AtlasAutoware/carv1/cad/Mounts/original/README.md

# Original mounts

The five STLs that were in Mounts/ before the parametric set (commit 55734f5 removed them by
mistake; restored here unchanged). They are for the original 15-hole Baseplate and do not use
the clipless foot interface.
