AtlasAutoware/carv1/cad/Electronics/srp1265a_layout.png

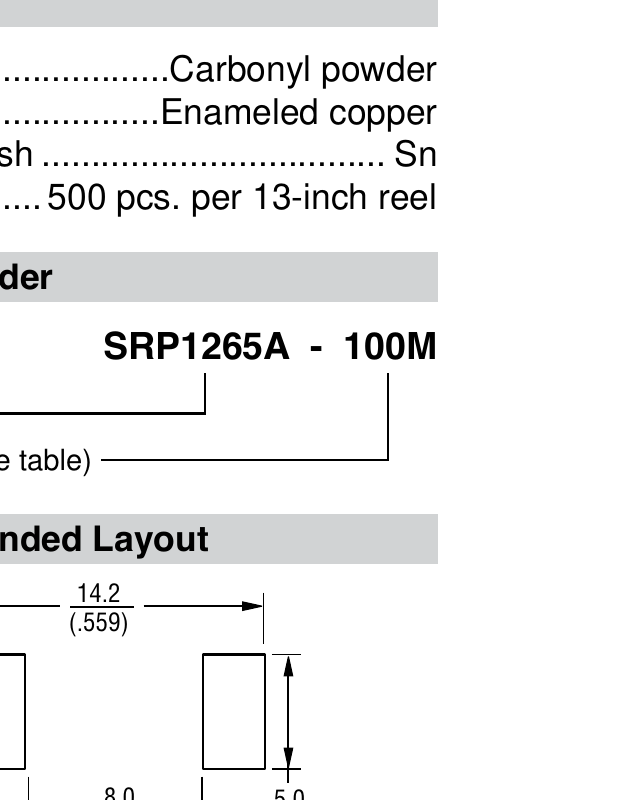
cad/Electronics/srp1265a_layout.png
