AtlasAutoware/carv1/cad/Electronics/top_preview.png

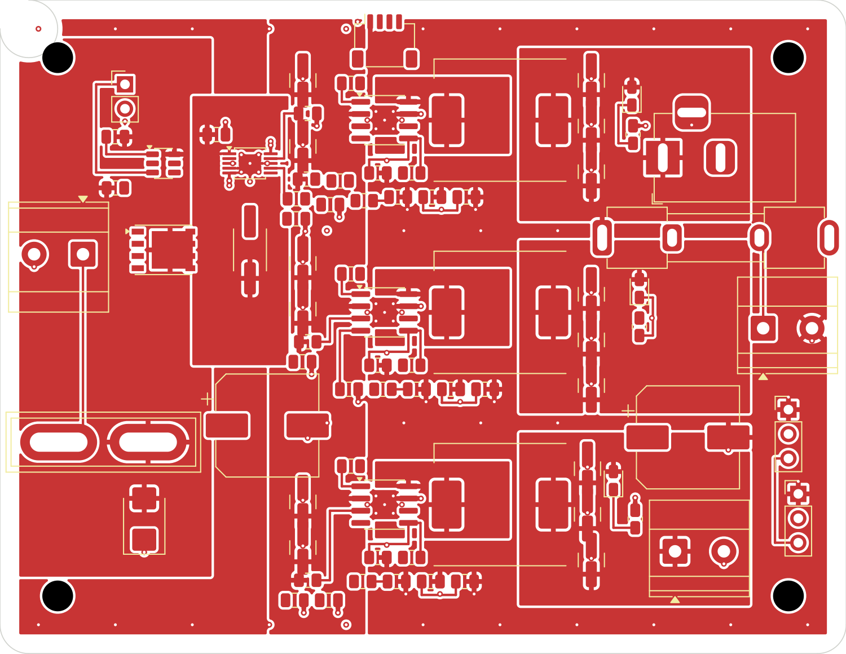
cad/Electronics/top_preview.png
