AtlasAutoware/carv1/cad/Mounts/newcar/out/baseplate_v2_newcar.png

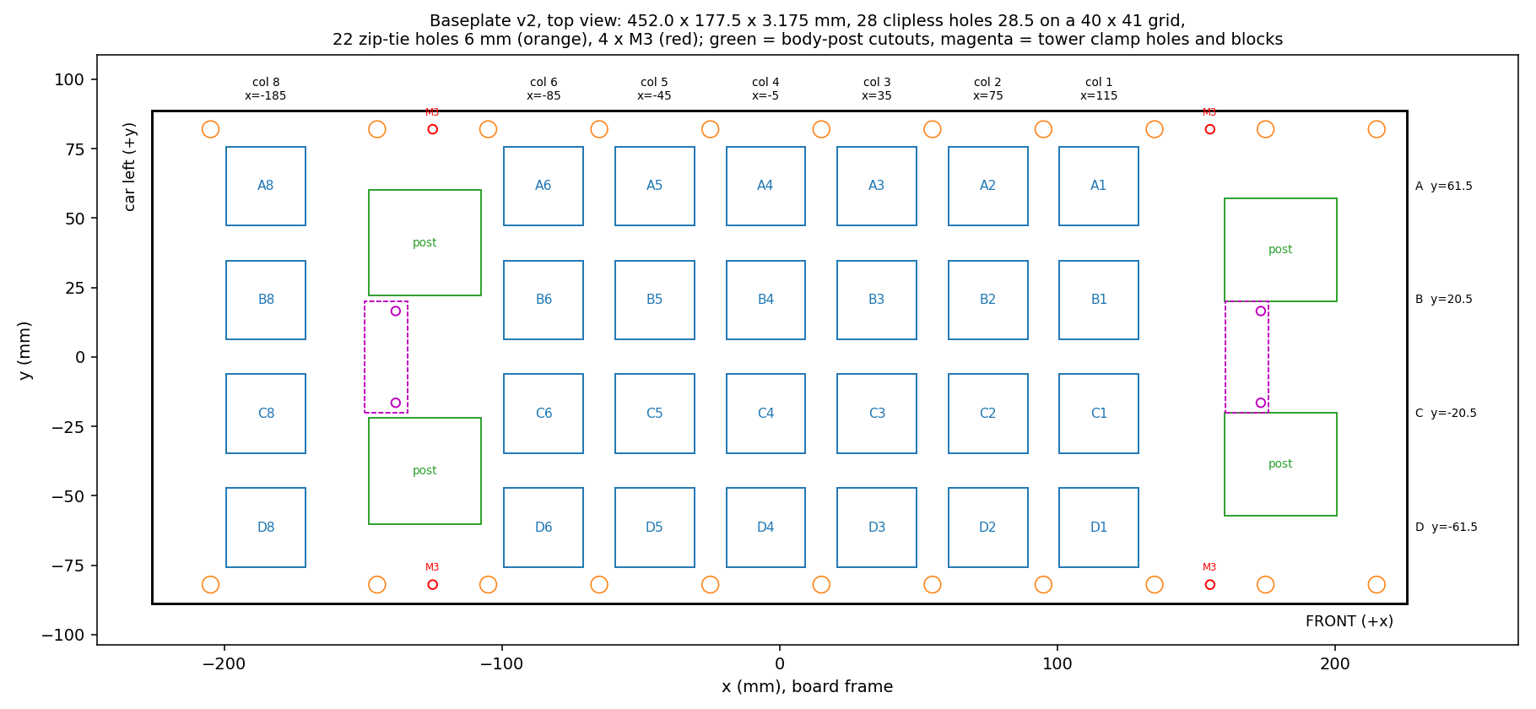
cad/Mounts/newcar/out/baseplate_v2_newcar.png
