AtlasAutoware/carv1/cad/Mounts/newcar/out/battery_bank_underslung.png

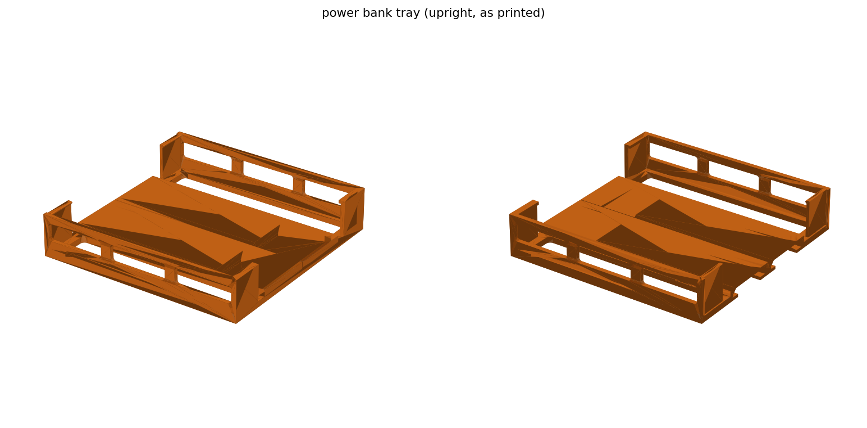
cad/Mounts/newcar/out/battery_bank_underslung.png
