AtlasAutoware/carv1/cad/Mounts/newcar/out/battery_bank_underslung_lines.png

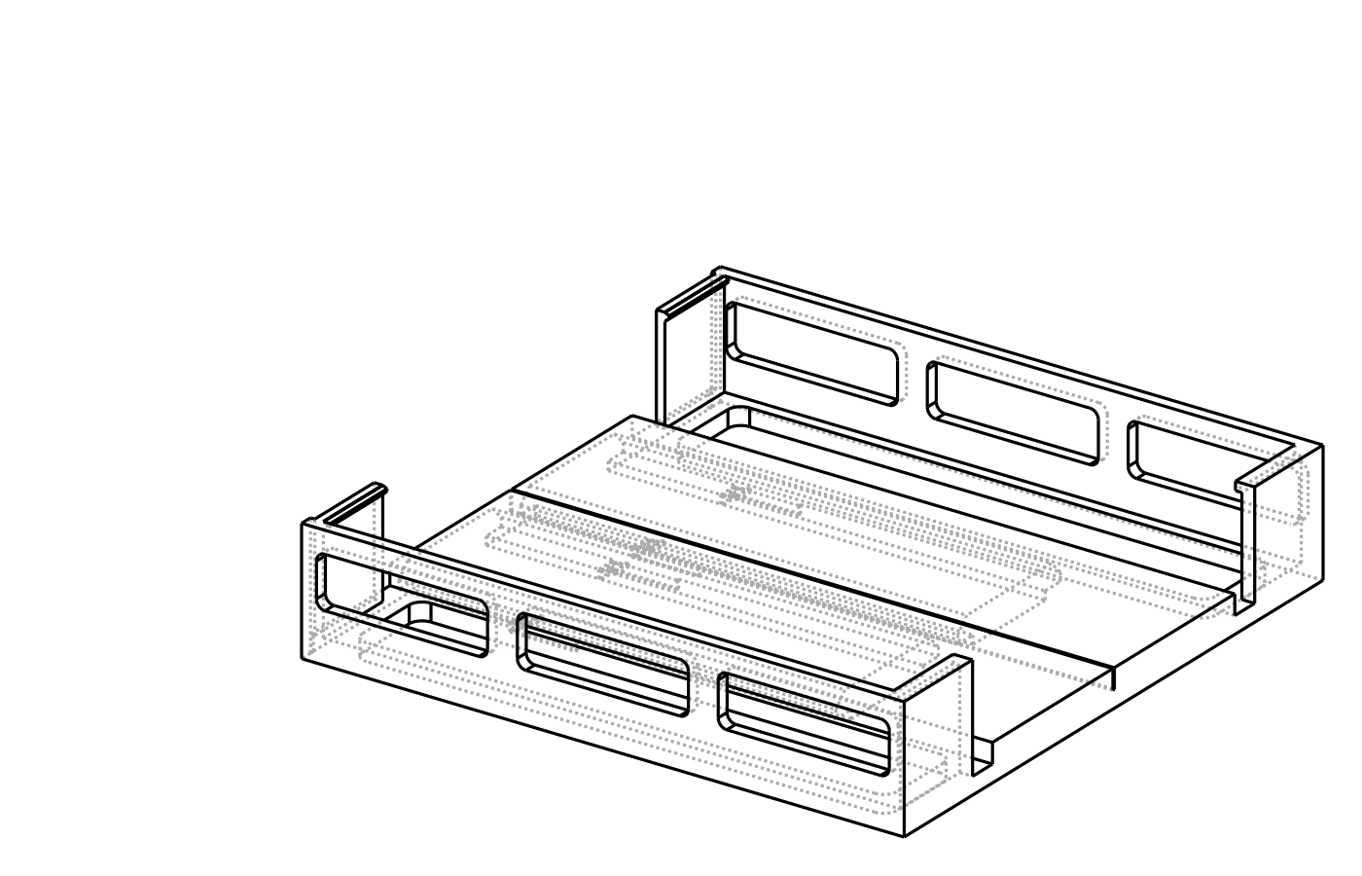
cad/Mounts/newcar/out/battery_bank_underslung_lines.png
