AtlasAutoware/carv1/cad/Mounts/newcar/out/newcar_layout_above_bottom.png

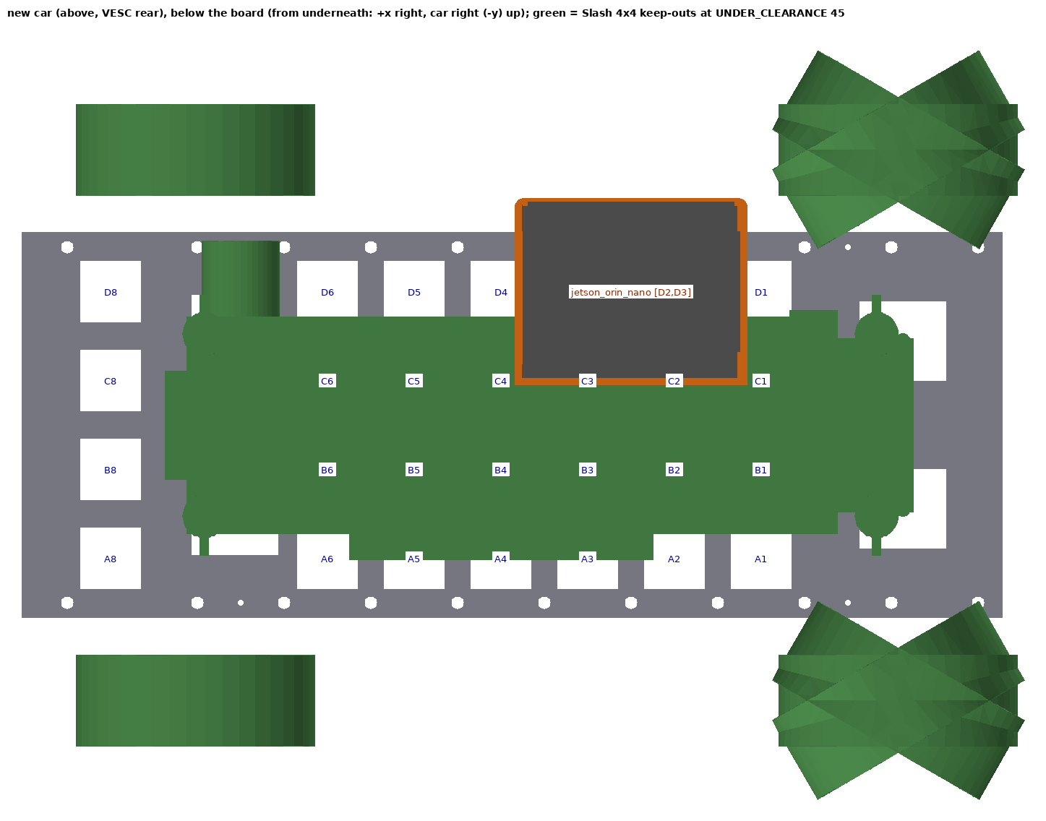
cad/Mounts/newcar/out/newcar_layout_above_bottom.png
