AtlasAutoware/carv1/cad/Mounts/newcar/out/newcar_layout_above_vescsaddle_side.png

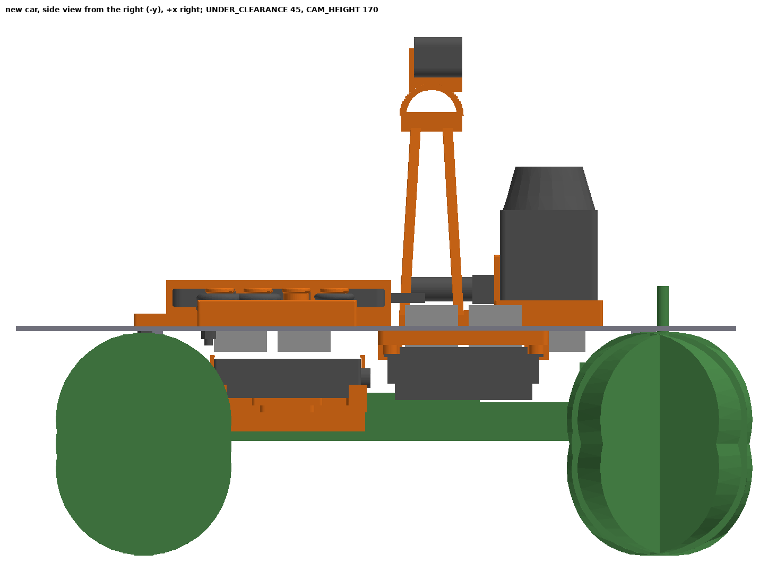
cad/Mounts/newcar/out/newcar_layout_above_vescsaddle_side.png
