AtlasAutoware/carv1/cad/Mounts/newcar/out/newcar_layout_blade100_bottom.png

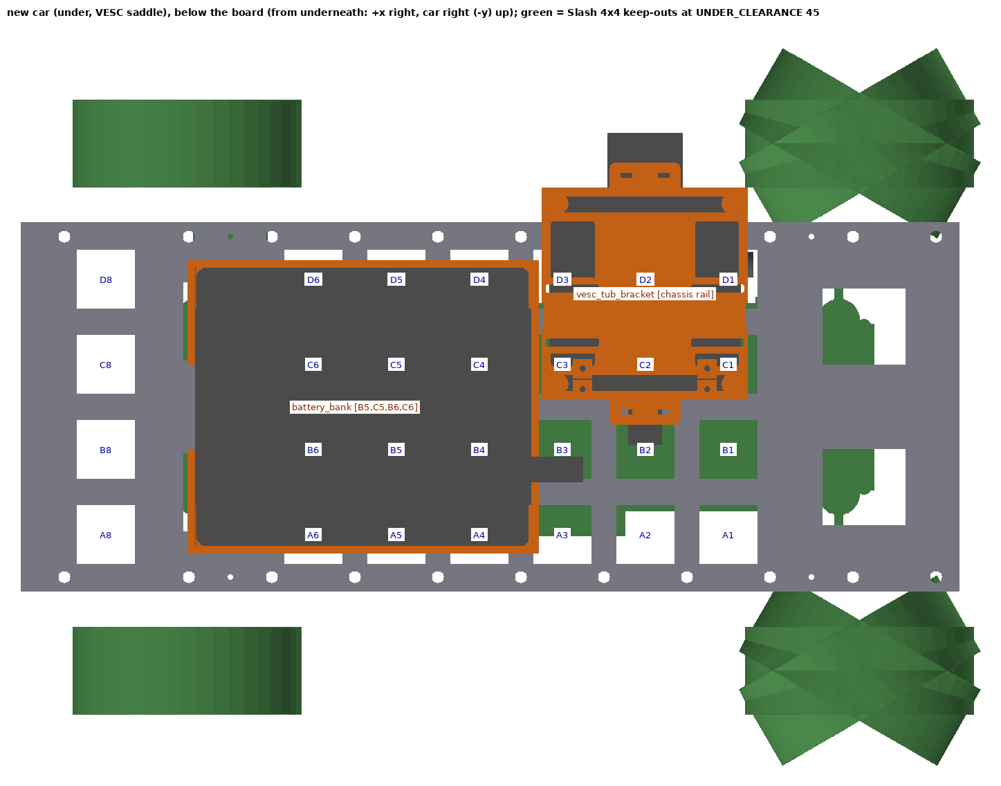
cad/Mounts/newcar/out/newcar_layout_blade100_bottom.png
