AtlasAutoware/carv1/cad/Mounts/newcar/out/newcar_layout_blade100_lines.png

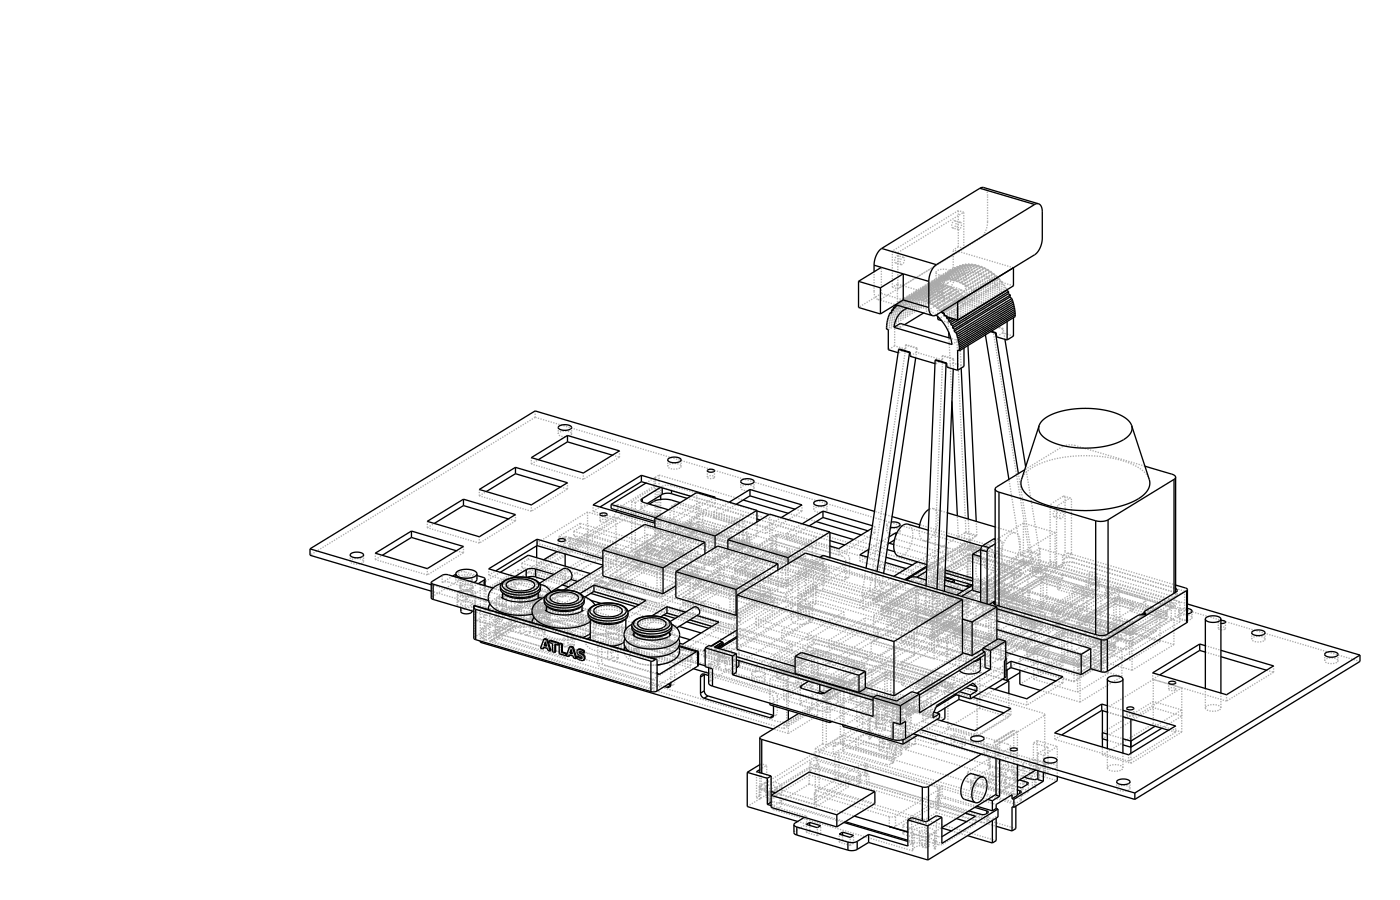
cad/Mounts/newcar/out/newcar_layout_blade100_lines.png
