AtlasAutoware/carv1/cad/Mounts/newcar/out/newcar_layout_blade100_top.png

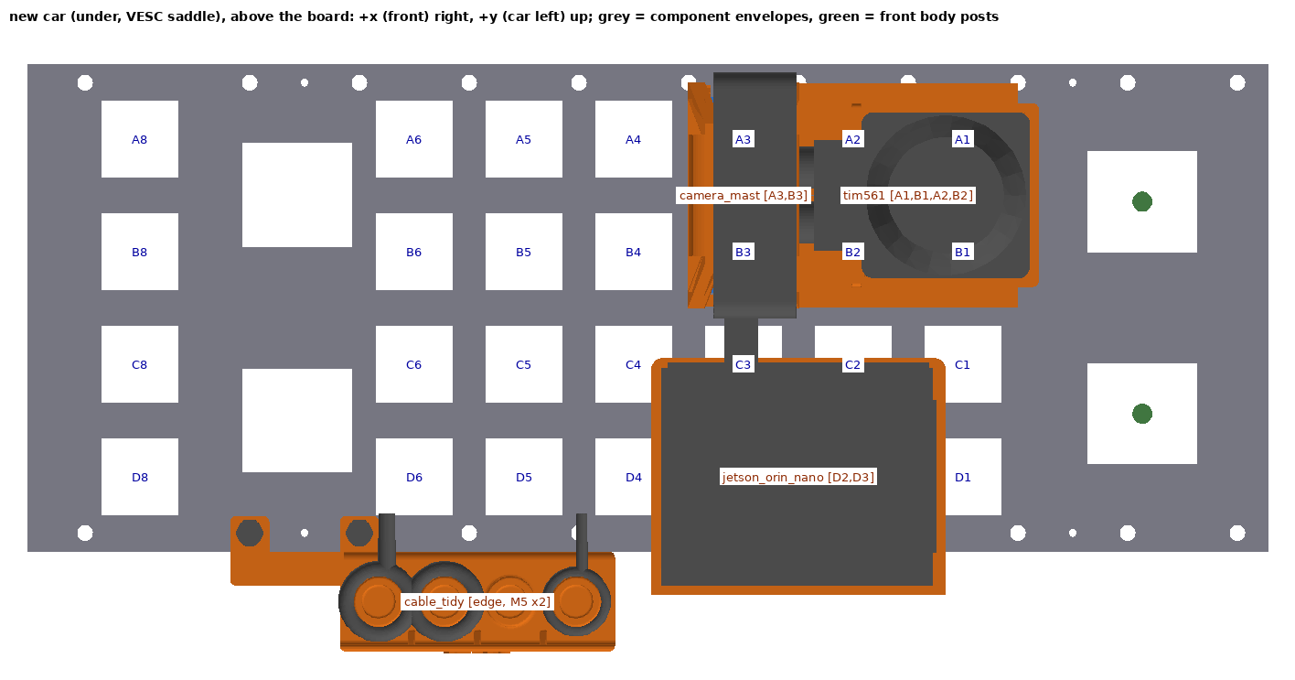
cad/Mounts/newcar/out/newcar_layout_blade100_top.png
