AtlasAutoware/carv1/cad/Mounts/newcar/out/tim561.png

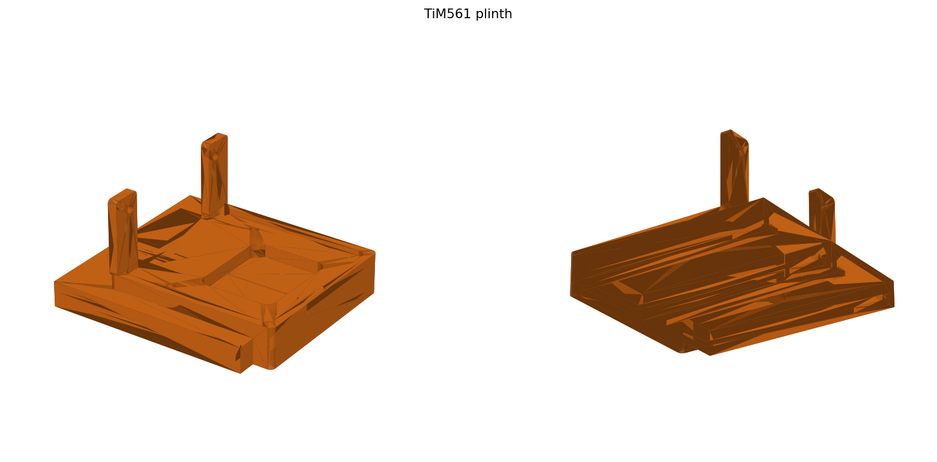
cad/Mounts/newcar/out/tim561.png
