AtlasAutoware/carv1/cad/Mounts/newcar/out/tim561_lines.png

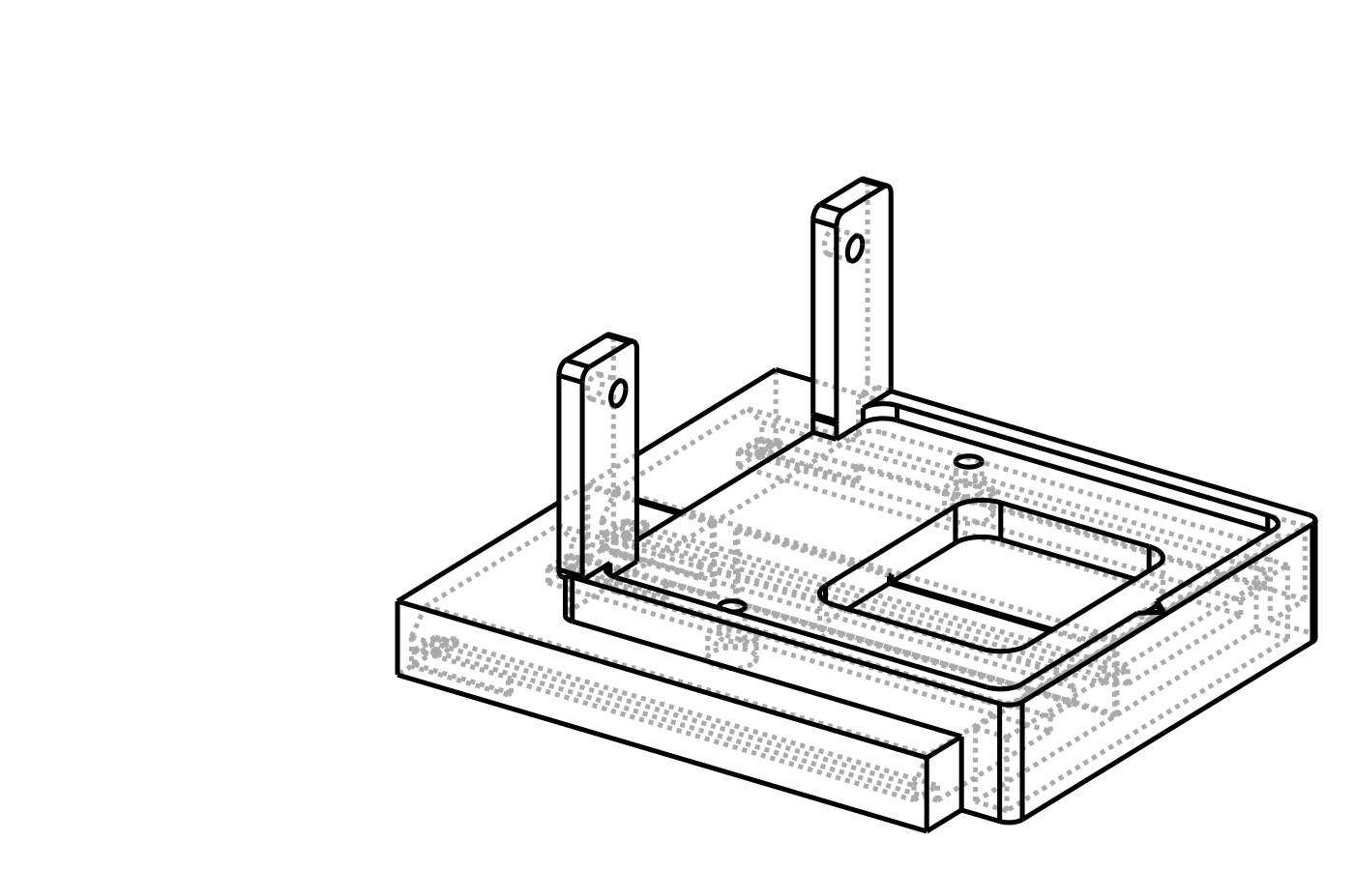
cad/Mounts/newcar/out/tim561_lines.png
