AtlasAutoware/carv1/cad/Mounts/out/_attempt_tidy_bottom.png

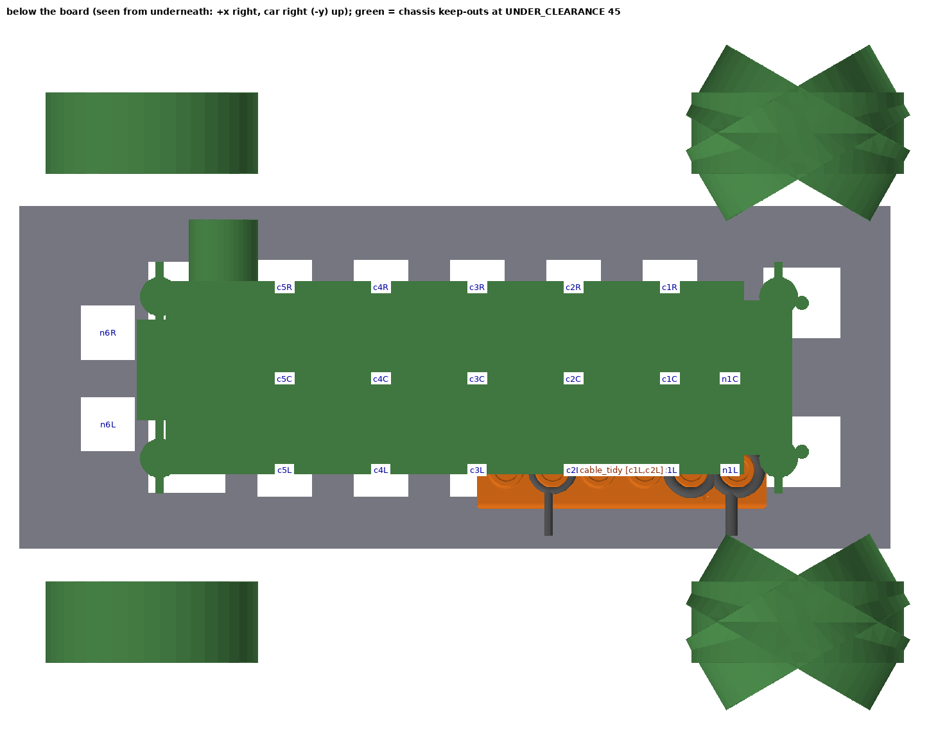
cad/Mounts/out/_attempt_tidy_bottom.png
