AtlasAutoware/carv1/cad/Mounts/out/_cable_tidy_closeup.png

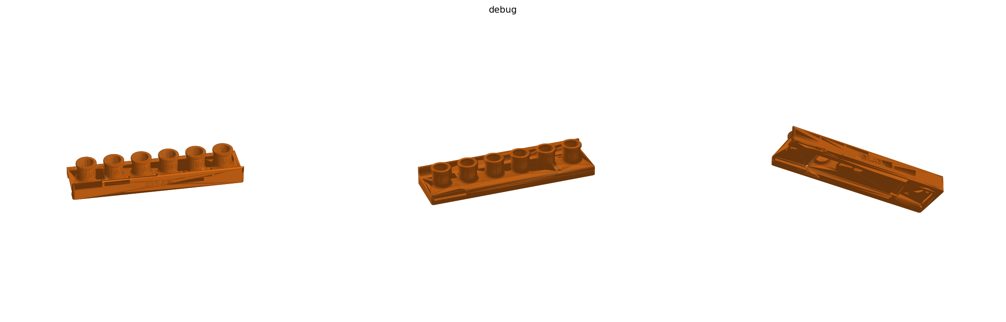
cad/Mounts/out/_cable_tidy_closeup.png
