AtlasAutoware/carv1/cad/Mounts/out/_dirtest.png

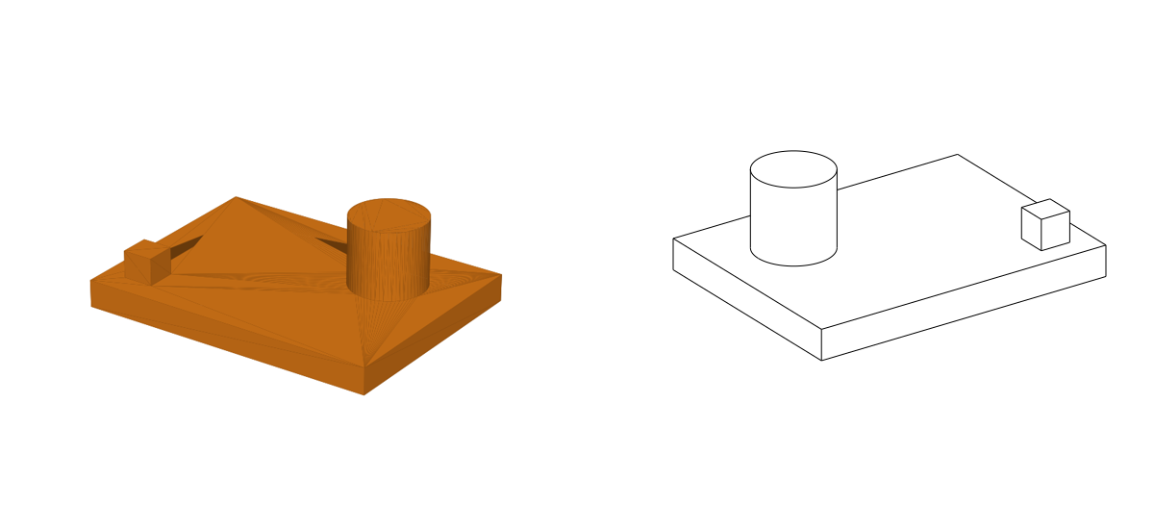
cad/Mounts/out/_dirtest.png
