AtlasAutoware/carv1/cad/Mounts/out/_omni_sections.png

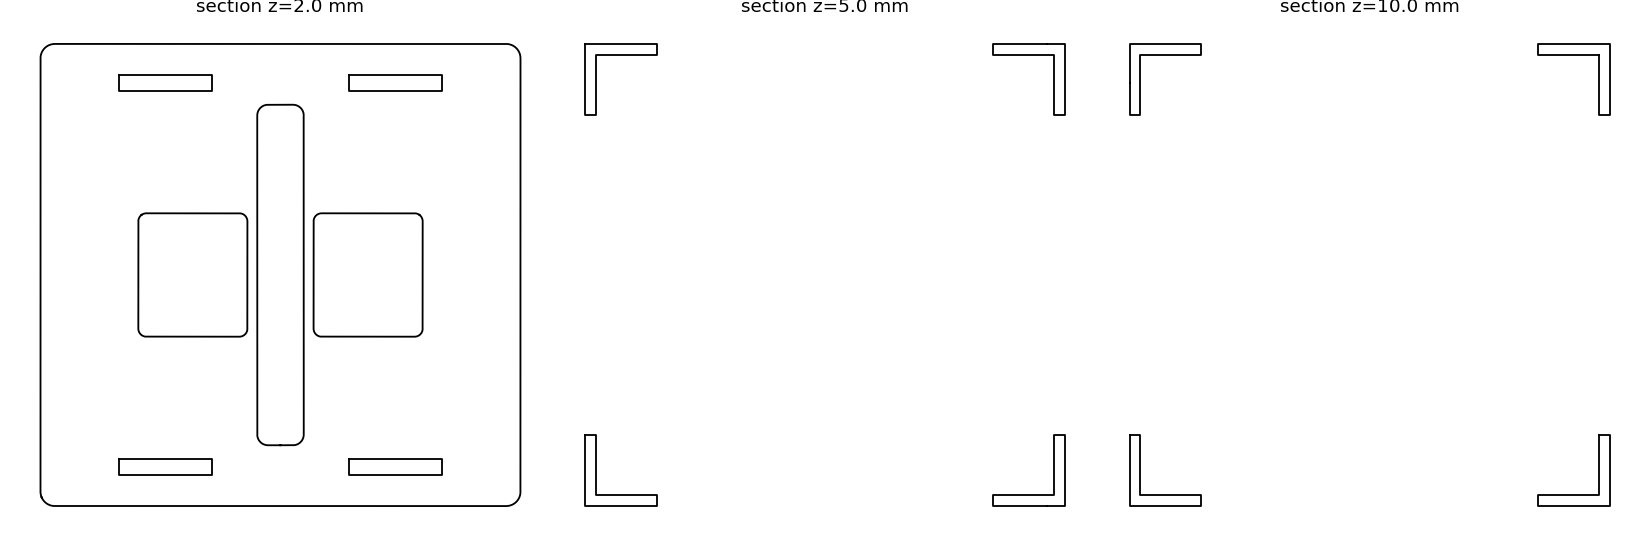
cad/Mounts/out/_omni_sections.png
