AtlasAutoware/carv1/cad/Mounts/out/baseplate_v2.png

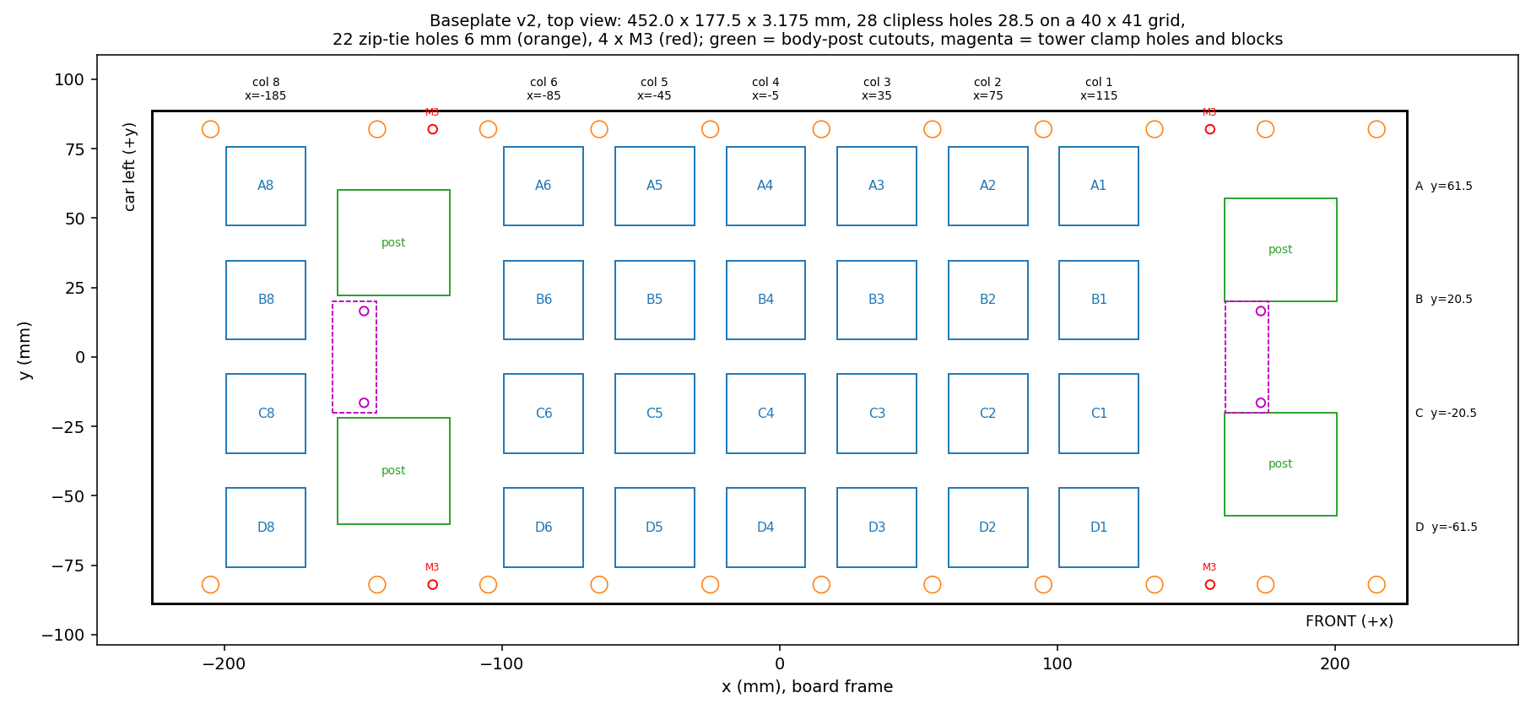
cad/Mounts/out/baseplate_v2.png
