AtlasAutoware/carv1/cad/Mounts/out/board_layout_bottom.png

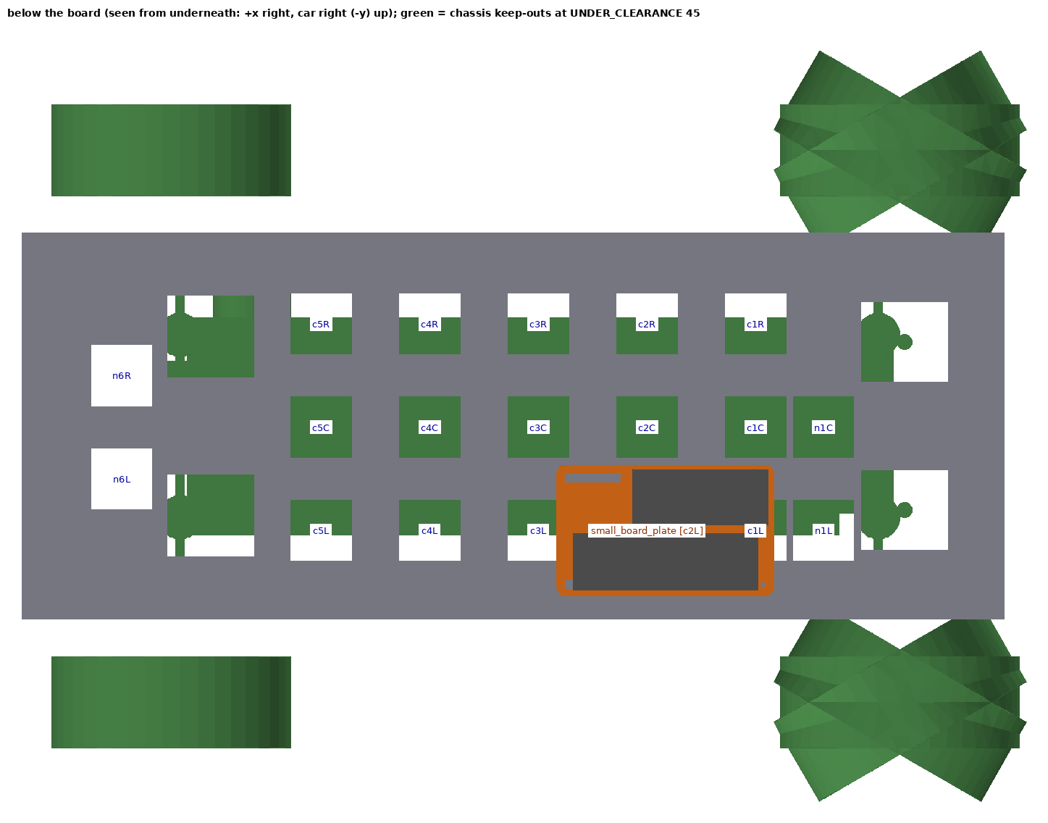
cad/Mounts/out/board_layout_bottom.png
