AtlasAutoware/carv1/cad/Mounts/out/board_layout_front.png

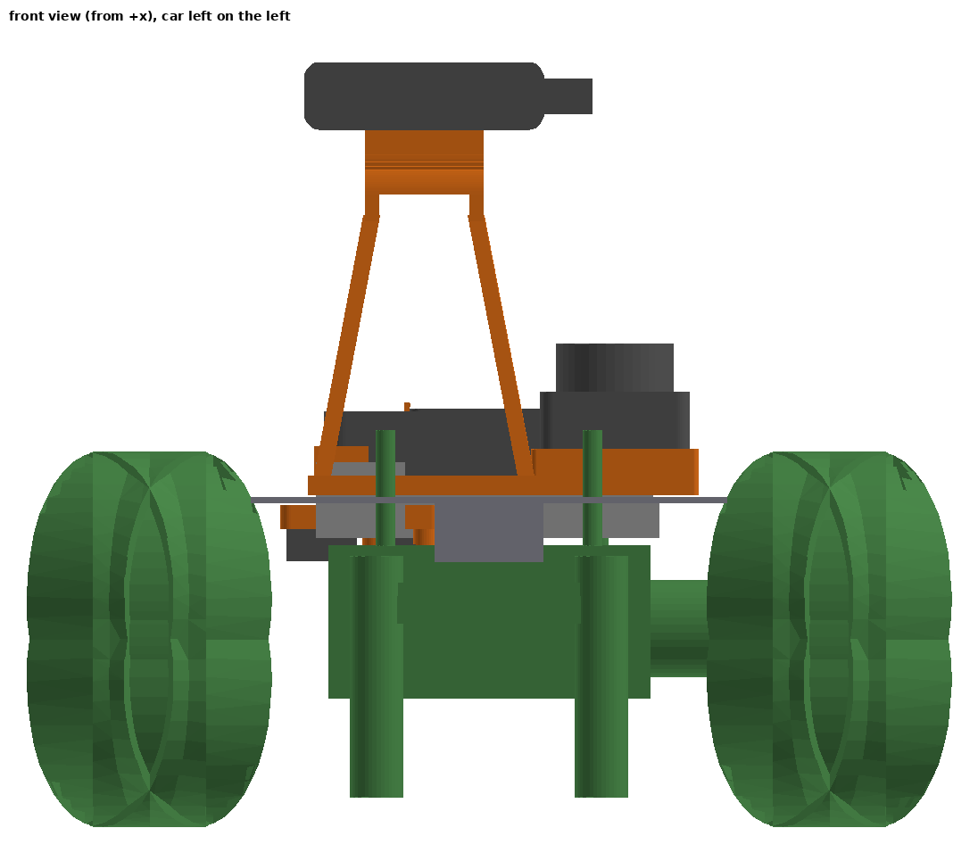
cad/Mounts/out/board_layout_front.png
