AtlasAutoware/carv1/cad/Mounts/out/board_layout_lines.png

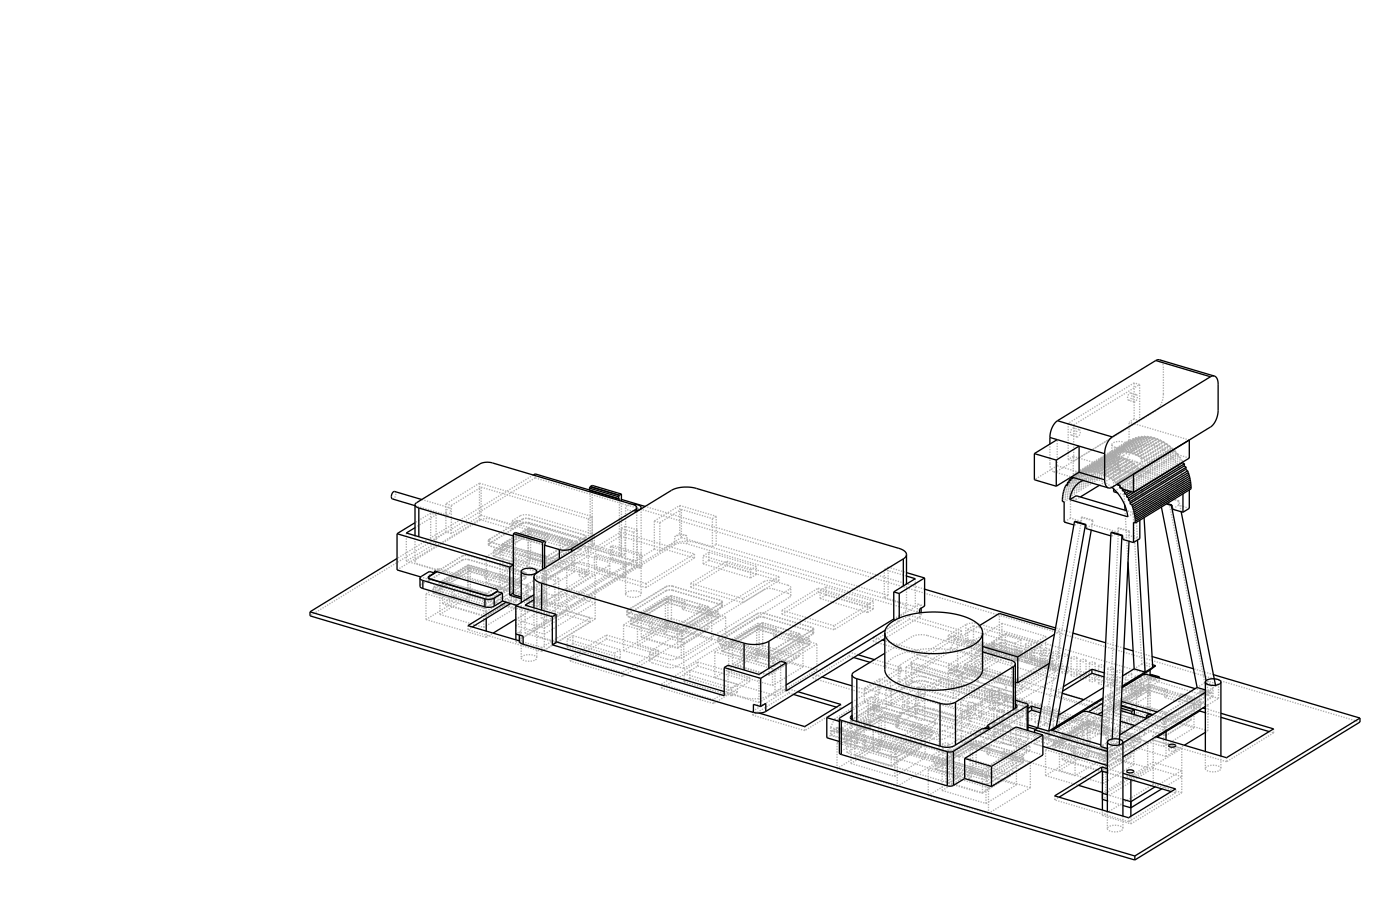
cad/Mounts/out/board_layout_lines.png
