AtlasAutoware/carv1/cad/Mounts/out/board_layout_side.png

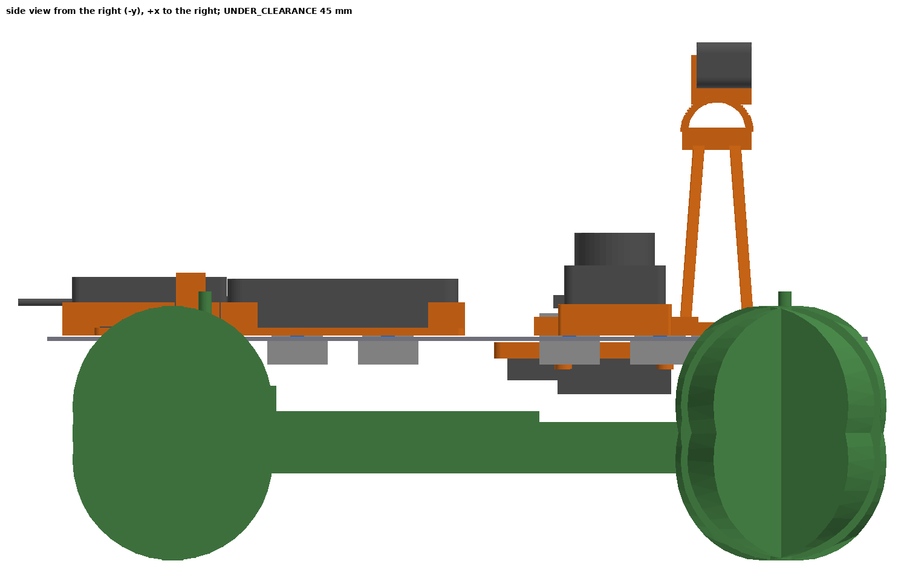
cad/Mounts/out/board_layout_side.png
