AtlasAutoware/carv1/cad/Mounts/out/board_layout_top.png

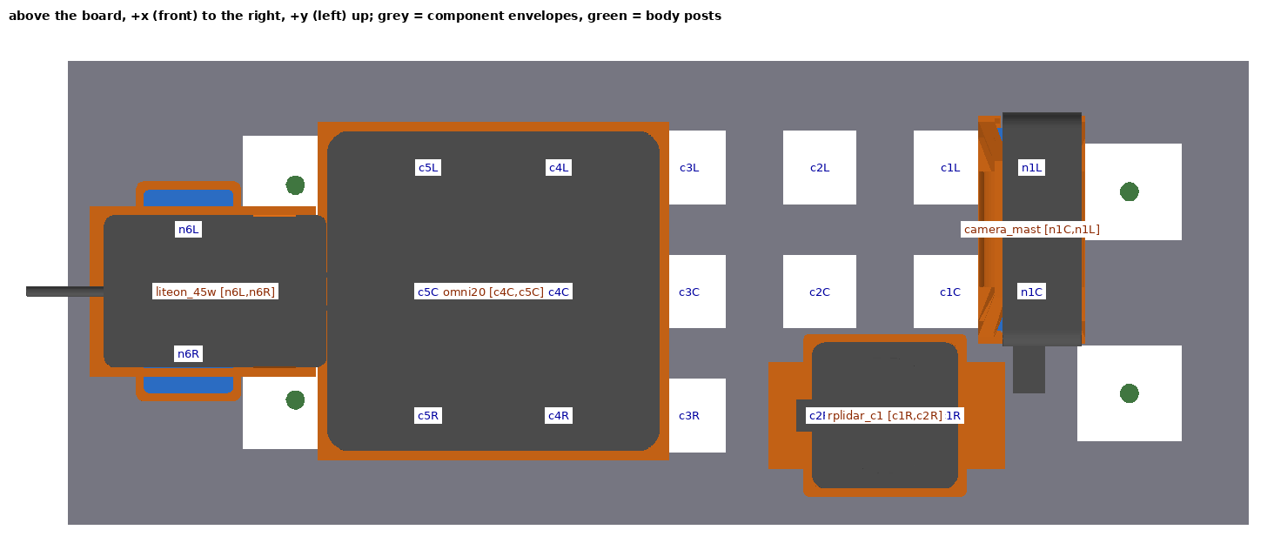
cad/Mounts/out/board_layout_top.png
