AtlasAutoware/carv1/cad/Mounts/out/board_layout_v2_bottom.png

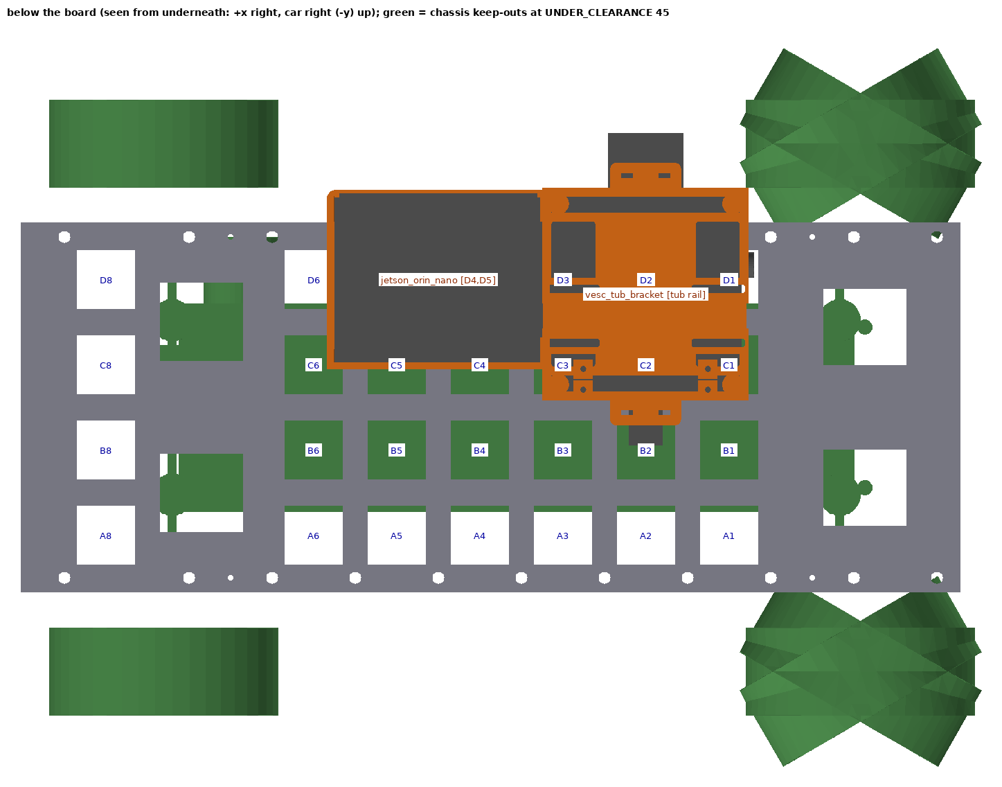
cad/Mounts/out/board_layout_v2_bottom.png
