AtlasAutoware/carv1/cad/Mounts/out/board_layout_v2_front.png

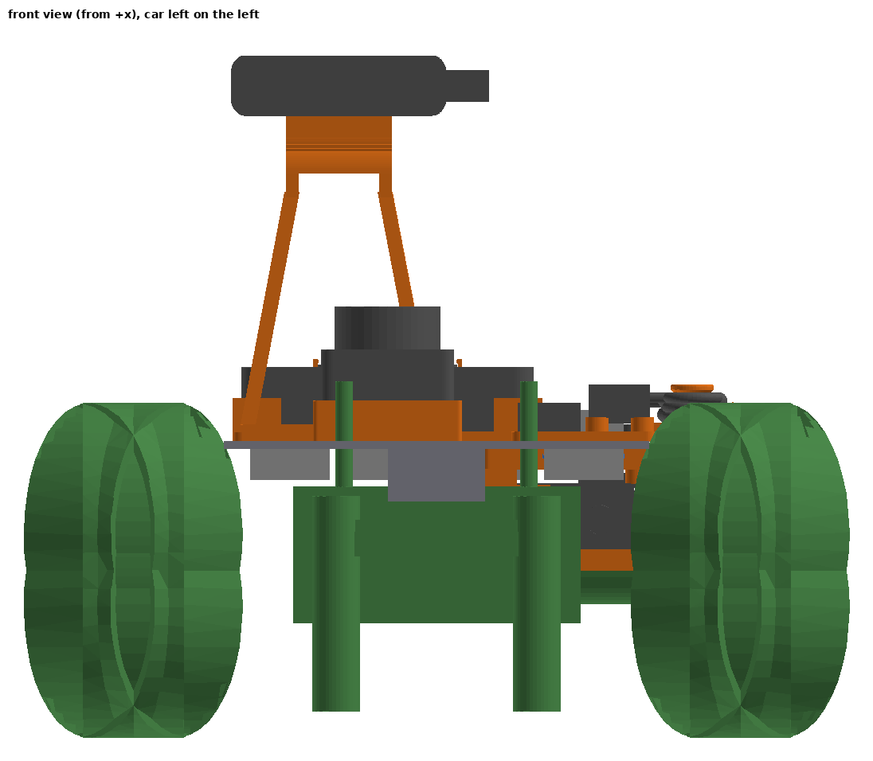
cad/Mounts/out/board_layout_v2_front.png
