AtlasAutoware/carv1/cad/Mounts/out/board_layout_v2_mastB3C3_lines.png

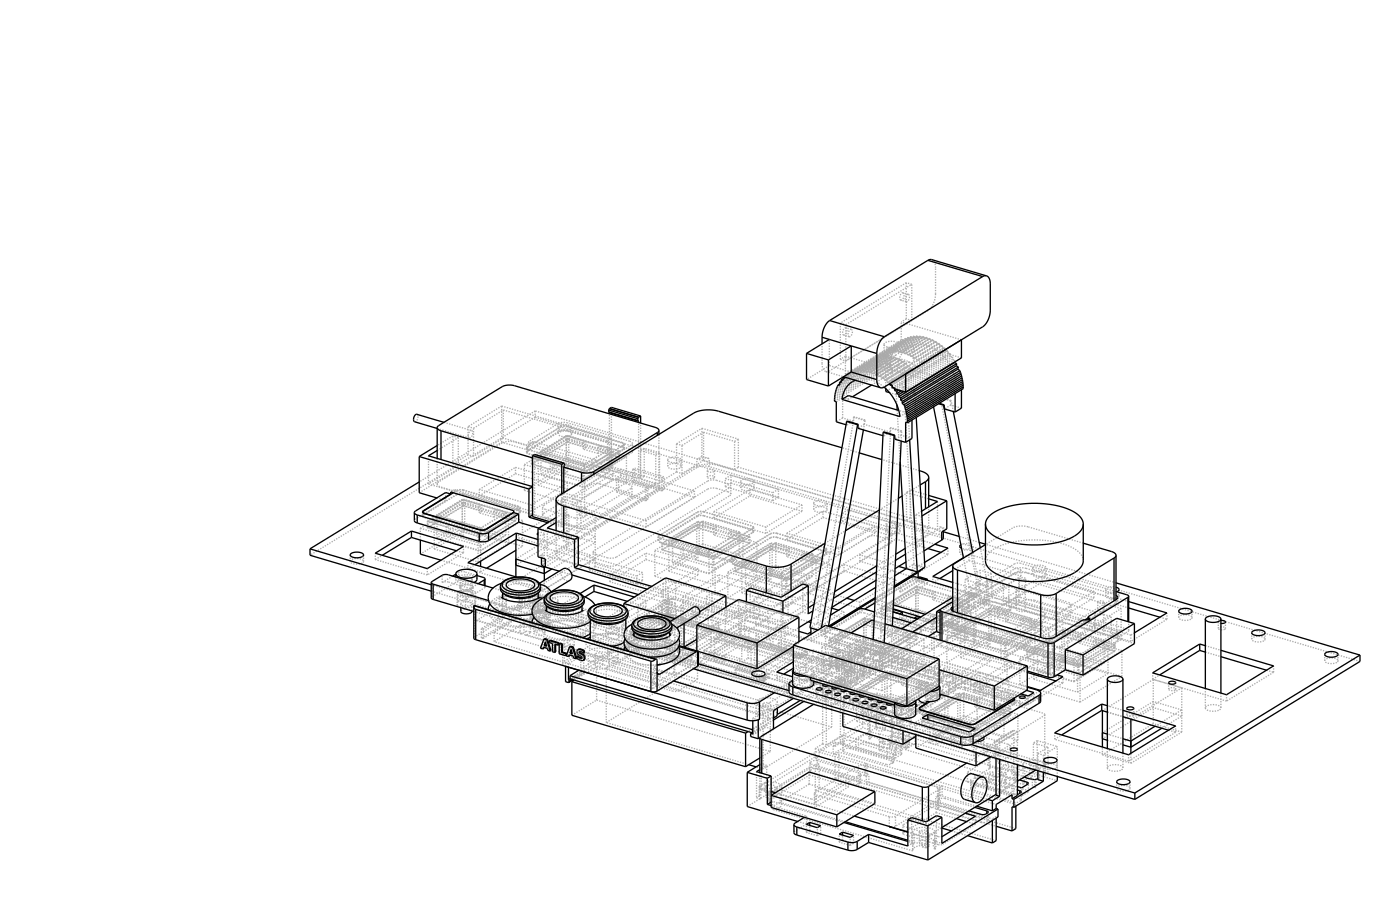
cad/Mounts/out/board_layout_v2_mastB3C3_lines.png
