AtlasAutoware/carv1/cad/Mounts/out/board_layout_v2_mastB4C4_lines.png

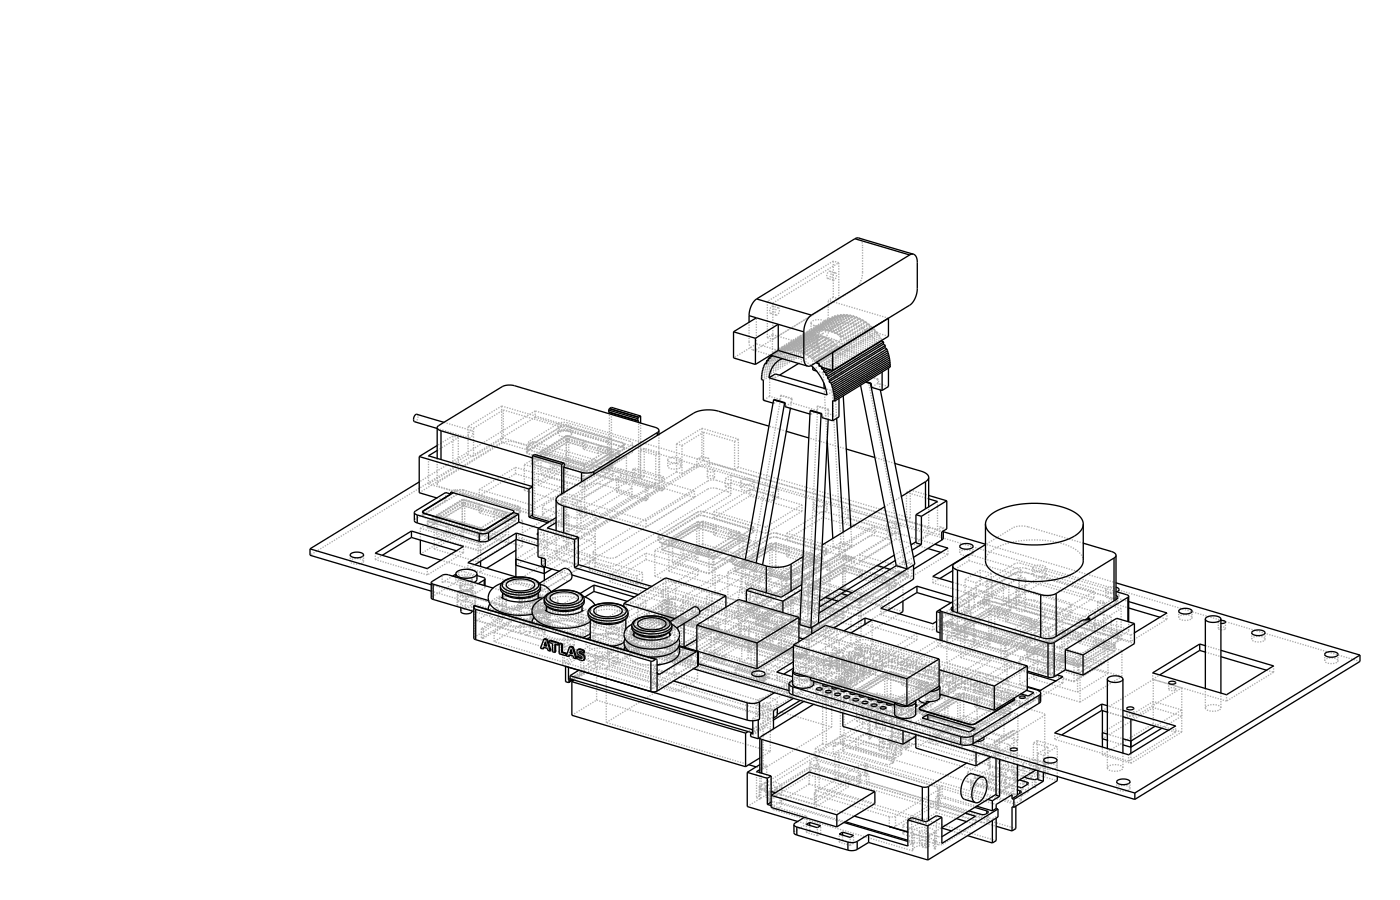
cad/Mounts/out/board_layout_v2_mastB4C4_lines.png
