AtlasAutoware/carv1/cad/Mounts/out/board_layout_v2_tidy_bottom.png

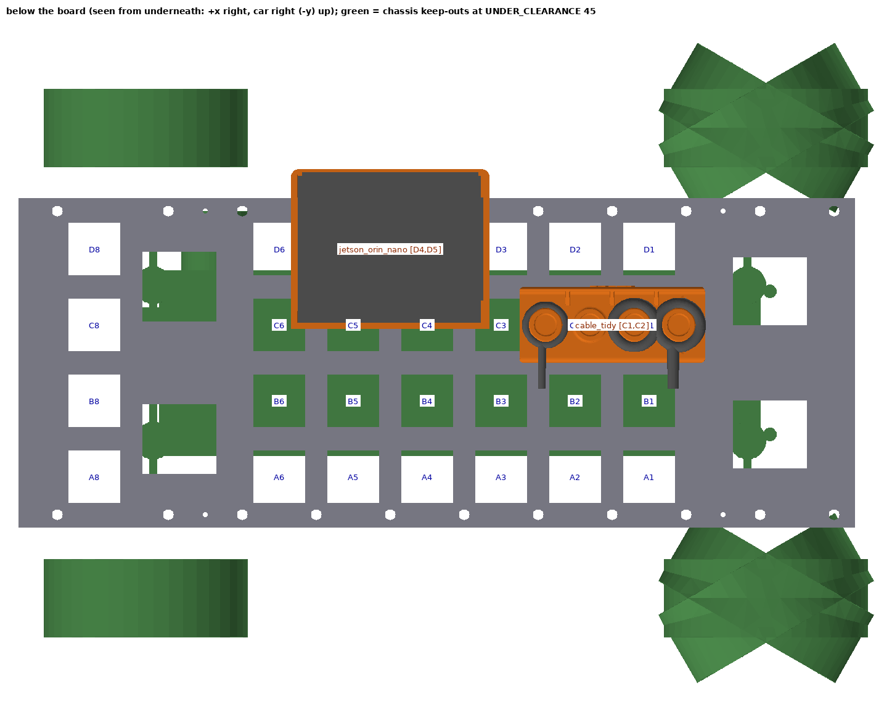
cad/Mounts/out/board_layout_v2_tidy_bottom.png
