AtlasAutoware/carv1/cad/Mounts/out/board_layout_v2_tidy_lines.png

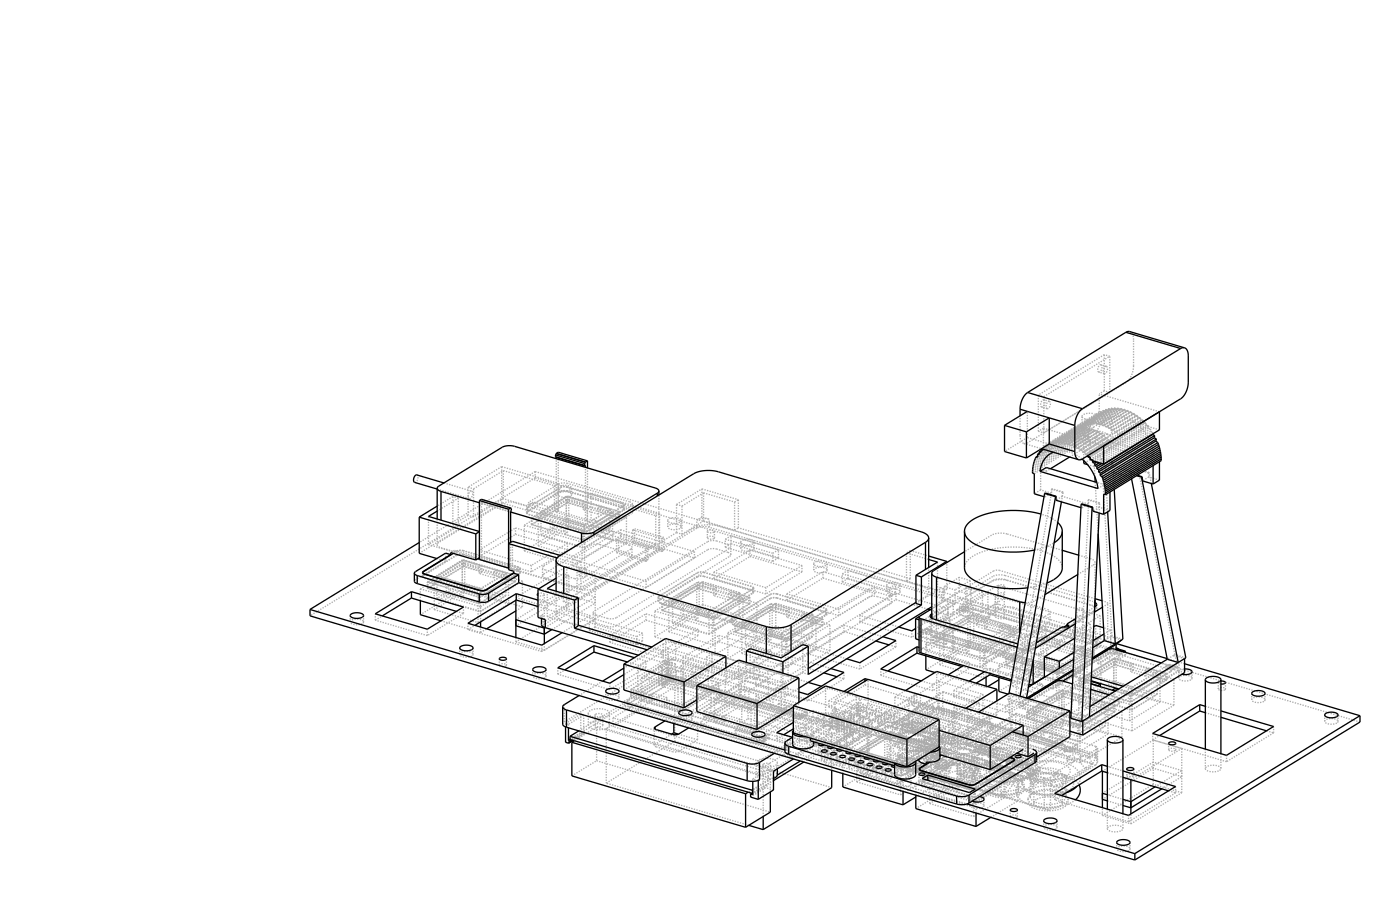
cad/Mounts/out/board_layout_v2_tidy_lines.png
