AtlasAutoware/carv1/cad/Mounts/out/board_layout_v2_tidy_side.png

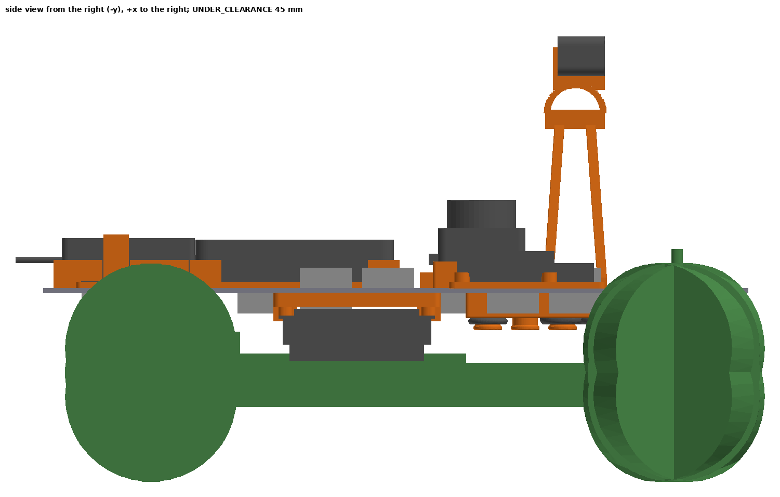
cad/Mounts/out/board_layout_v2_tidy_side.png
