AtlasAutoware/carv1/cad/Mounts/out/board_layout_v2_tidy_top.png

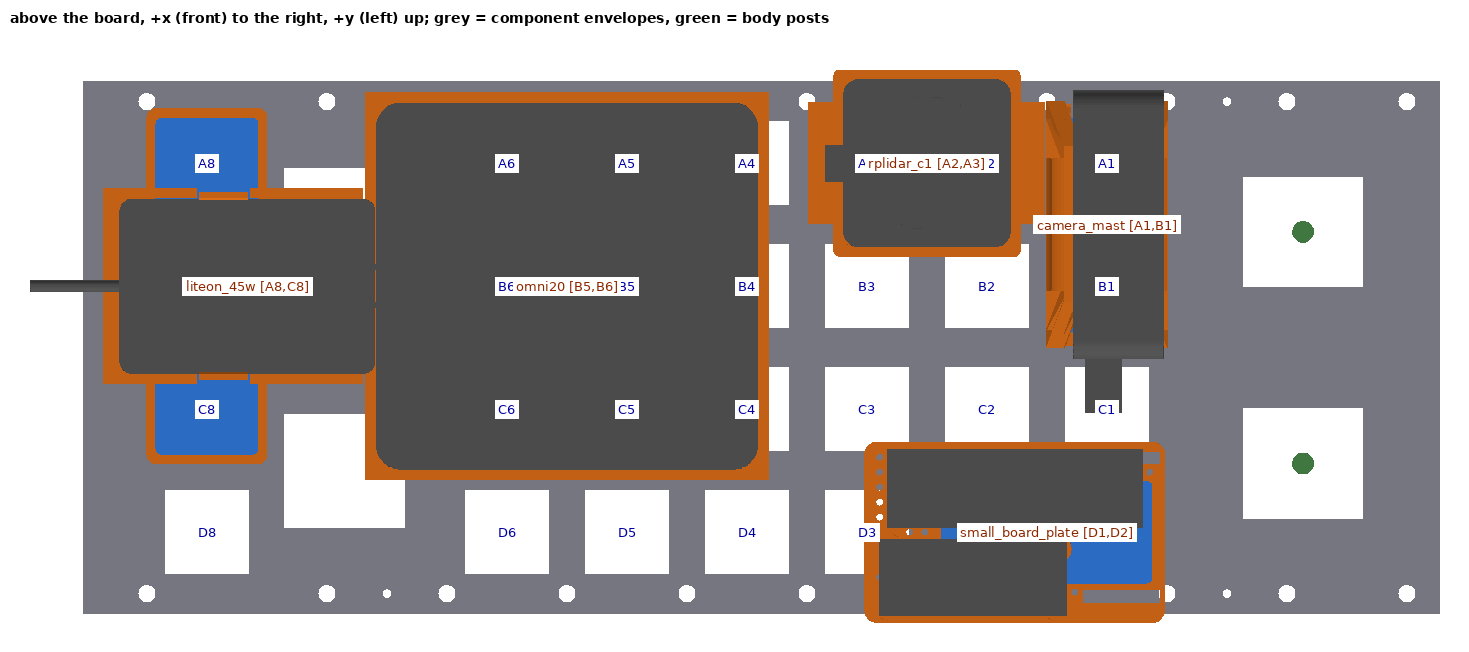
cad/Mounts/out/board_layout_v2_tidy_top.png
