AtlasAutoware/carv1/cad/Mounts/out/board_layout_v2_vesc_bottom.png

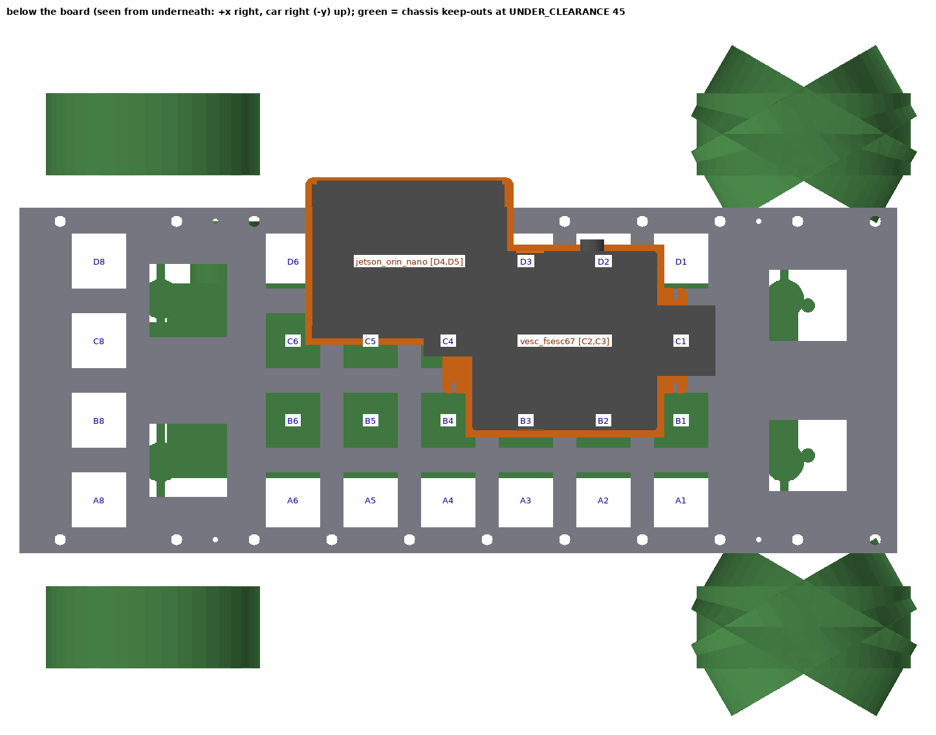
cad/Mounts/out/board_layout_v2_vesc_bottom.png
