AtlasAutoware/carv1/cad/Mounts/out/cable_tidy.png

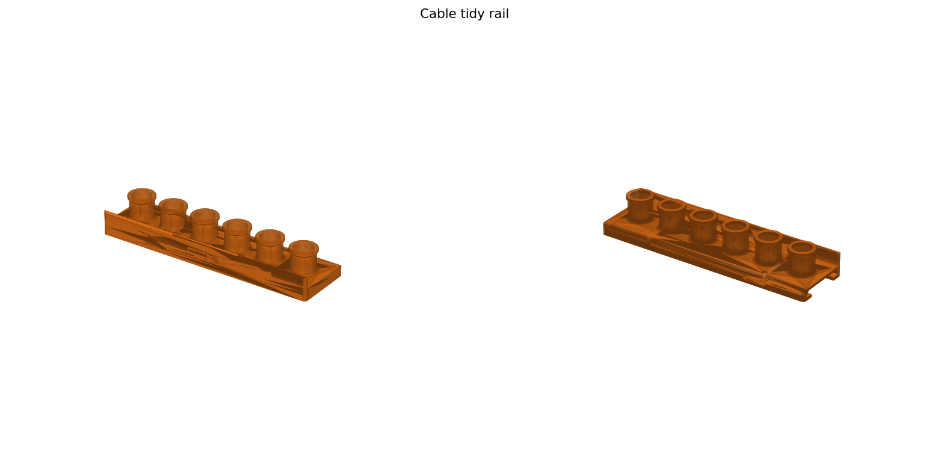
cad/Mounts/out/cable_tidy.png
