AtlasAutoware/carv1/cad/Mounts/out/cable_tidy_100_lines.png

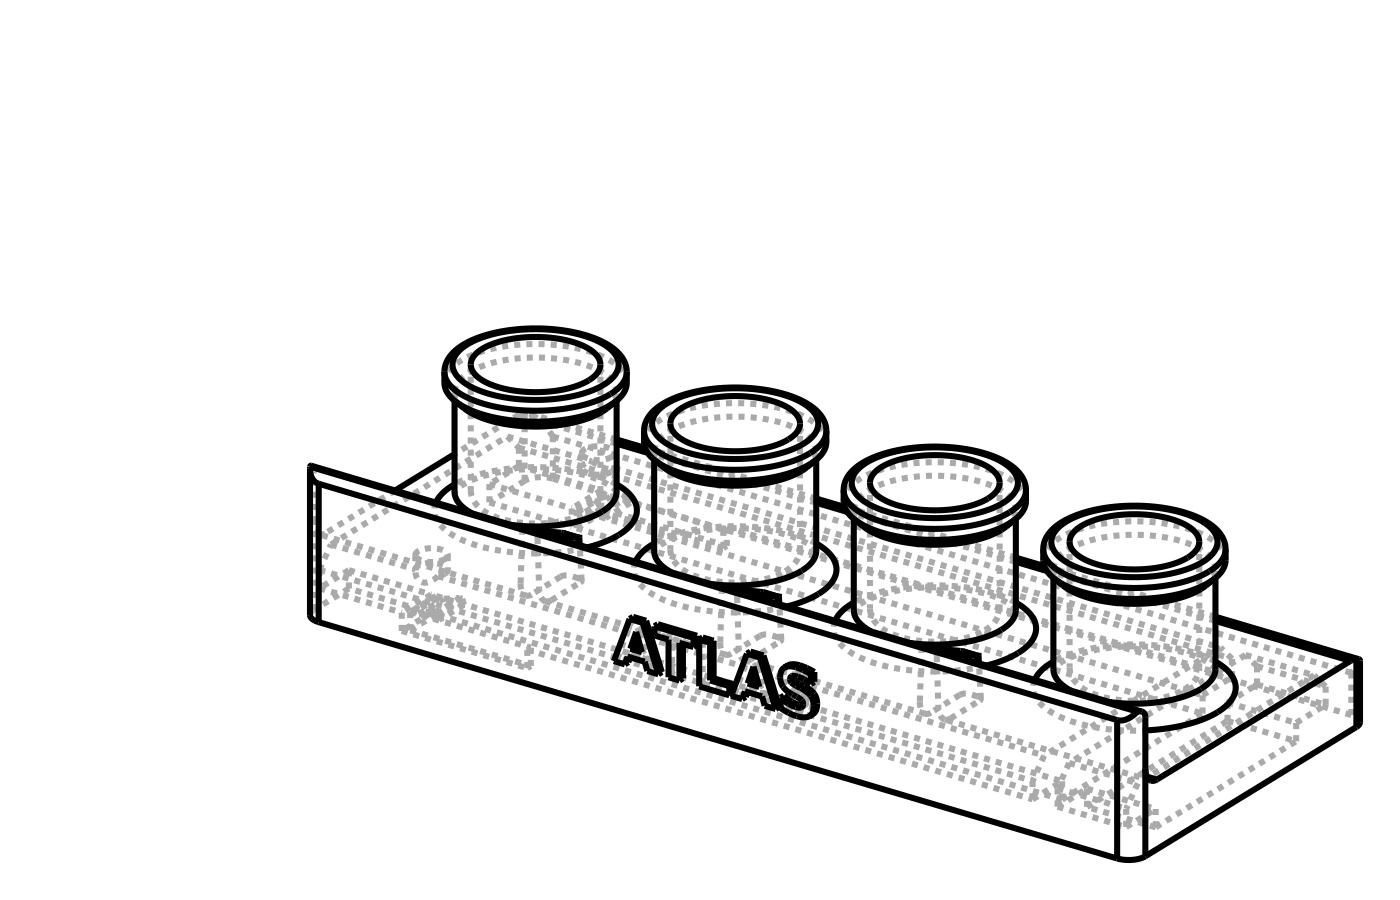
cad/Mounts/out/cable_tidy_100_lines.png
