AtlasAutoware/carv1/cad/Mounts/out/cable_tidy_edge_lines.png

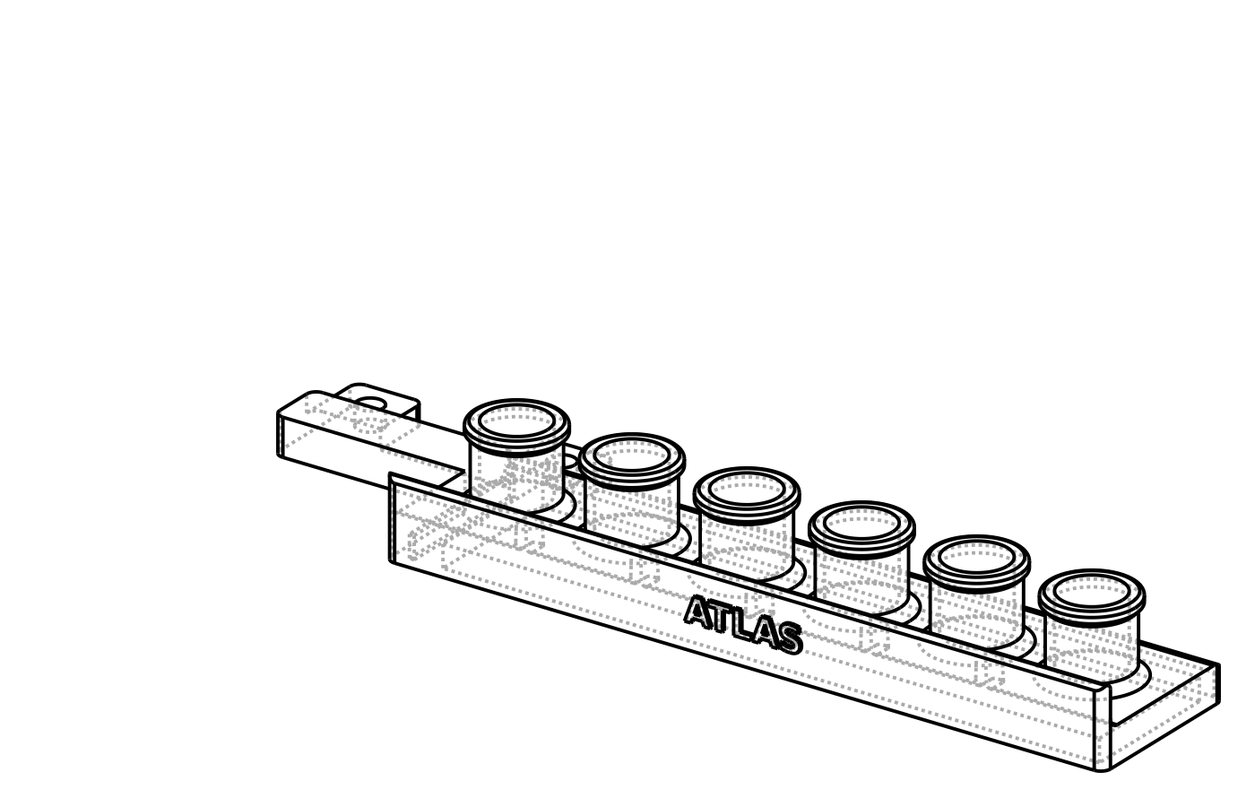
cad/Mounts/out/cable_tidy_edge_lines.png
