AtlasAutoware/carv1/cad/Mounts/out/cable_tidy_lines.png

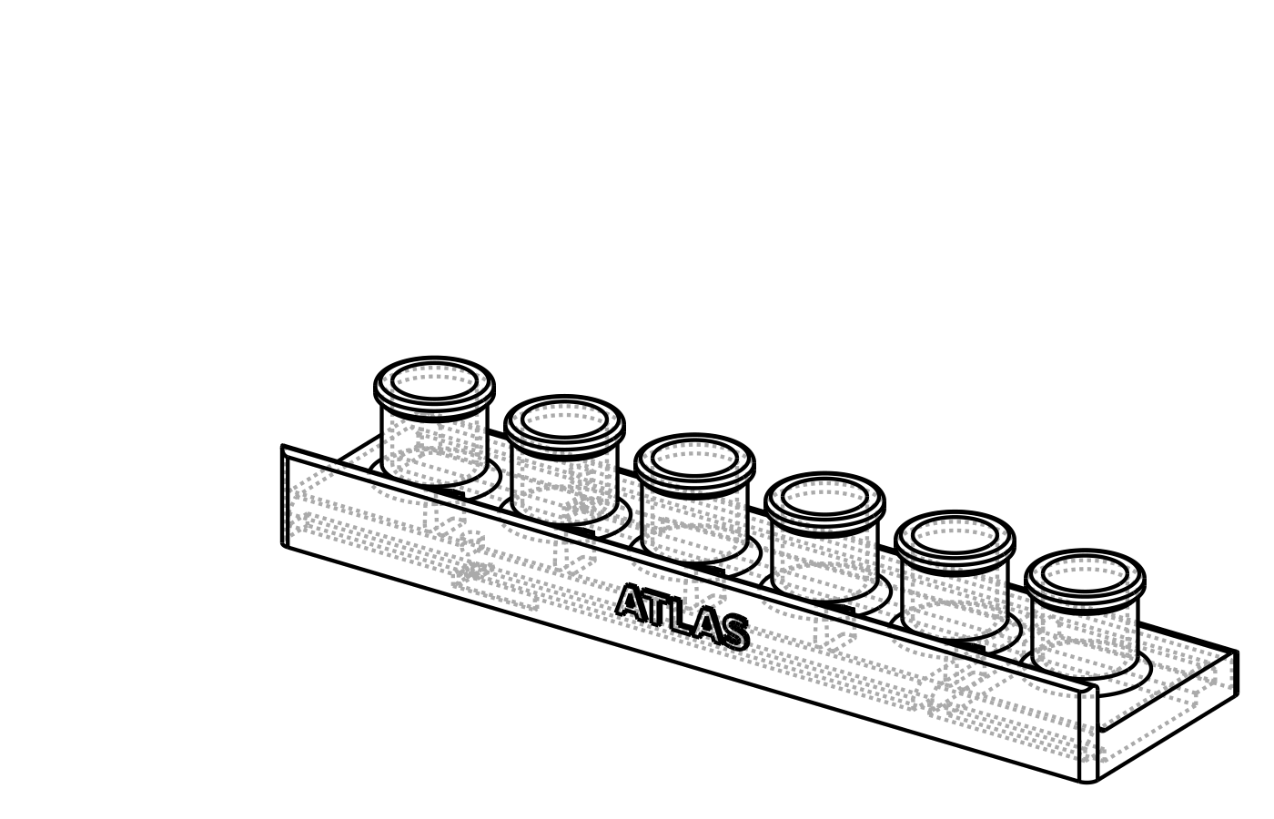
cad/Mounts/out/cable_tidy_lines.png
