AtlasAutoware/carv1/cad/Mounts/out/camera_head_fit1.png

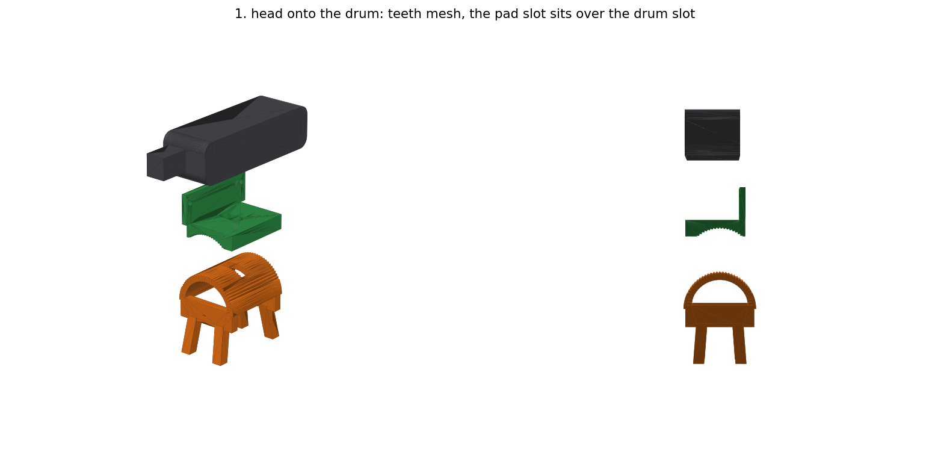
cad/Mounts/out/camera_head_fit1.png
