AtlasAutoware/carv1/cad/Mounts/out/camera_head_fit3.png

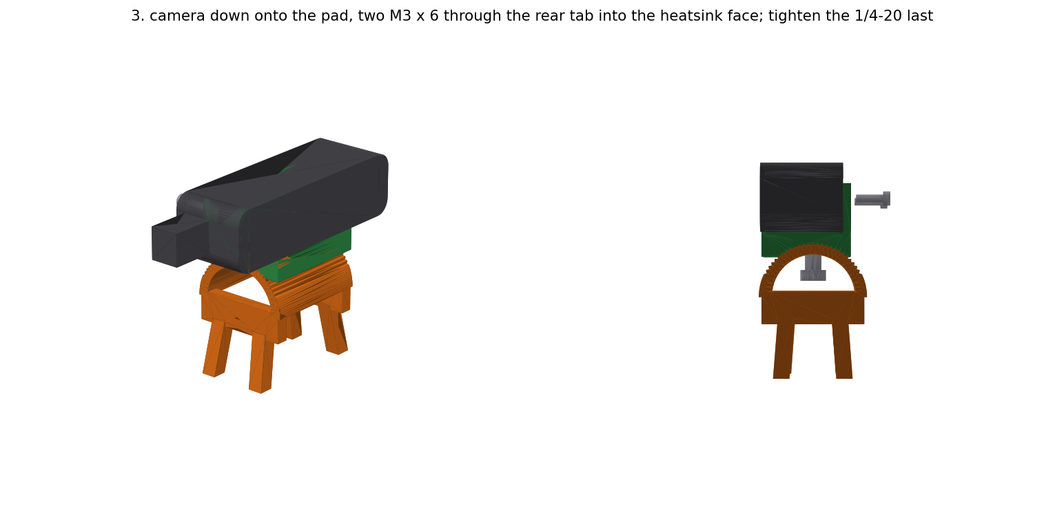
cad/Mounts/out/camera_head_fit3.png
