AtlasAutoware/carv1/cad/Mounts/out/camera_head_fit4.png

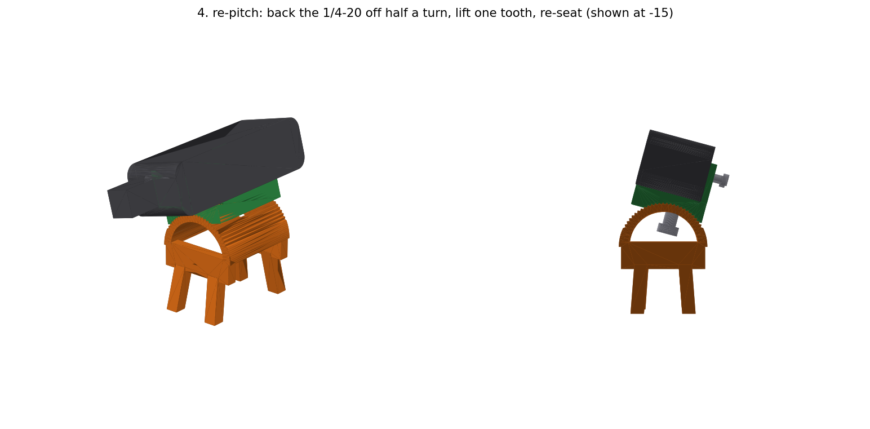
cad/Mounts/out/camera_head_fit4.png
