AtlasAutoware/carv1/cad/Mounts/out/camera_head_fit.png

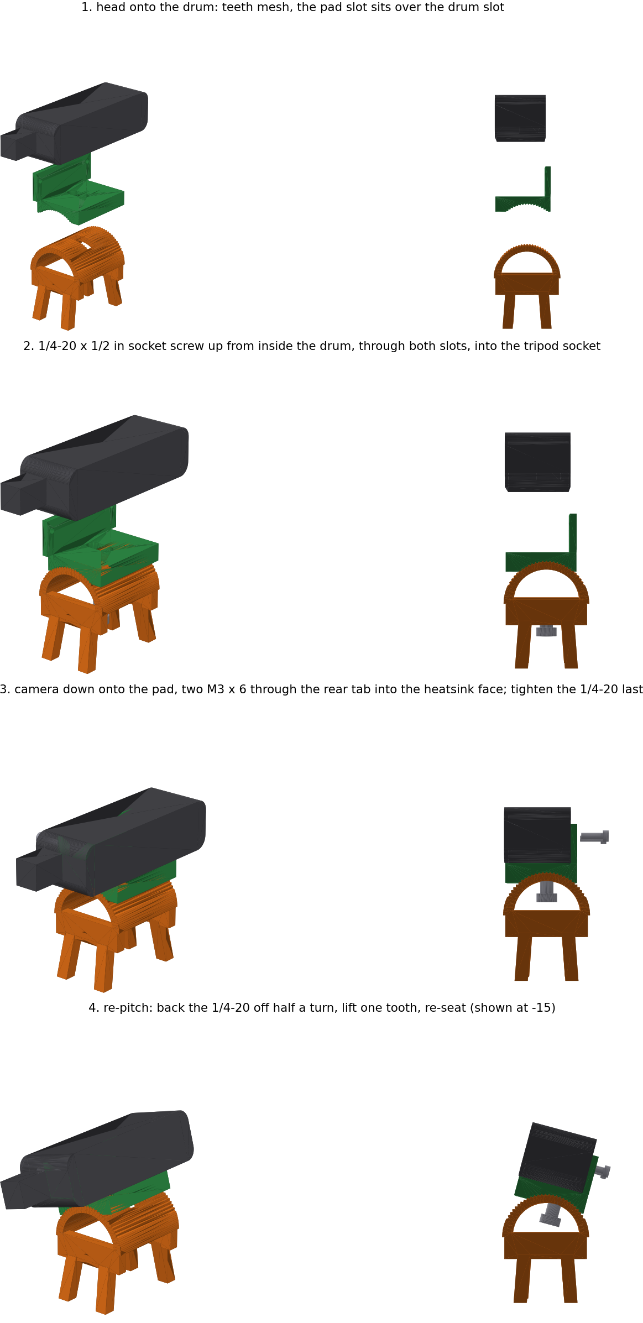
cad/Mounts/out/camera_head_fit.png
