AtlasAutoware/carv1/cad/Mounts/out/camera_mast.png

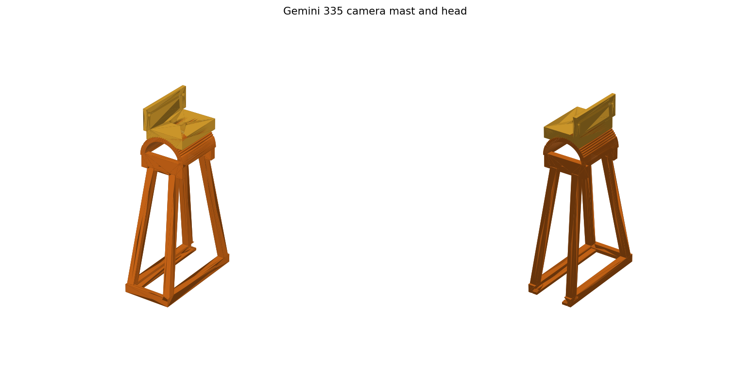
cad/Mounts/out/camera_mast.png
