AtlasAutoware/carv1/cad/Mounts/out/camera_mast_lines.png

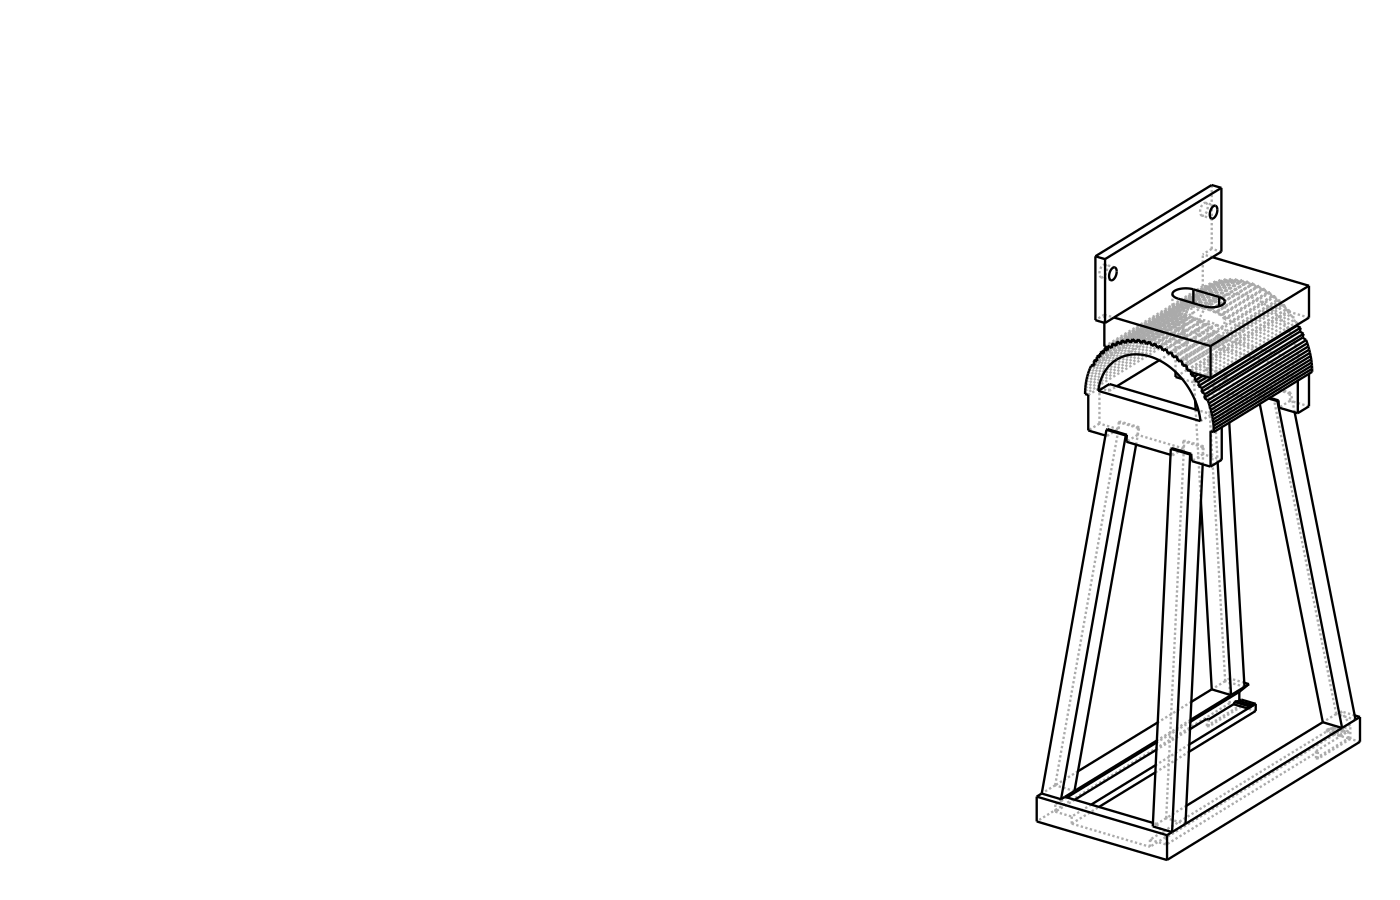
cad/Mounts/out/camera_mast_lines.png
