AtlasAutoware/carv1/cad/Mounts/out/clipless_foot.png

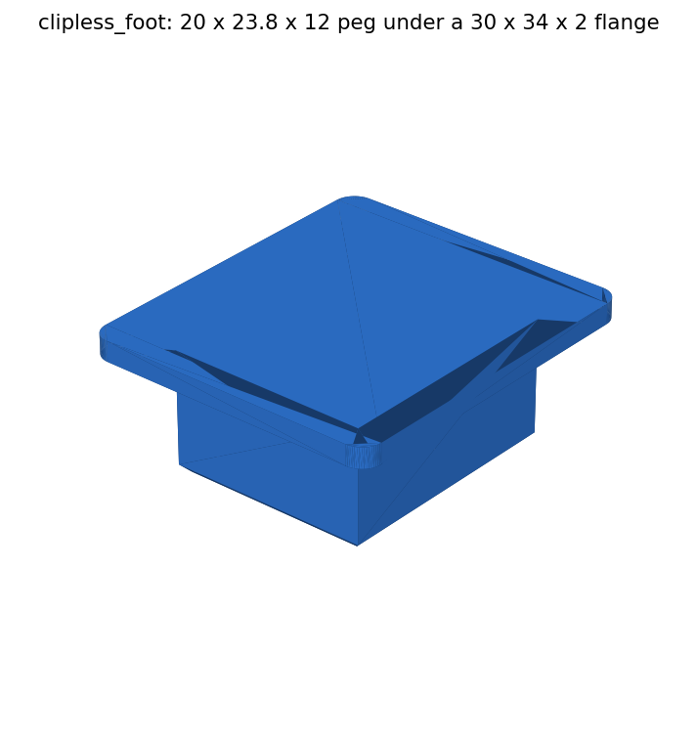
cad/Mounts/out/clipless_foot.png
