AtlasAutoware/carv1/cad/Mounts/out/jetson_orin_nano.png

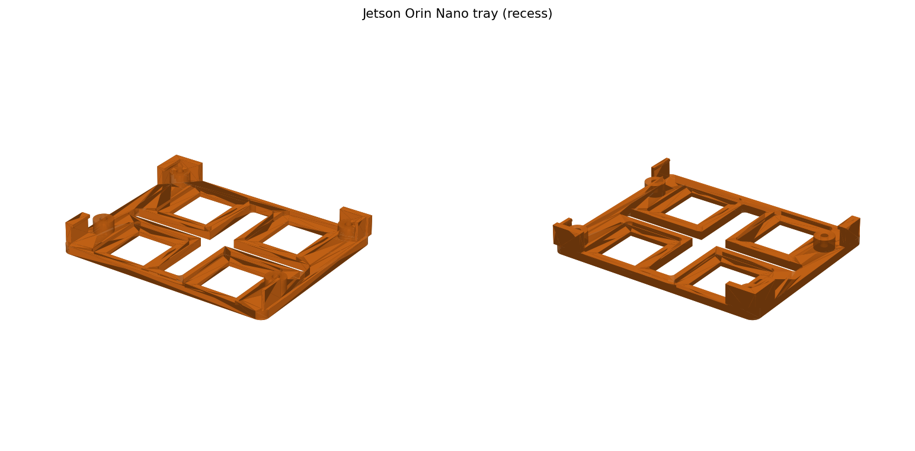
cad/Mounts/out/jetson_orin_nano.png
