AtlasAutoware/carv1/cad/Mounts/out/jetson_orin_nano_under_lines.png

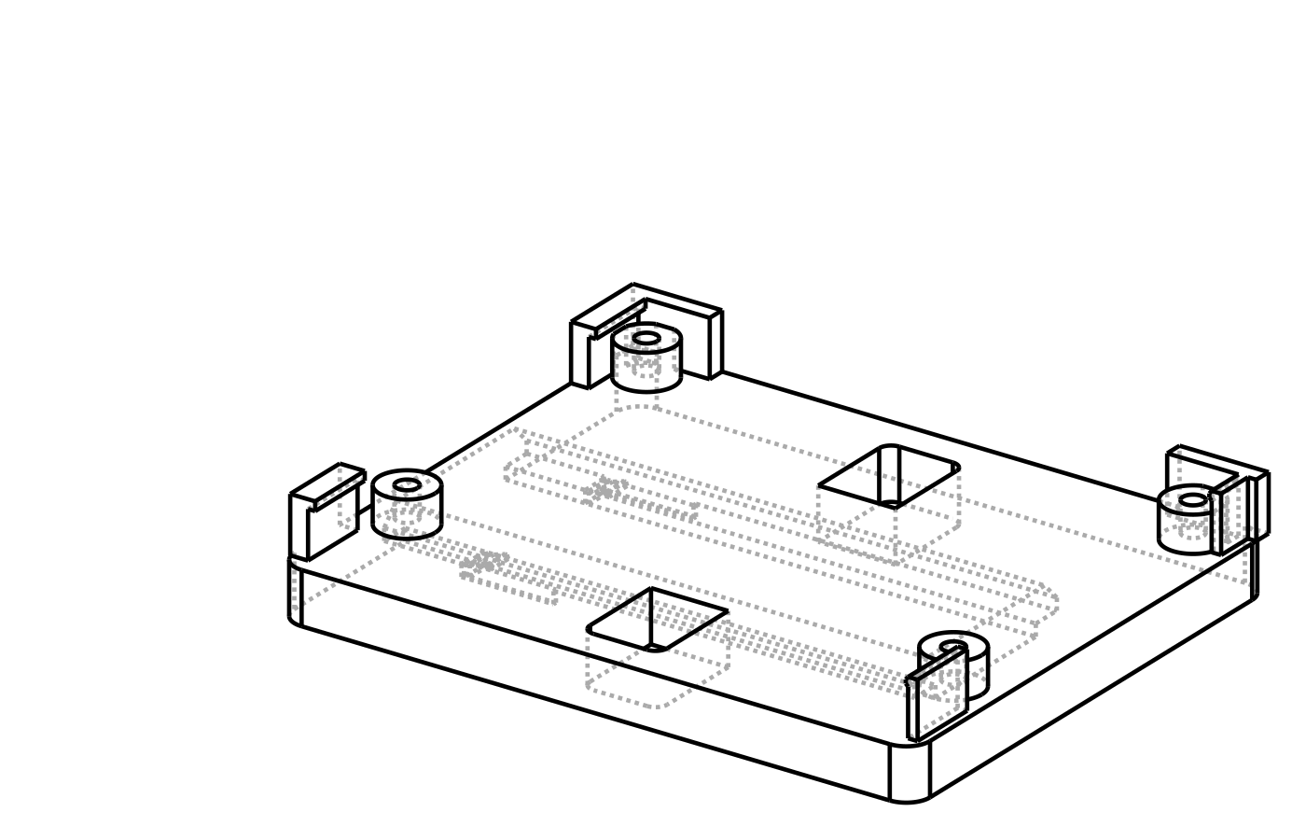
cad/Mounts/out/jetson_orin_nano_under_lines.png
