AtlasAutoware/carv1/cad/Mounts/out/lipo_smc_9000_lines.png

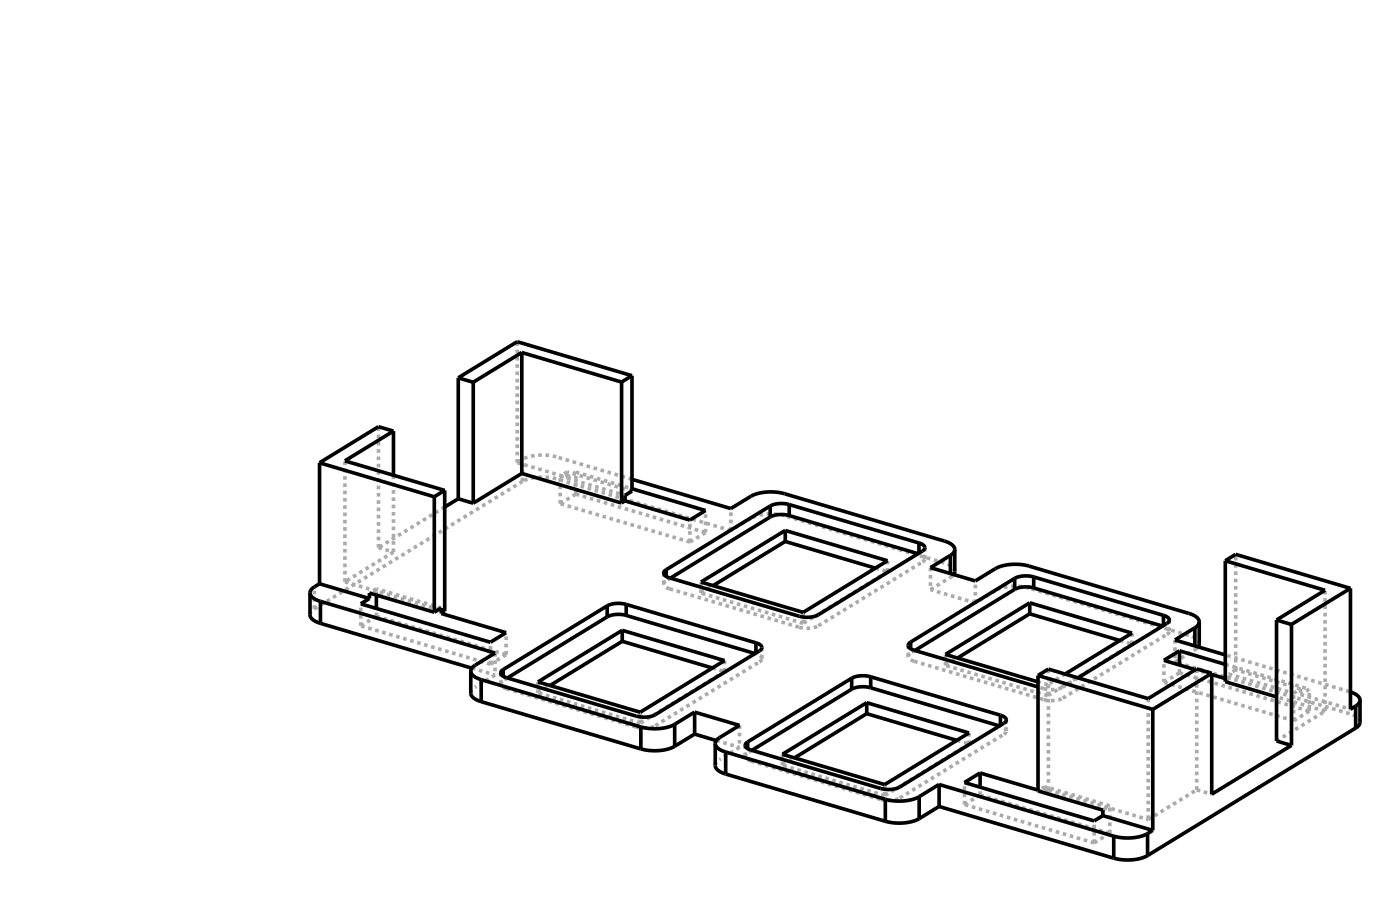
cad/Mounts/out/lipo_smc_9000_lines.png
