AtlasAutoware/carv1/cad/Mounts/out/liteon_45w_brick.png

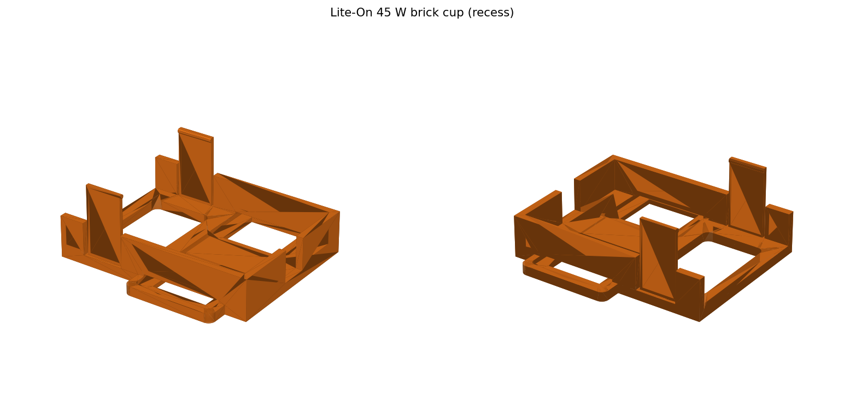
cad/Mounts/out/liteon_45w_brick.png
