AtlasAutoware/carv1/cad/Mounts/out/liteon_45w_brick_under_lines.png

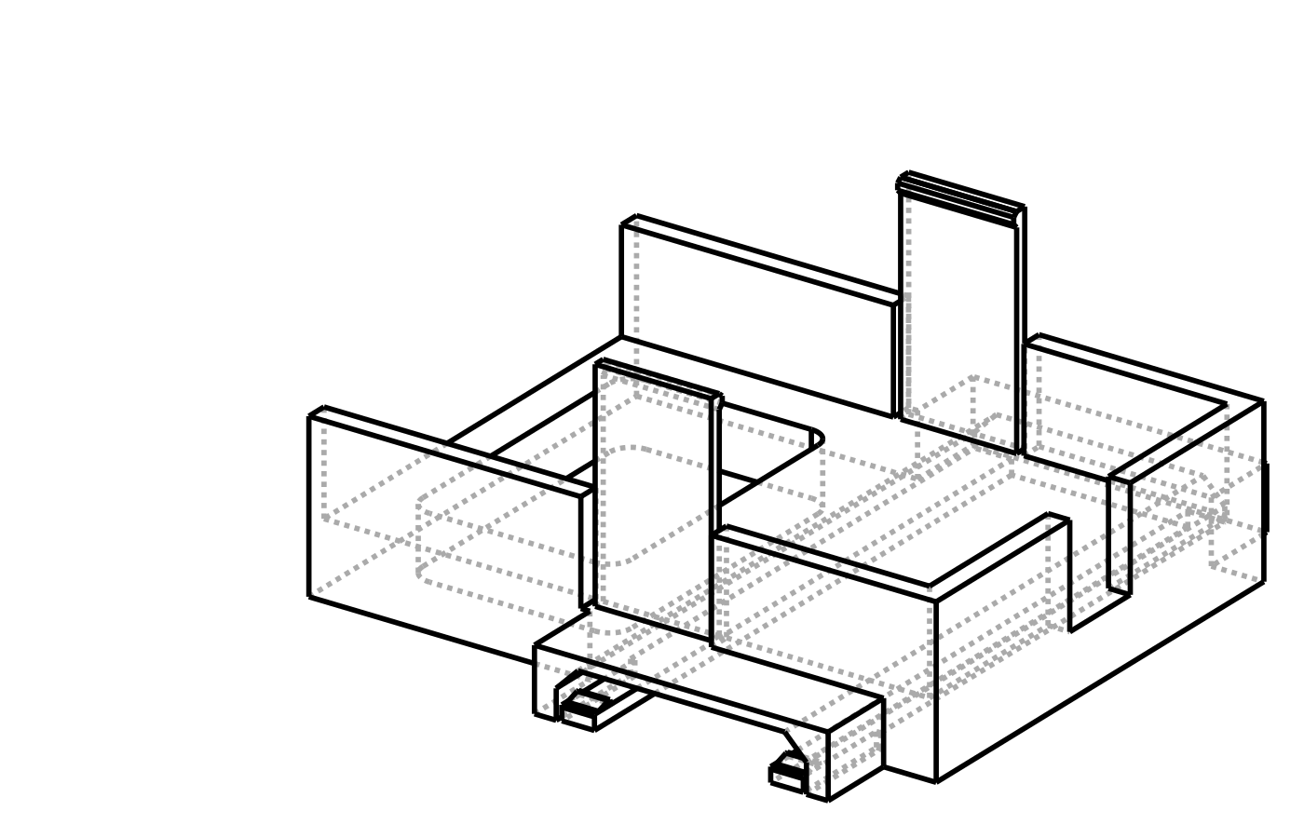
cad/Mounts/out/liteon_45w_brick_under_lines.png
