AtlasAutoware/carv1/cad/Mounts/out/liteon_45w_brick_v2_lines.png

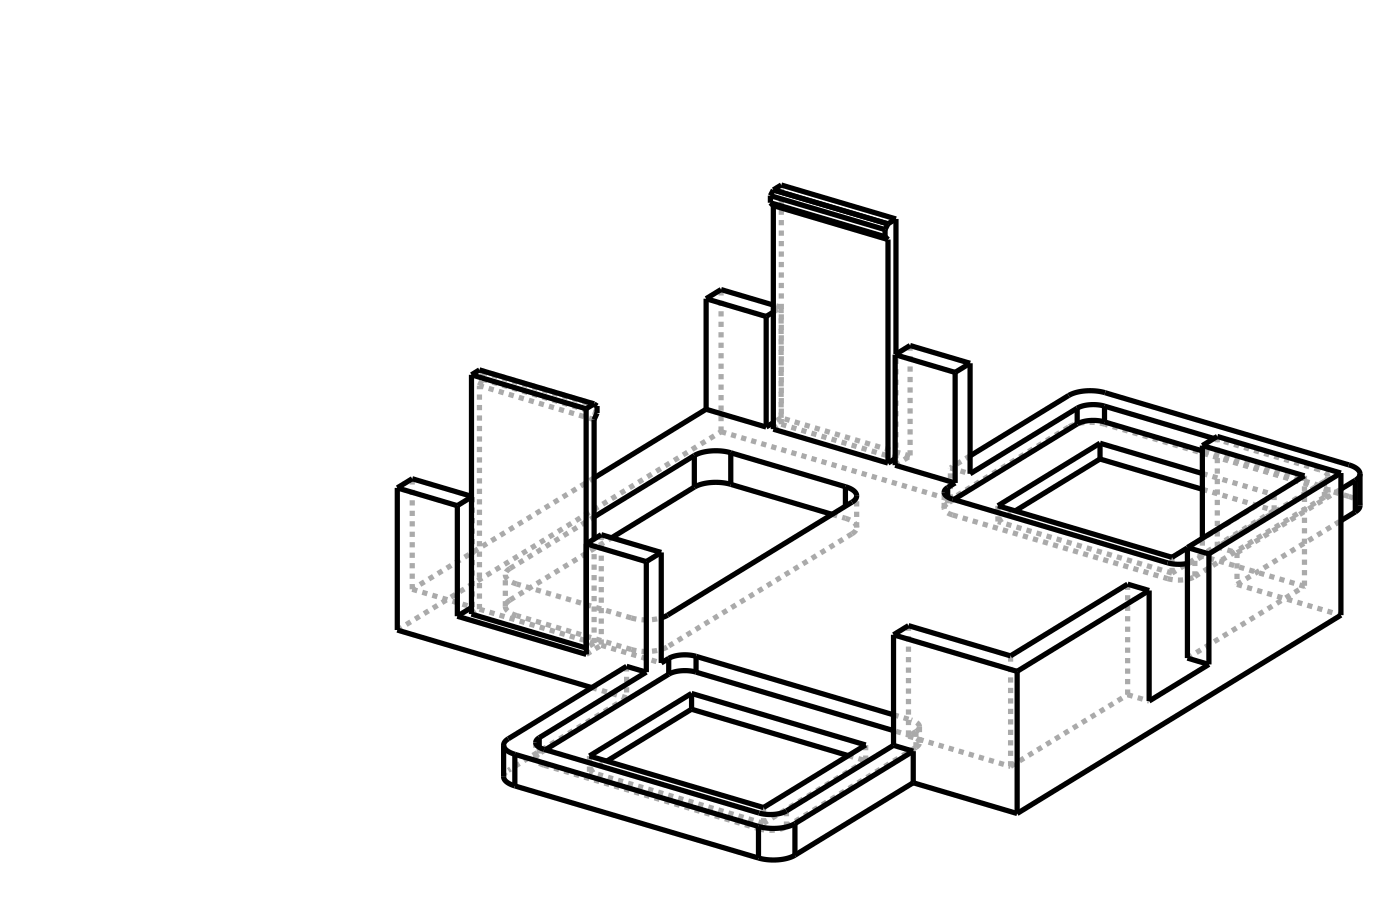
cad/Mounts/out/liteon_45w_brick_v2_lines.png
