AtlasAutoware/carv1/cad/Mounts/out/omni20_cradle.png

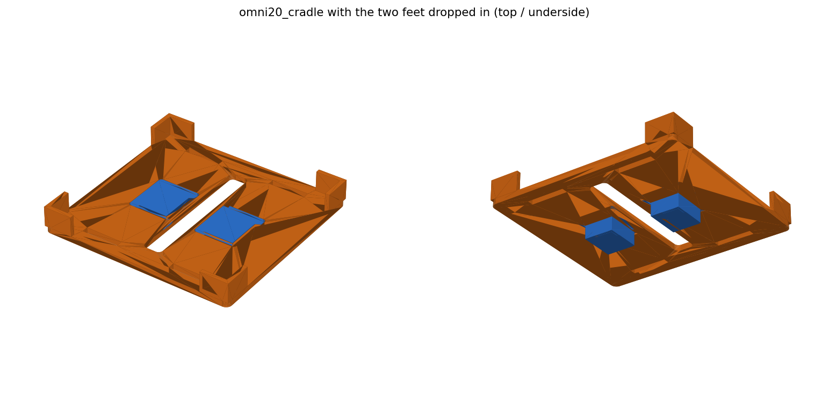
cad/Mounts/out/omni20_cradle.png
