AtlasAutoware/carv1/cad/Mounts/out/rplidar_c1.png

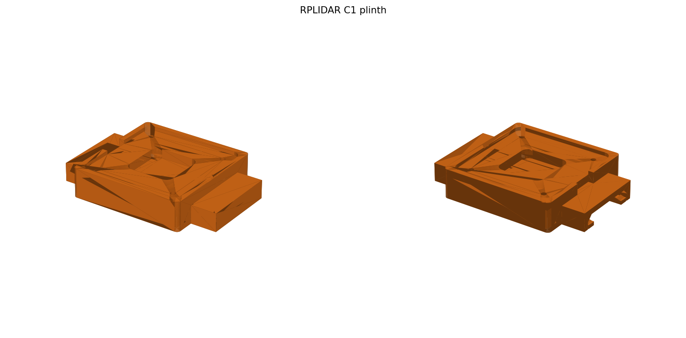
cad/Mounts/out/rplidar_c1.png
