AtlasAutoware/carv1/cad/Mounts/out/rplidar_c1_lines.png

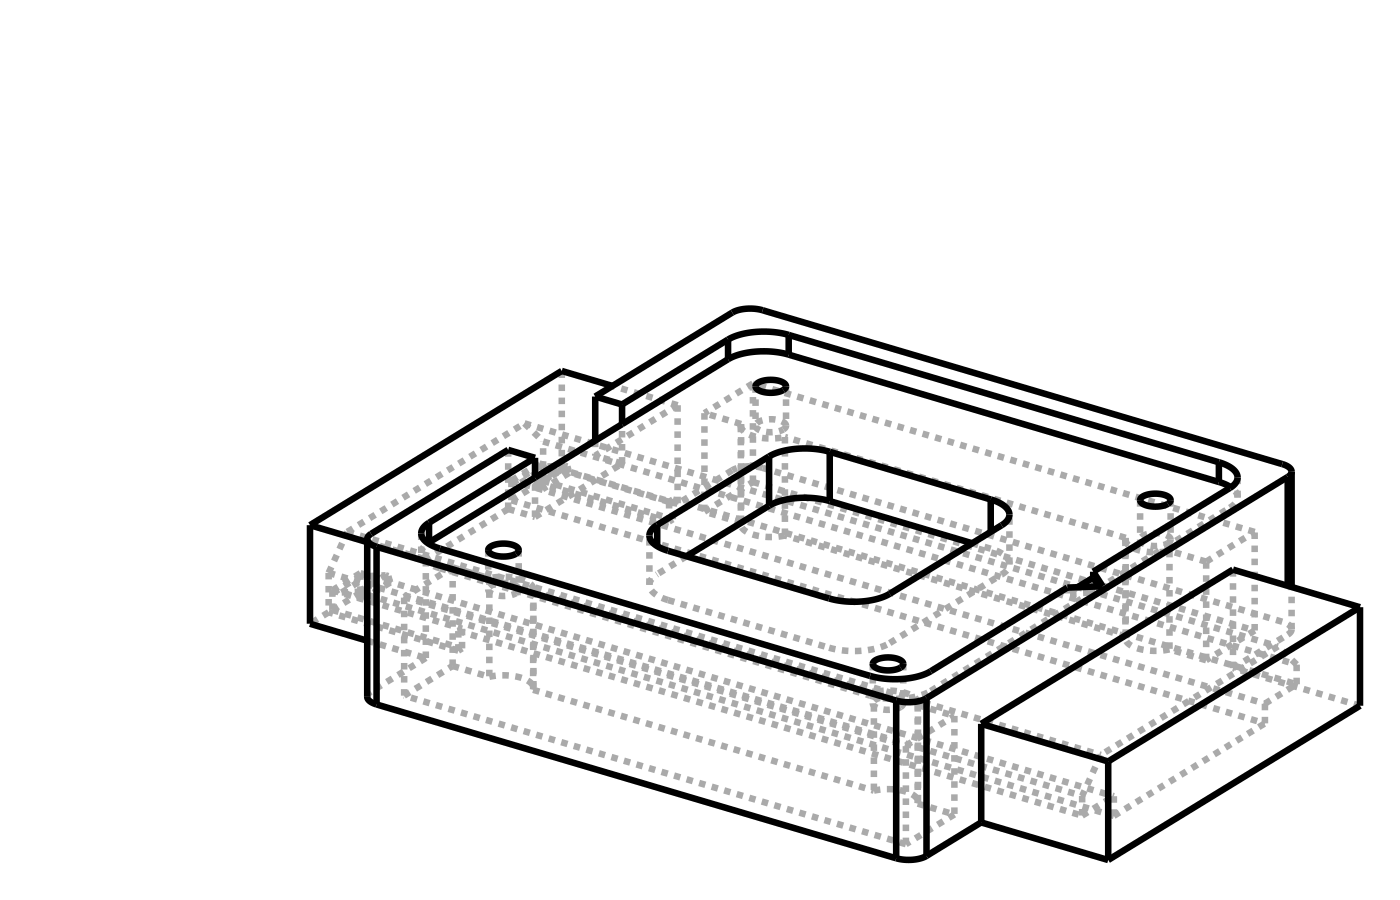
cad/Mounts/out/rplidar_c1_lines.png
