AtlasAutoware/carv1/cad/Mounts/out/vesc_bracket_legs.png

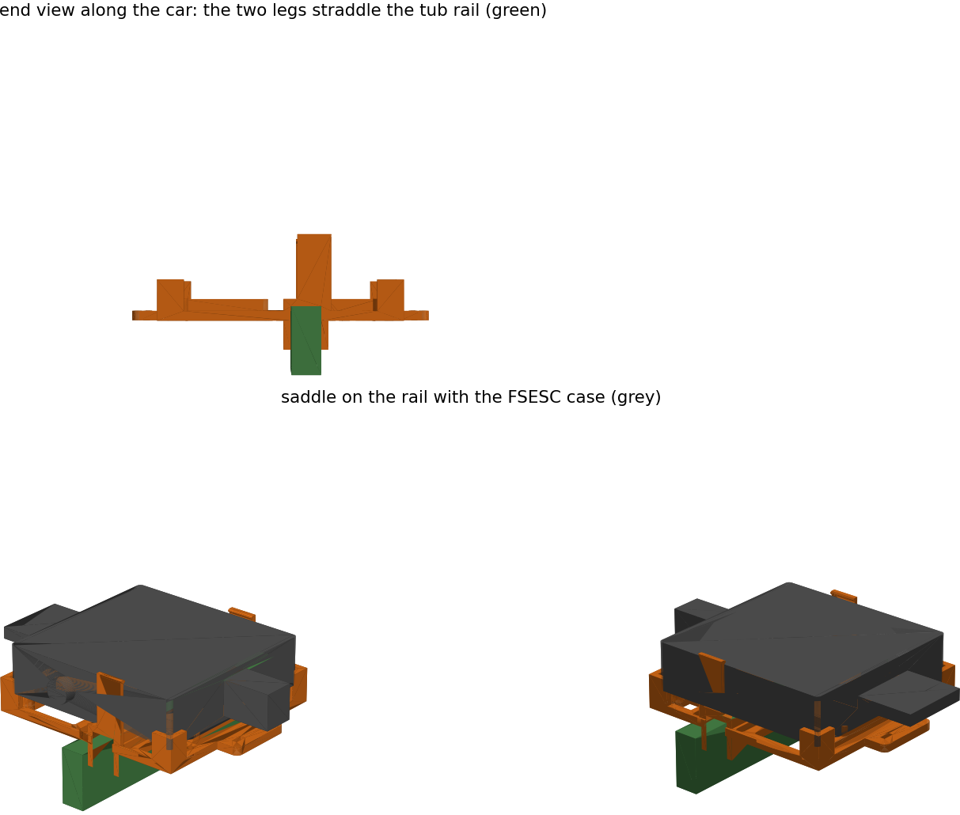
cad/Mounts/out/vesc_bracket_legs.png
