AtlasAutoware/carv1/cad/Mounts/out/vesc_bracket_legs_end.png

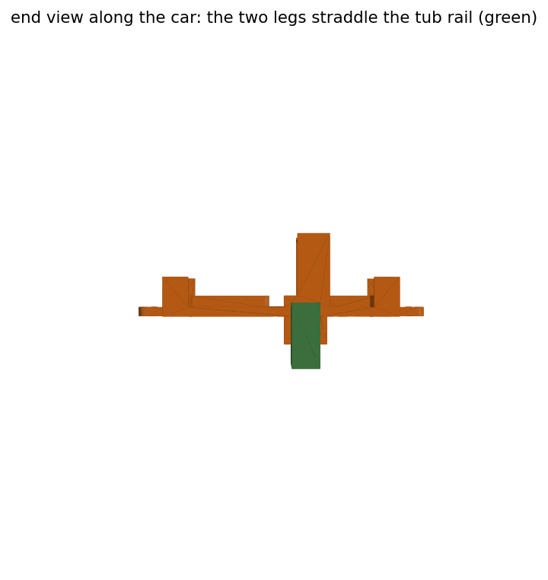
cad/Mounts/out/vesc_bracket_legs_end.png
