AtlasAutoware/carv1/cad/Mounts/out/vesc_fsesc67.png

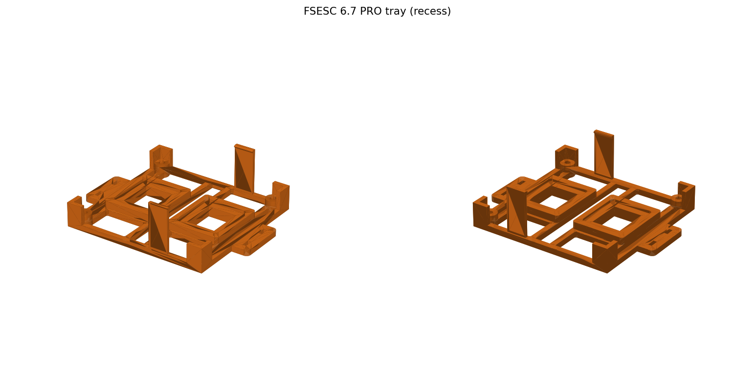
cad/Mounts/out/vesc_fsesc67.png
