AtlasAutoware/carv1/cad/Mounts/out/vesc_fsesc67_lines.png

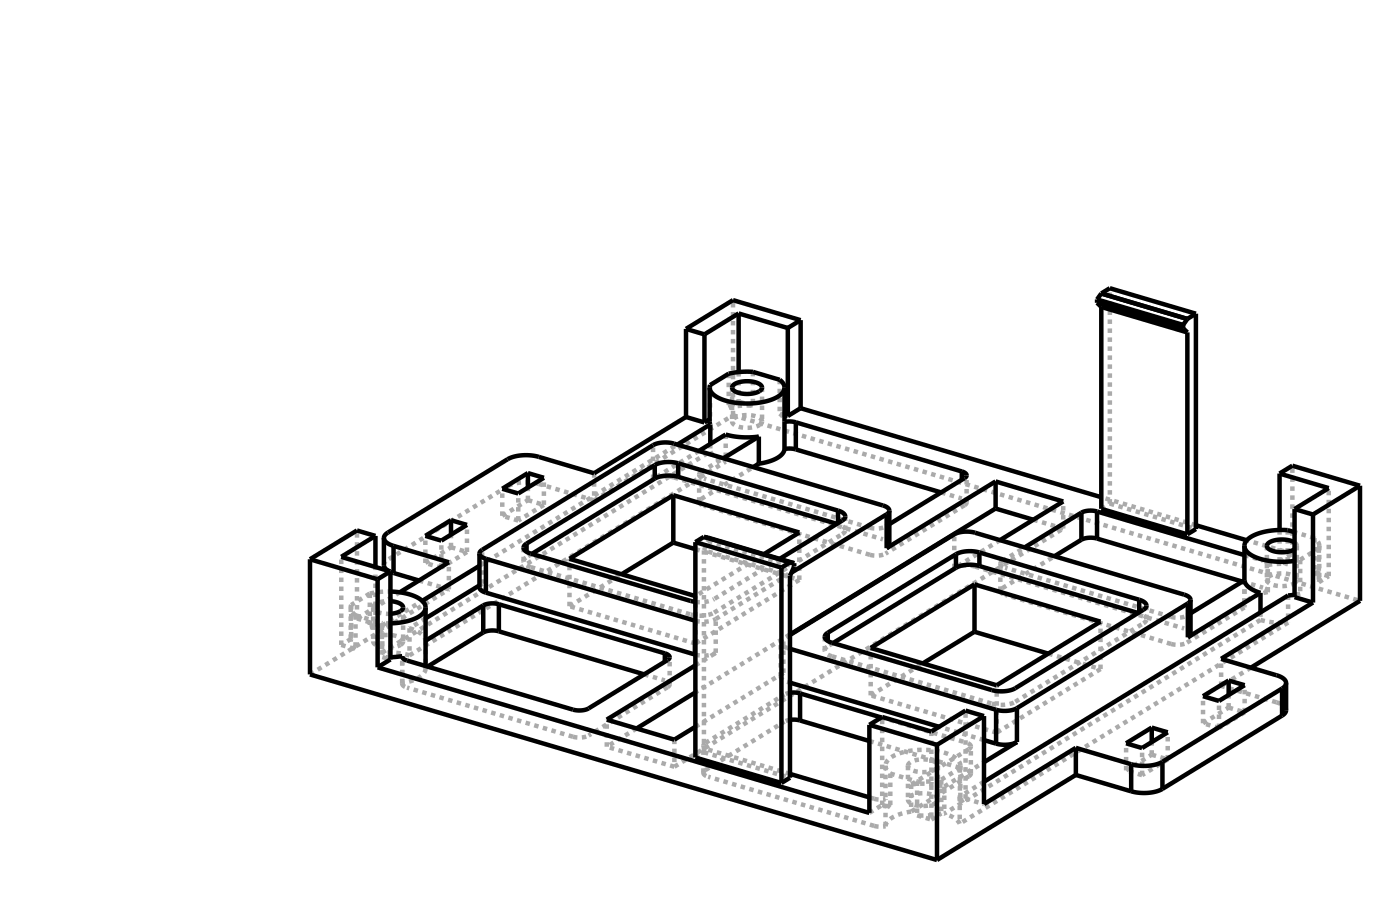
cad/Mounts/out/vesc_fsesc67_lines.png
