AtlasAutoware/carv1/cad/Mounts/out/vesc_fsesc67_under_lines.png

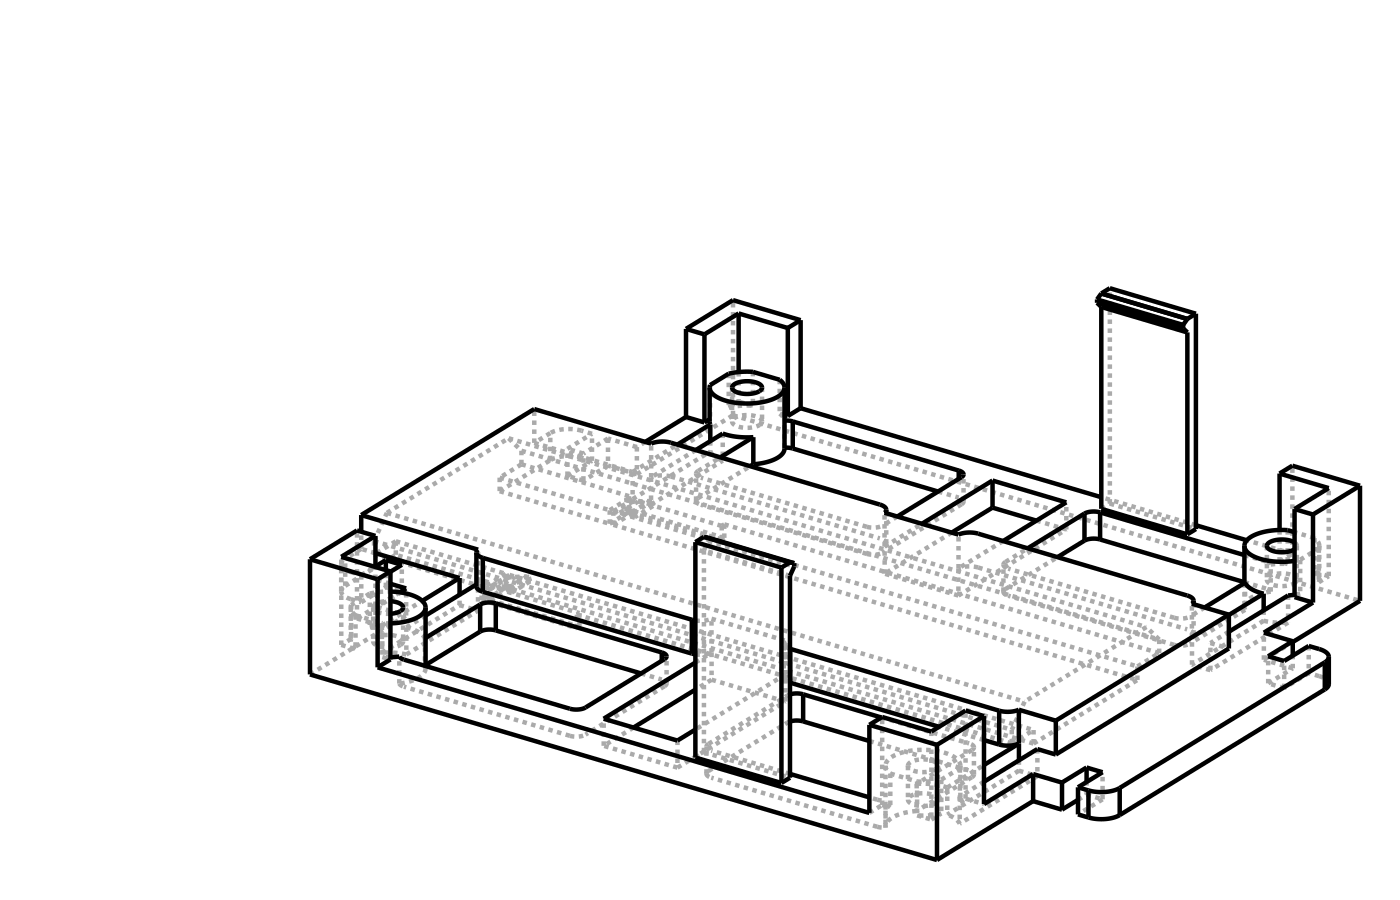
cad/Mounts/out/vesc_fsesc67_under_lines.png
