AtlasAutoware/carv1/cad/Mounts/out/vesc_post_mount.png

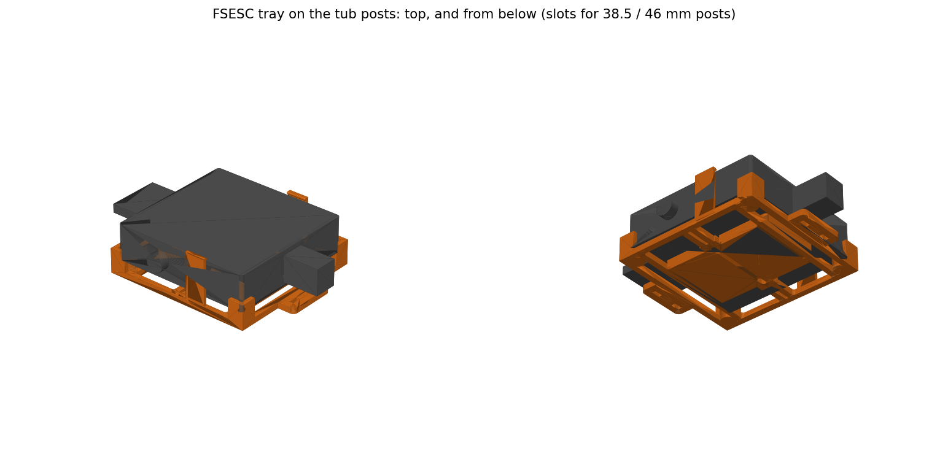
cad/Mounts/out/vesc_post_mount.png
