AtlasAutoware/carv1/cad/Mounts/out/vesc_tub_bracket_posts.png

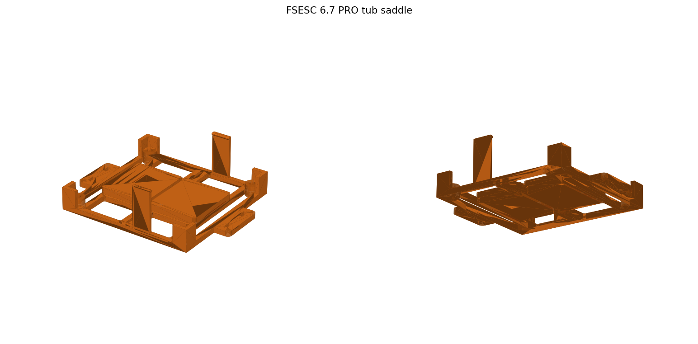
cad/Mounts/out/vesc_tub_bracket_posts.png
