AtlasAutoware/carv1/cad/Mounts/out/vesc_tub_bracket_posts_L100_lines.png

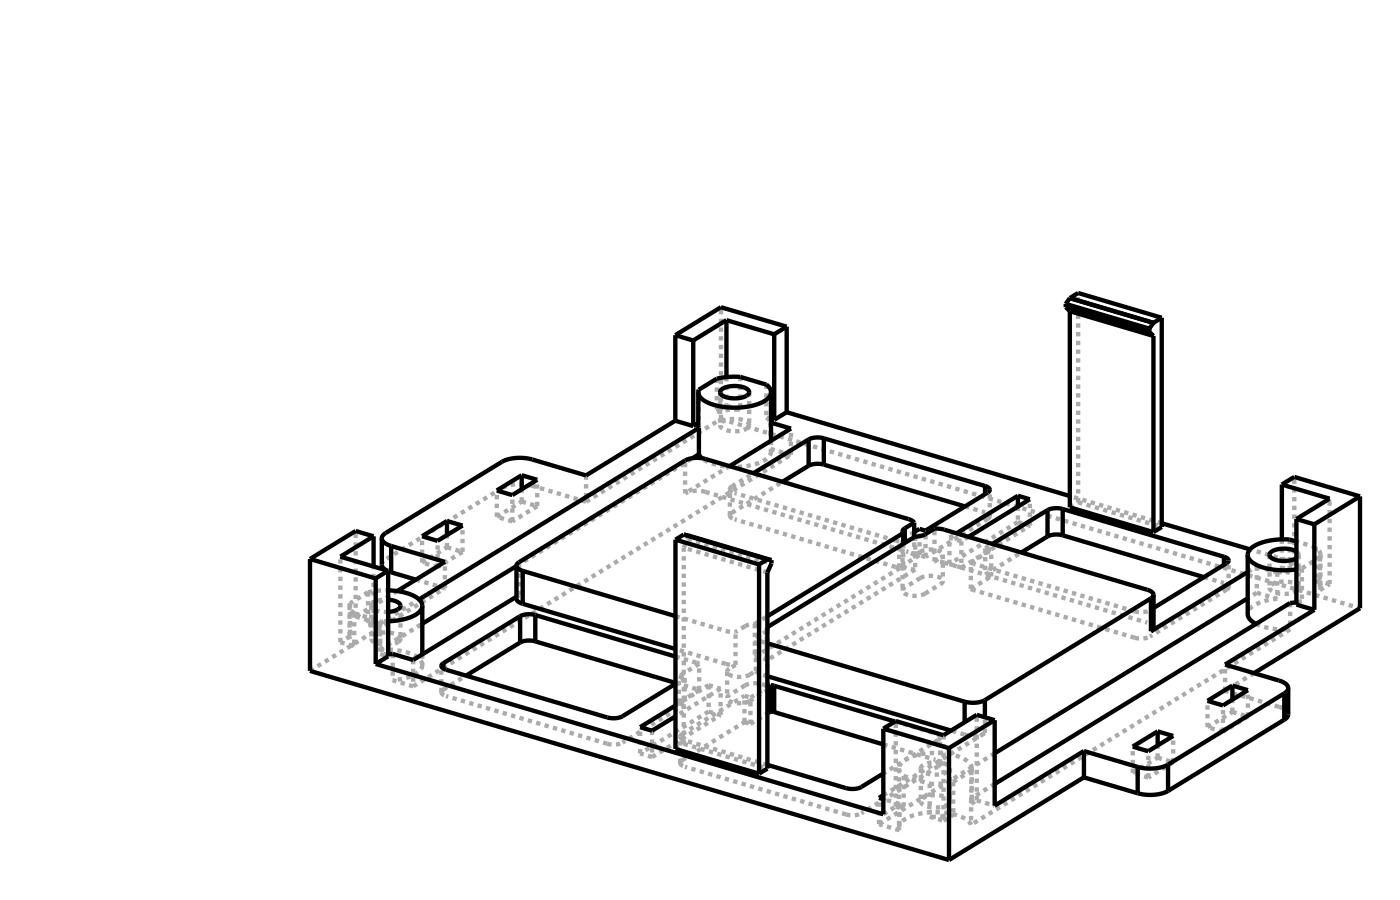
cad/Mounts/out/vesc_tub_bracket_posts_L100_lines.png
