AtlasAutoware/carv1/cad/Mounts/newcar/out/tim561_assembly.step

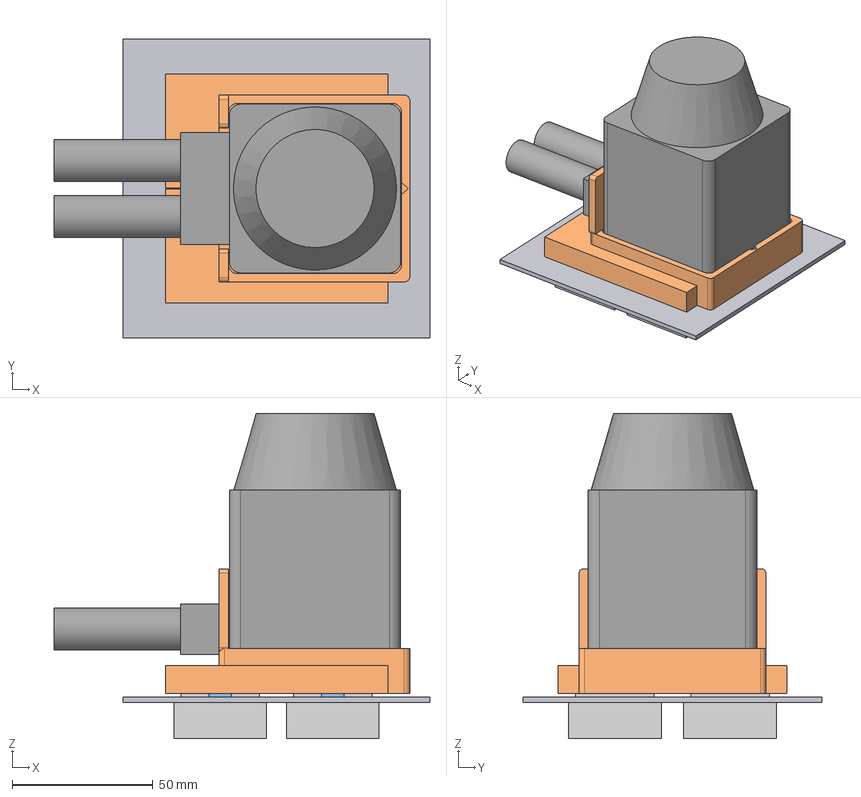
[picture p85: CAD file, 2026-09-28]
cad/Mounts/newcar/out/tim561_assembly.step
133.8 x 106.5 x 115.7 mm
baseplate
clipless_0
clipless_1
clipless_2
clipless_3
plinth
foot_0
foot_1
foot_2
foot_3
tim561_envelope
