AtlasAutoware/carv1/cad/Mounts/out/liteon_45w_brick_under_assembly.step

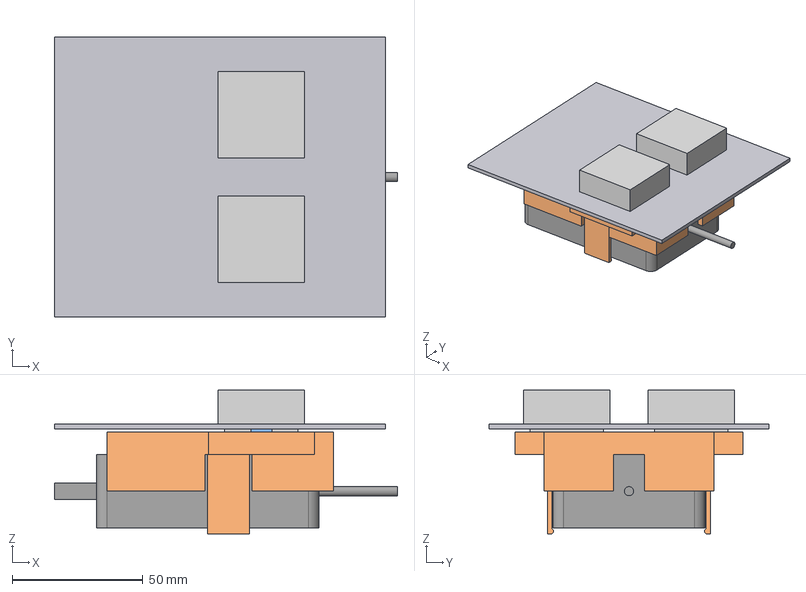
[picture p86: CAD file, 2026-09-28]
cad/Mounts/out/liteon_45w_brick_under_assembly.step
131.0 x 107.0 x 54.9 mm
baseplate
clipless_0
clipless_1
tray
foot_0
foot_1
envelope
