AtlasAutoware/carv1/cad/Mounts/out/cable_tidy_assembly.step

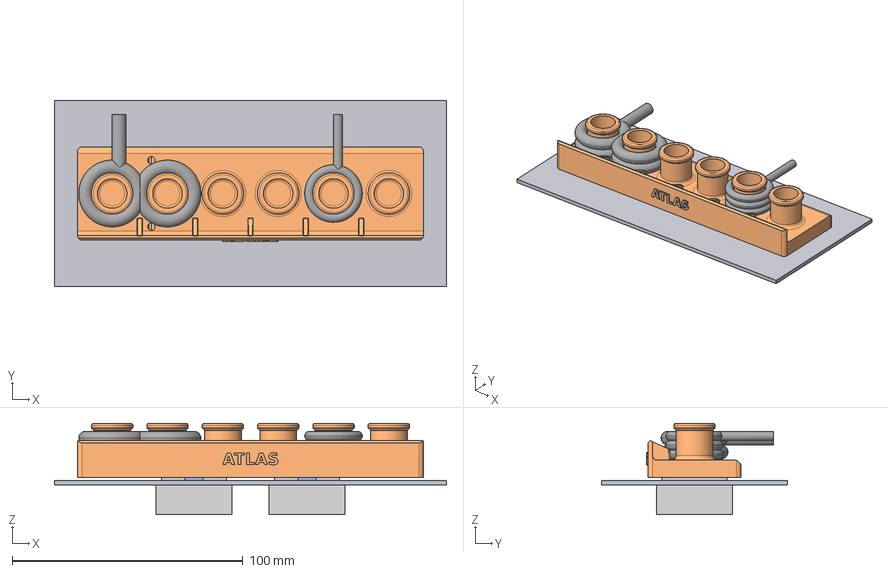
[picture p88: CAD file, 2026-09-28]
cad/Mounts/out/cable_tidy_assembly.step
170.0 x 80.5 x 39.5 mm
baseplate
clipless_0
clipless_1
cable_tidy
foot_0
foot_1
sample_cables
