AtlasAutoware/carv1/cad/Mounts/newcar/out/newcar_layout_blade100w_assembly.step

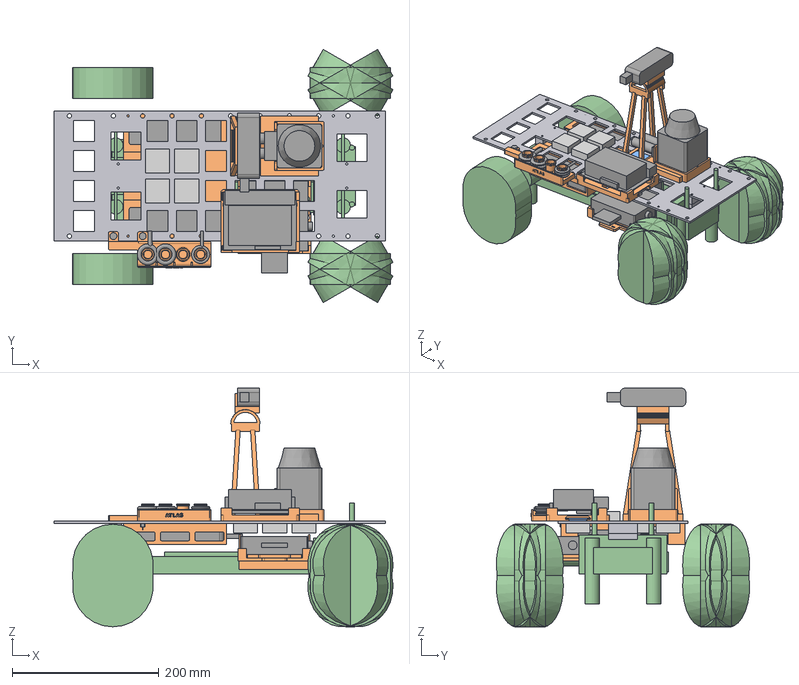
[picture p89: CAD file, 2026-09-28]
cad/Mounts/newcar/out/newcar_layout_blade100w_assembly.step
462.3 x 345.3 x 325.5 mm
tim561_plinth
tim561_foot0
tim561_foot1
tim561_foot2
tim561_foot3
tim561_lidar
tim561_clipless_A1
tim561_clipless_B1
tim561_clipless_A2
tim561_clipless_B2
camera_mast_mast
camera_mast_head
camera_mast_foot0
camera_mast_foot1
camera_mast_camera
camera_mast_clipless_A3
camera_mast_clipless_B3
jetson_orin_nano_jetson_tray
jetson_orin_nano_foot0
jetson_orin_nano_foot1
jetson_orin_nano_jetson_kit
jetson_orin_nano_clipless_D2
jetson_orin_nano_clipless_D3
battery_bank_bank_tray
battery_bank_foot0
battery_bank_foot1
battery_bank_foot2
battery_bank_foot3
battery_bank_power_bank
battery_bank_clipless_B5
battery_bank_clipless_C5
battery_bank_clipless_B6
battery_bank_clipless_C6
cable_tidy_rail
cable_tidy_cables
cable_tidy_m5_fasteners
vesc_tub_bracket_saddle
vesc_tub_bracket_vesc_case
chassis_tub
chassis_battery_tray
chassis_gearbox
chassis_motor
chassis_centre_shaft
chassis_steering_servo
chassis_steering_linkage
chassis_front_tower
chassis_front_tower_shock_R
chassis_front_tower_shock_L
chassis_rear_tower
chassis_rear_tower_shock_R
chassis_rear_tower_shock_L
chassis_body_post_2
chassis_body_post_3
chassis_tyre_front_R
chassis_tyre_front_L
chassis_tyre_rear_R
chassis_tyre_rear_L
board_plate
board_bracket0
board_bracket1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
