AtlasAutoware/carv1/cad/Mounts/newcar/out/battery_bank_underslung_assembly.step

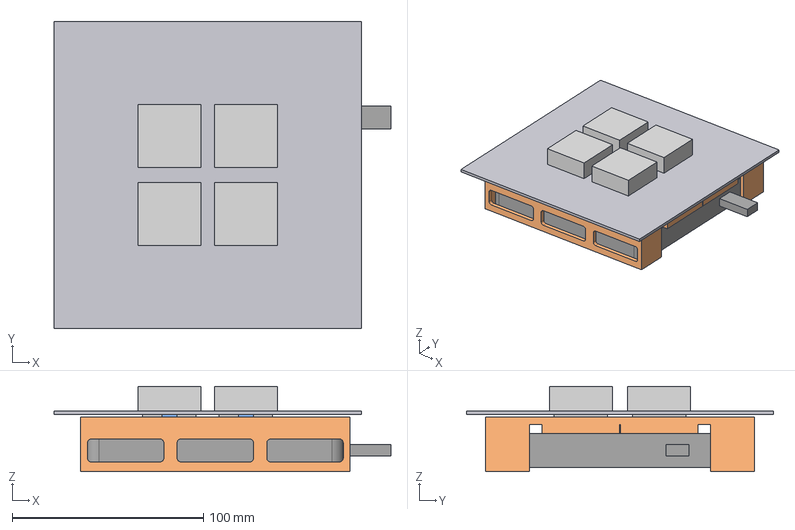
[picture p92: CAD file, 2026-09-28]
cad/Mounts/newcar/out/battery_bank_underslung_assembly.step
176.4 x 160.9 x 44.7 mm
baseplate
clipless_0
clipless_1
clipless_2
clipless_3
tray
foot_0
foot_1
foot_2
foot_3
envelope
