AtlasAutoware/carv1/cad/Mounts/out/liteon_45w_brick_v2_assembly.step

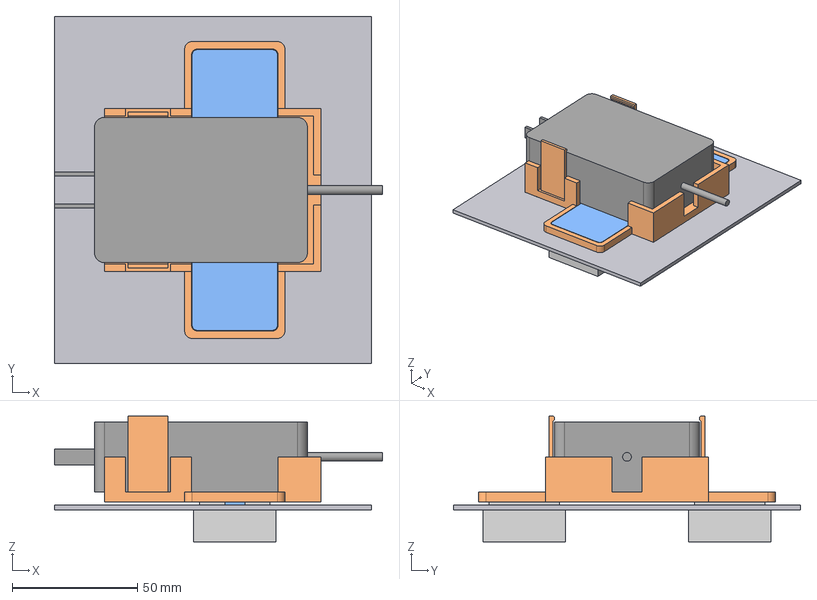
[picture p93: CAD file, 2026-09-28]
cad/Mounts/out/liteon_45w_brick_v2_assembly.step
131.0 x 138.5 x 50.3 mm
baseplate
clipless_0
clipless_1
cup
foot_0
foot_1
brick_envelope
