AtlasAutoware/carv1/cad/Mounts/out/rplidar_c1_v2_assembly.step

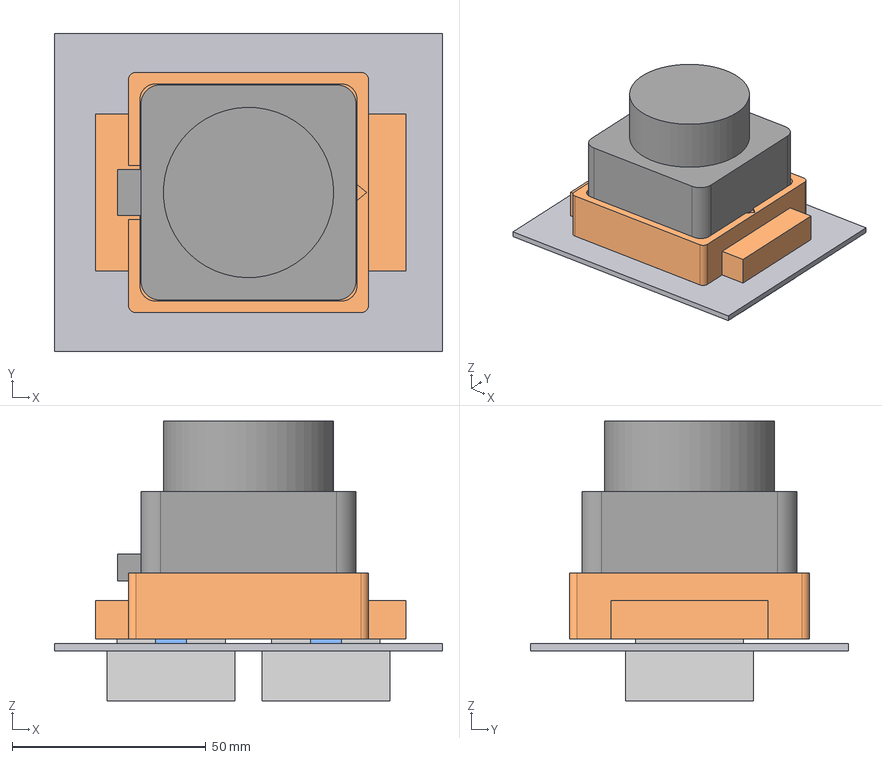
[picture p96: CAD file, 2026-09-28]
cad/Mounts/out/rplidar_c1_v2_assembly.step
100.2 x 82.1 x 72.3 mm
baseplate
clipless_0
clipless_1
plinth
foot_0
foot_1
rplidar_c1_envelope
