AtlasAutoware/carv1/cad/Mounts/out/lipo_smc_9000_assembly.step

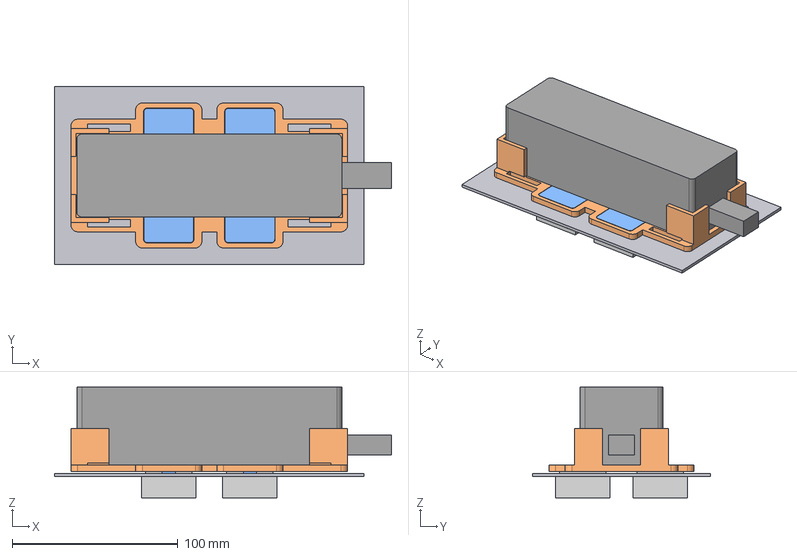
[picture p98: CAD file, 2026-09-28]
cad/Mounts/out/lipo_smc_9000_assembly.step
203.5 x 107.5 x 67.0 mm
baseplate
clipless_0
clipless_1
clipless_2
clipless_3
frame
foot_0
foot_1
foot_2
foot_3
lipo_envelope
