AtlasAutoware/carv1/cad/Mounts/out/board_layout_assembly.step

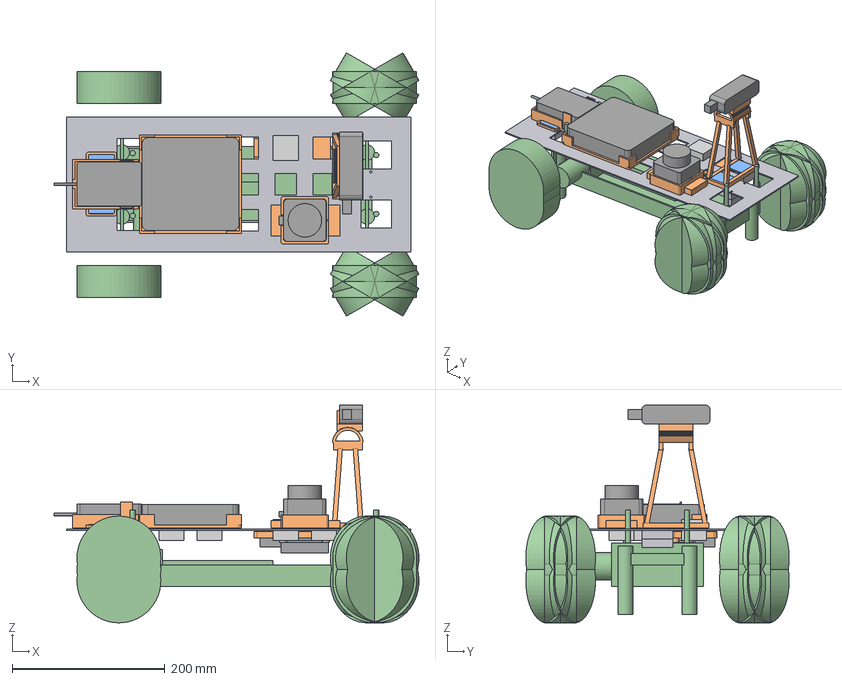
[picture p99: CAD file, 2026-09-28]
cad/Mounts/out/board_layout_assembly.step
478.6 x 345.4 x 285.5 mm
camera_mast_mast
camera_mast_head
camera_mast_foot0
camera_mast_foot1
camera_mast_camera
camera_mast_clipless_n1C
camera_mast_clipless_n1L
rplidar_c1_plinth
rplidar_c1_foot0
rplidar_c1_foot1
rplidar_c1_lidar
rplidar_c1_clipless_c1R
rplidar_c1_clipless_c2R
omni20_cradle
omni20_foot0
omni20_foot1
omni20_omni20_pack
omni20_clipless_c4C
omni20_clipless_c5C
liteon_45w_cup
liteon_45w_foot0
liteon_45w_foot1
liteon_45w_brick
liteon_45w_clipless_n6L
liteon_45w_clipless_n6R
small_board_plate_small_board_plate
small_board_plate_foot0
small_board_plate_pca9685_hub
small_board_plate_clipless_c2L
chassis_tub
chassis_battery_tray
chassis_gearbox_spur
chassis_motor
chassis_steering_servo
chassis_steering_linkage
chassis_front_tower
chassis_front_tower_shock_R
chassis_front_tower_shock_L
chassis_rear_tower
chassis_rear_tower_shock_R
chassis_rear_tower_shock_L
chassis_body_post_0
chassis_body_post_1
chassis_body_post_2
chassis_body_post_3
chassis_tyre_front_R
chassis_tyre_front_L
chassis_tyre_rear_R
chassis_tyre_rear_L
board_plate
board_bracket0
board_bracket1
board_bracket2
board_bracket3
