AtlasAutoware/carv1/cad/Mounts/out/vesc_tub_bracket_assembly.step

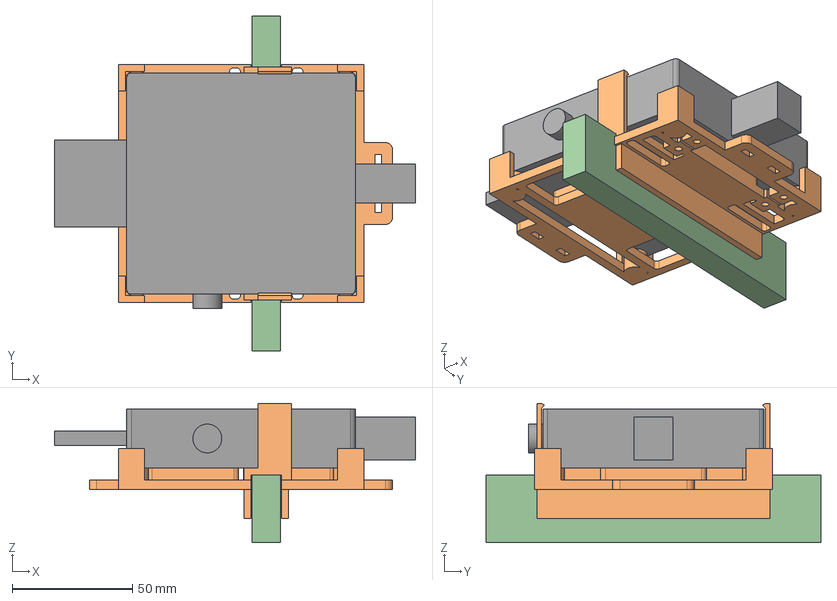
[picture p100: CAD file, 2026-09-28]
cad/Mounts/out/vesc_tub_bracket_assembly.step
150.0 x 139.0 x 57.8 mm
tub_rail
saddle
fsesc67_envelope
