AtlasAutoware/carv1/cad/Mounts/out/small_board_plate_assembly.step

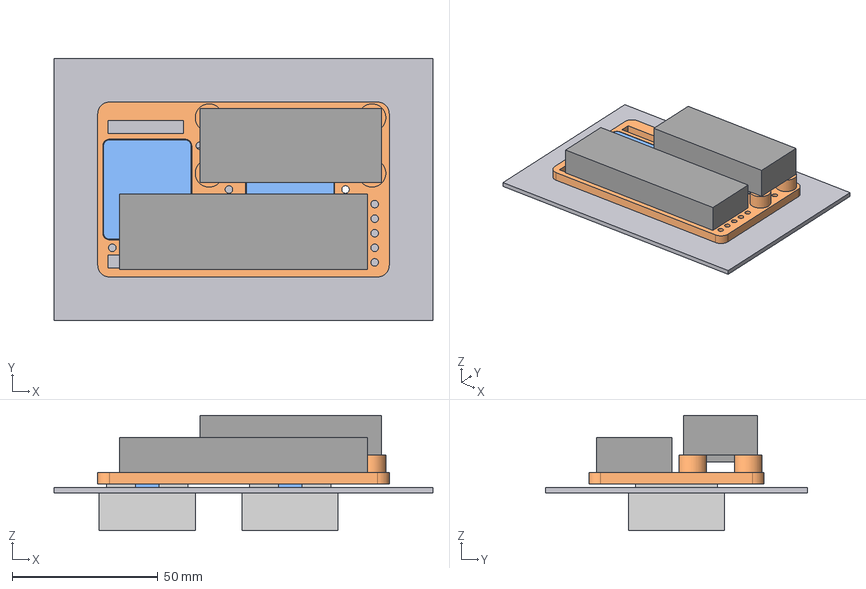
[picture p102: CAD file, 2026-09-28]
cad/Mounts/out/small_board_plate_assembly.step
130.0 x 90.0 x 39.6 mm
baseplate
clipless_0
clipless_1
plate
foot_0
foot_1
boards_envelope
