AtlasAutoware/carv1/cad/Mounts/out/camera_mast_assembly.step

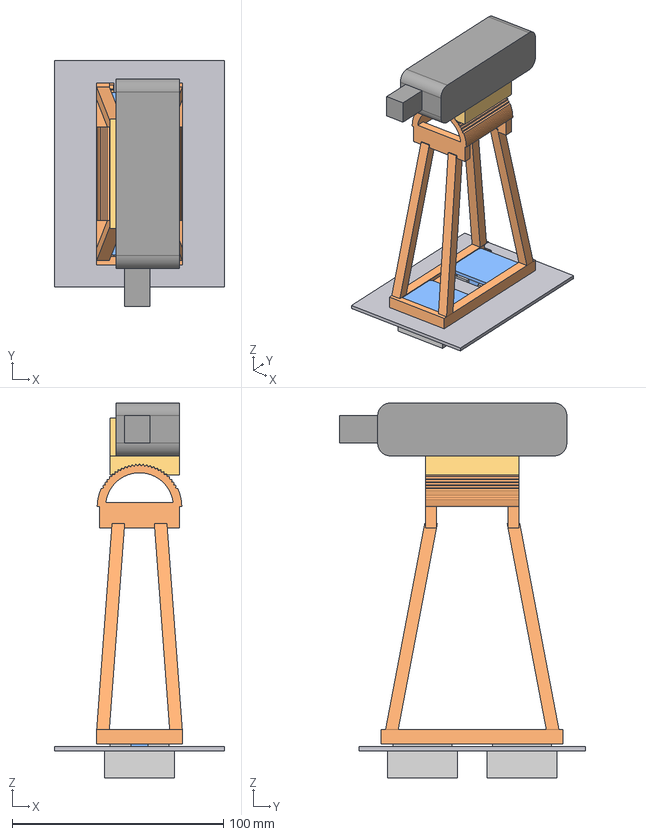
[picture p103: CAD file, 2026-09-28]
cad/Mounts/out/camera_mast_assembly.step
80.5 x 116.2 x 177.3 mm
baseplate
clipless_0
clipless_1
mast
head
foot_0
foot_1
gemini_335_envelope
