AtlasAutoware/carv1/cad/Mounts/out/omni20_assembly.step

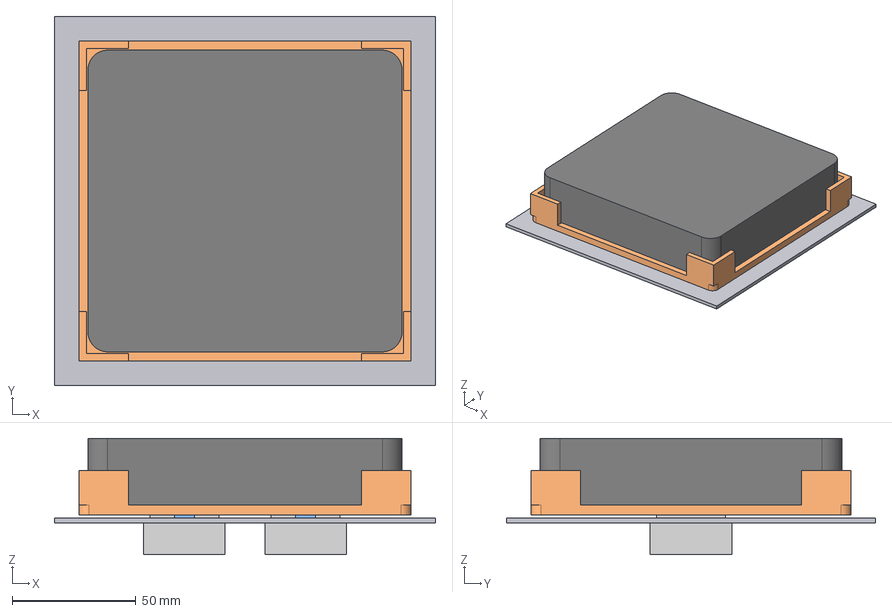
[picture p104: CAD file, 2026-09-28]
cad/Mounts/out/omni20_assembly.step
154.2 x 149.2 x 47.0 mm
baseplate
clipless_0
clipless_1
cradle
foot_0
foot_1
omni20
