AtlasAutoware/carv1/cad/Mounts/out/vesc_fsesc67_v2_assembly.step

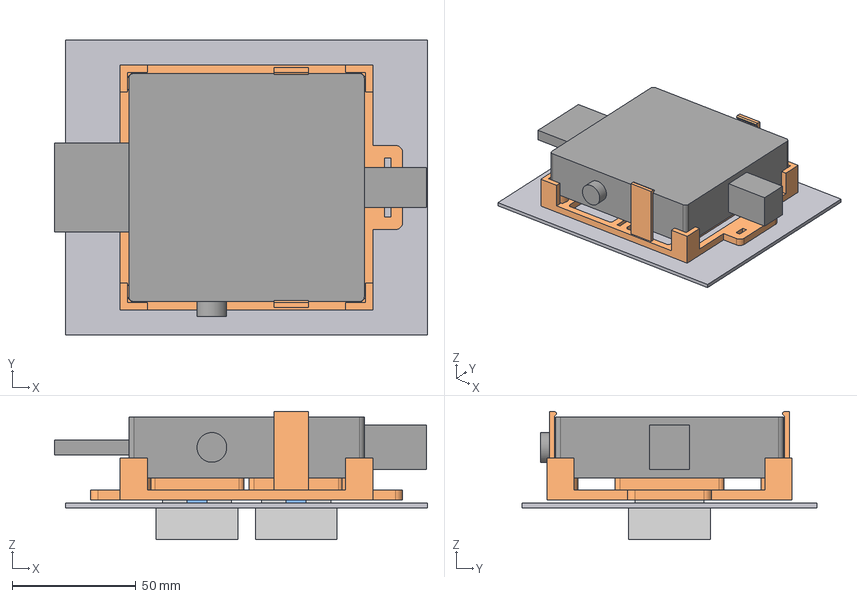
[picture p105: CAD file, 2026-09-28]
cad/Mounts/out/vesc_fsesc67_v2_assembly.step
150.5 x 119.0 x 51.8 mm
baseplate
clipless_0
clipless_1
tray
foot_0
foot_1
fsesc67_envelope
