AtlasAutoware/carv1/cad/Mounts/out/jetson_orin_nano_under_assembly.step

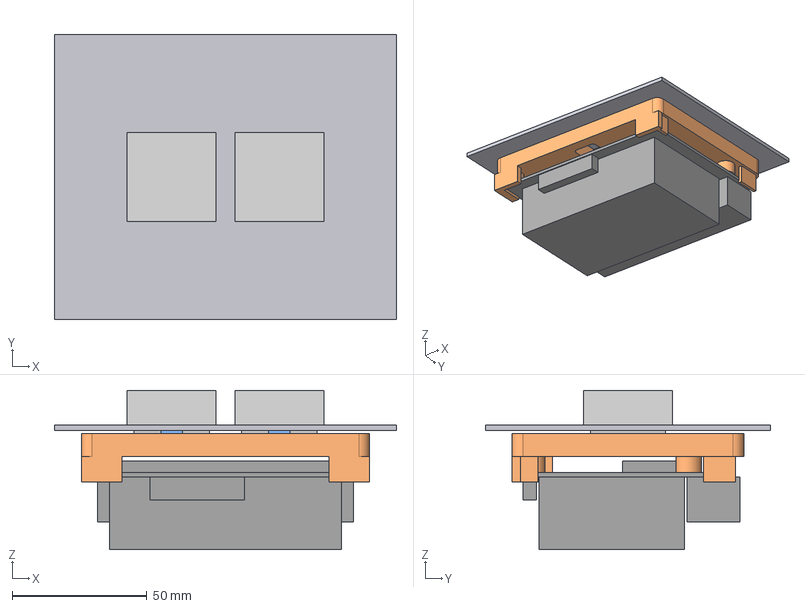
[picture p106: CAD file, 2026-09-28]
cad/Mounts/out/jetson_orin_nano_under_assembly.step
127.0 x 106.0 x 59.1 mm
baseplate
clipless_0
clipless_1
tray
foot_0
foot_1
envelope
