AtlasAutoware/carv1/cad/Mounts/out/cable_tidy_100_assembly.step

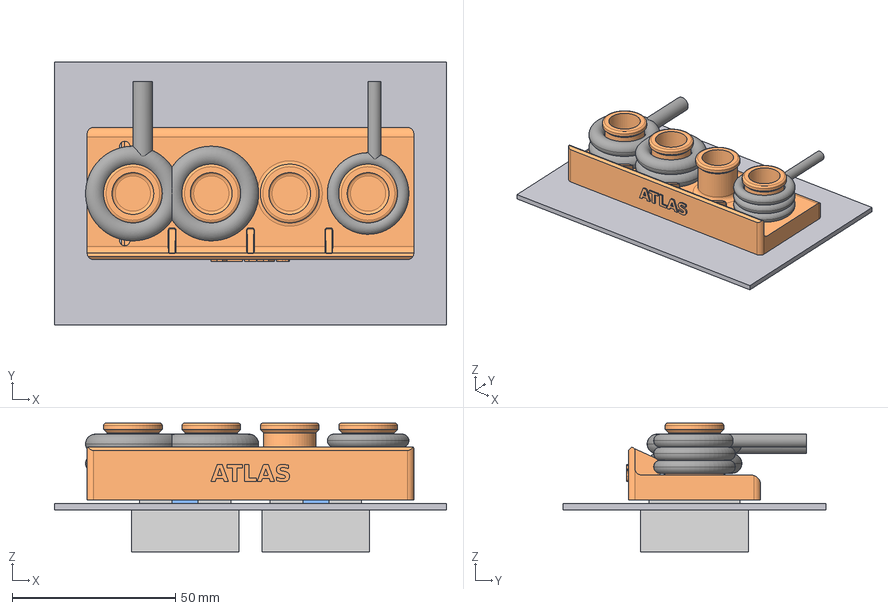
[picture p107: CAD file, 2026-09-28]
cad/Mounts/out/cable_tidy_100_assembly.step
120.0 x 80.5 x 39.5 mm
baseplate
clipless_0
clipless_1
cable_tidy
foot_0
foot_1
sample_cables
