AtlasAutoware/carv1/cad/Mounts/out/jetson_orin_nano_assembly.step

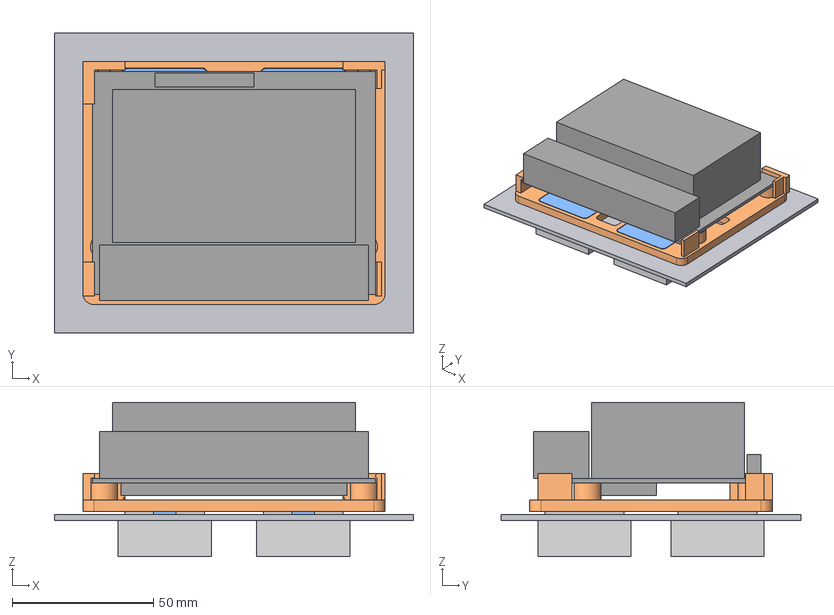
[picture p108: CAD file, 2026-09-28]
cad/Mounts/out/jetson_orin_nano_assembly.step
127.0 x 106.0 x 54.6 mm
baseplate
clipless_0
clipless_1
clipless_2
clipless_3
tray
foot_0
foot_1
foot_2
foot_3
jetson_envelope
