AtlasAutoware/carv1/cad/Mounts/out/small_board_plate_under_assembly.step

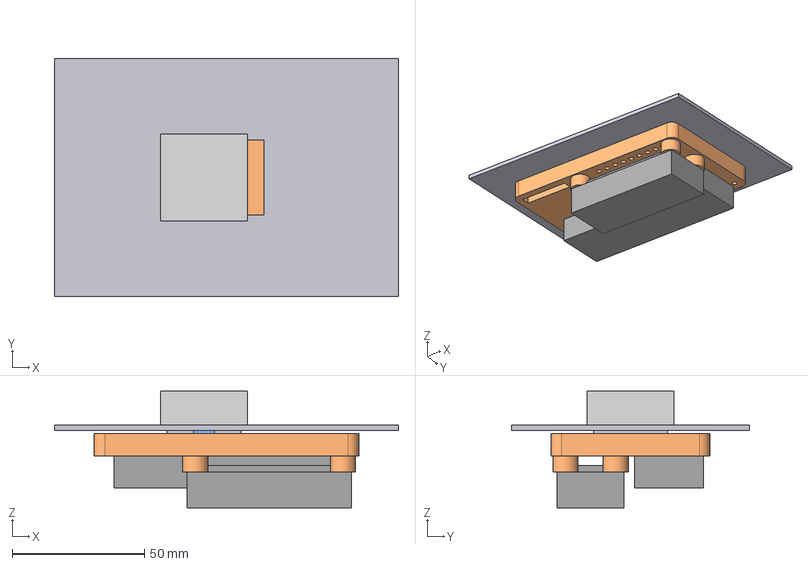
[picture p109: CAD file, 2026-09-28]
cad/Mounts/out/small_board_plate_under_assembly.step
130.0 x 90.0 x 44.2 mm
baseplate
clipless_0
tray
foot_0
envelope
