AtlasAutoware/carv1/cad/Mounts/out/cable_tidy_edge_assembly.step

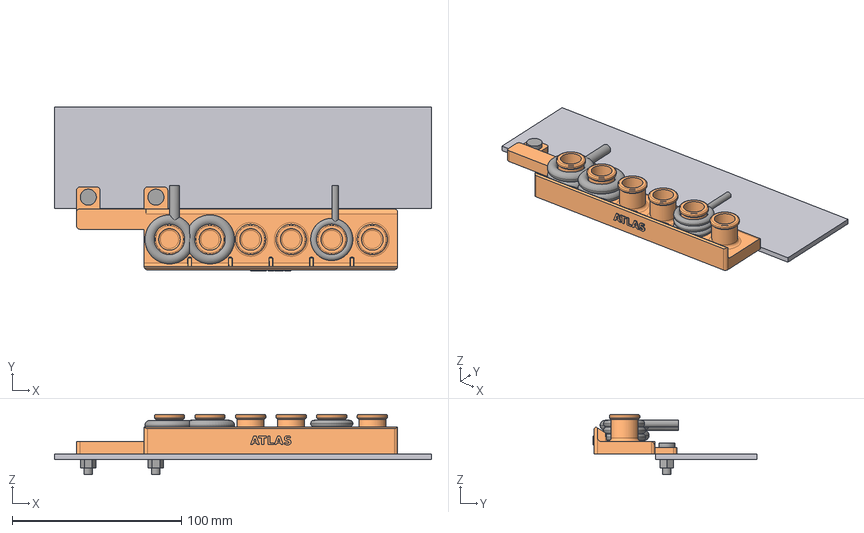
[picture p110: CAD file, 2026-09-28]
cad/Mounts/out/cable_tidy_edge_assembly.step
223.0 x 96.8 x 35.5 mm
baseplate_edge
cable_tidy_edge
m5_screws_nuts
sample_cables
