AtlasAutoware/carv1/cad/Mounts/out/board_layout_v2_tidy_assembly.step

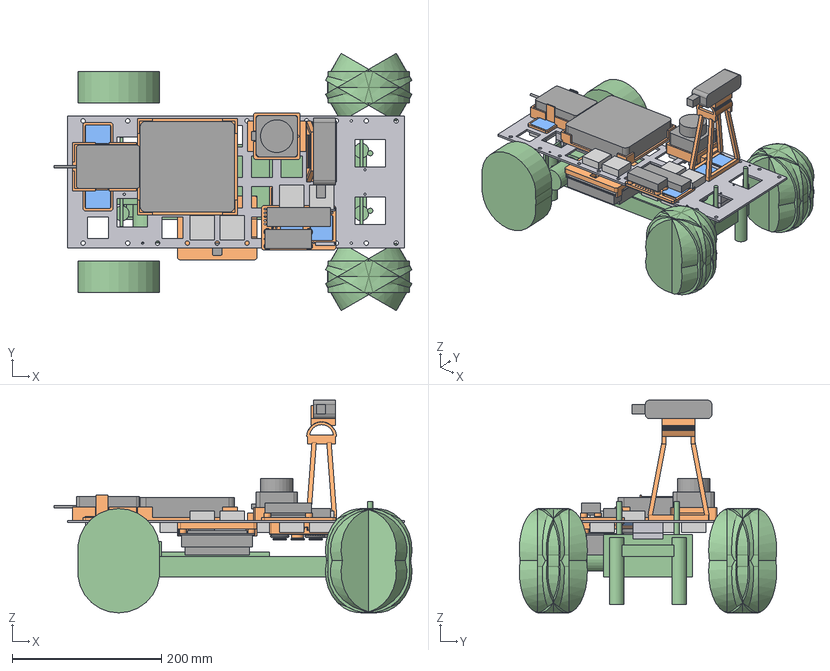
[picture p111: CAD file, 2026-09-28]
cad/Mounts/out/board_layout_v2_tidy_assembly.step
480.3 x 345.3 x 285.5 mm
camera_mast_mast
camera_mast_head
camera_mast_foot0
camera_mast_foot1
camera_mast_camera
camera_mast_clipless_A1
camera_mast_clipless_B1
rplidar_c1_plinth
rplidar_c1_foot0
rplidar_c1_foot1
rplidar_c1_lidar
rplidar_c1_clipless_A2
rplidar_c1_clipless_A3
omni20_cradle
omni20_foot0
omni20_foot1
omni20_omni20_pack
omni20_clipless_B5
omni20_clipless_B6
liteon_45w_cup
liteon_45w_foot0
liteon_45w_foot1
liteon_45w_brick
liteon_45w_clipless_A8
liteon_45w_clipless_C8
small_board_plate_small_board_plate
small_board_plate_foot0
small_board_plate_foot1
small_board_plate_pca9685_hub
small_board_plate_clipless_D1
small_board_plate_clipless_D2
jetson_orin_nano_jetson_tray
jetson_orin_nano_foot0
jetson_orin_nano_foot1
jetson_orin_nano_jetson_kit
jetson_orin_nano_clipless_D4
jetson_orin_nano_clipless_D5
cable_tidy_rail
cable_tidy_foot0
cable_tidy_foot1
cable_tidy_cables
cable_tidy_clipless_C1
cable_tidy_clipless_C2
chassis_tub
chassis_battery_tray
chassis_gearbox_spur
chassis_motor
chassis_steering_servo
chassis_steering_linkage
chassis_front_tower
chassis_front_tower_shock_R
chassis_front_tower_shock_L
chassis_rear_tower
chassis_rear_tower_shock_R
chassis_rear_tower_shock_L
chassis_body_post_2
chassis_body_post_3
chassis_tyre_front_R
chassis_tyre_front_L
chassis_tyre_rear_R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
