AtlasAutoware/carv1/cad/Mounts/out/power_board_mount_assembly.step

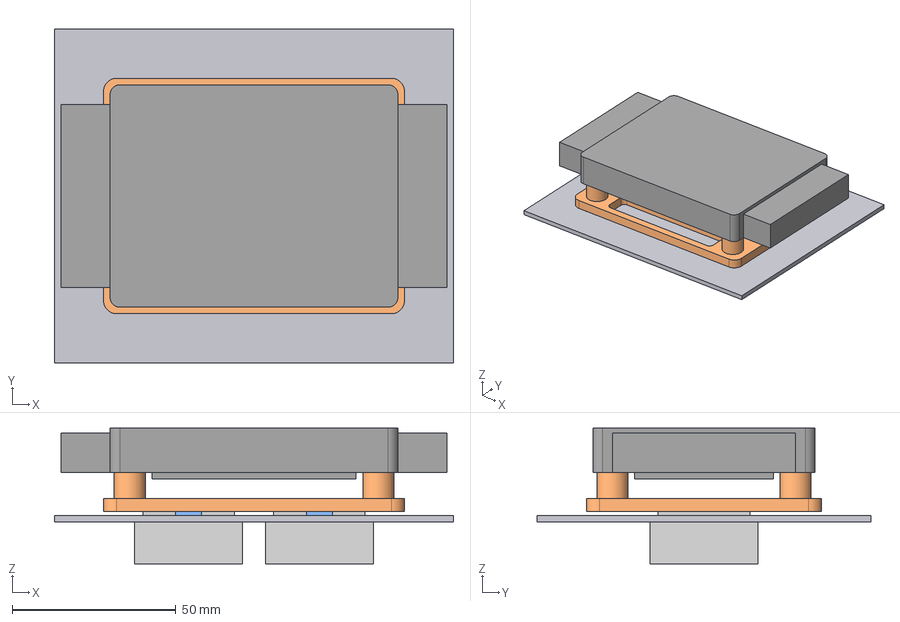
[picture p112: CAD file, 2026-09-28]
cad/Mounts/out/power_board_mount_assembly.step
122.0 x 102.0 x 41.6 mm
baseplate
clipless_0
clipless_1
plate
foot_0
foot_1
board_envelope
