AtlasAutoware/carv1/cad/Mounts/out/camera_mast_v2_assembly.step

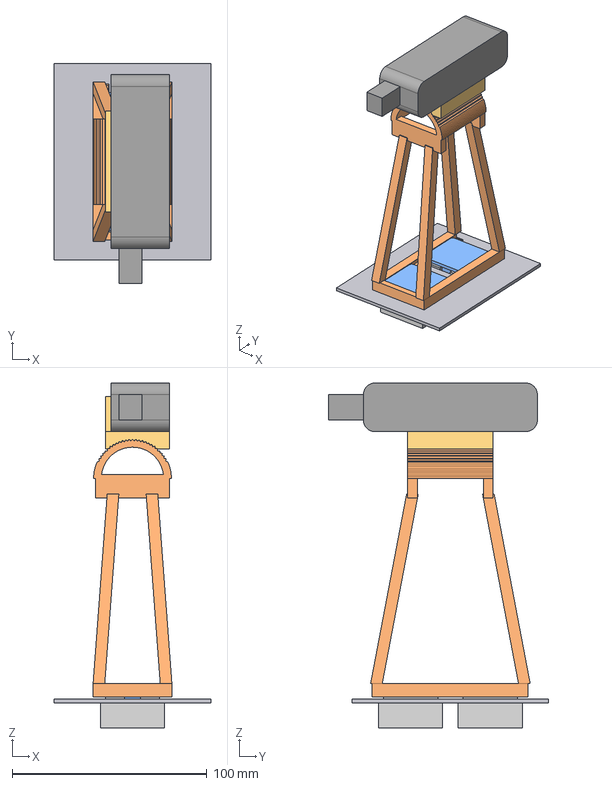
[picture p115: CAD file, 2026-09-28]
cad/Mounts/out/camera_mast_v2_assembly.step
80.5 x 113.2 x 177.3 mm
baseplate
clipless_0
clipless_1
mast
head
foot_0
foot_1
gemini_335_envelope
