AtlasAutoware/carv1/cad/Components/RPLIDAR C1.STEP

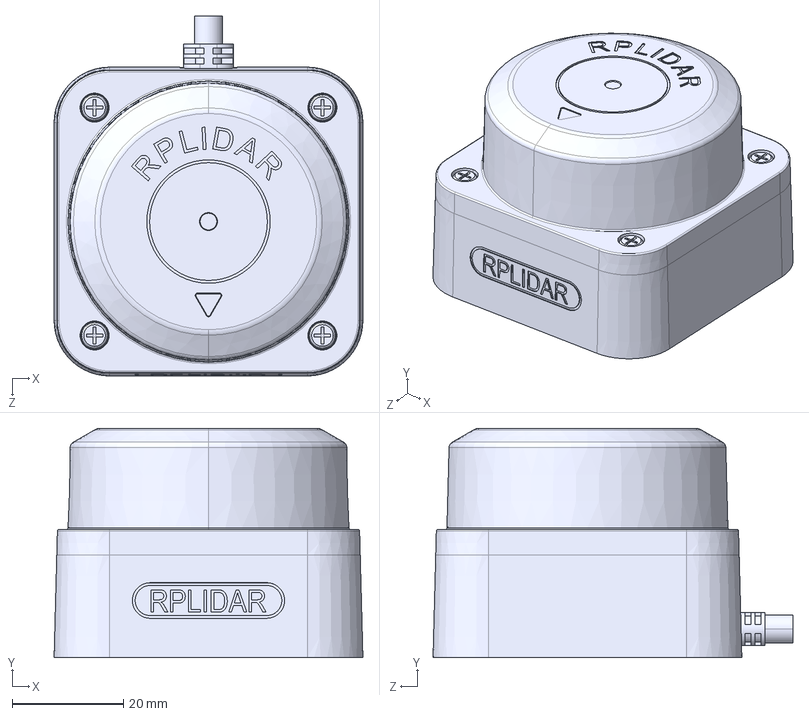
[picture p116: CAD file, 2026-09-28]
cad/Components/RPLIDAR C1.STEP
55.6 x 41.3 x 64.8 mm
