AtlasAutoware/carv1/cad/Mounts/newcar/out/battery_bank_underslung.step

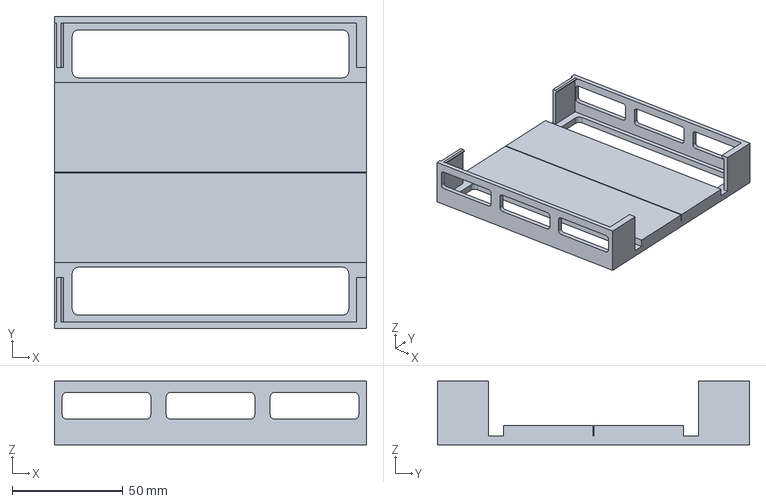
[picture p117: CAD file, 2026-09-28]
cad/Mounts/newcar/out/battery_bank_underslung.step
140.9 x 140.9 x 28.7 mm
