AtlasAutoware/carv1/cad/Mounts/original/Jetson Orin Nano Mount Base.stl

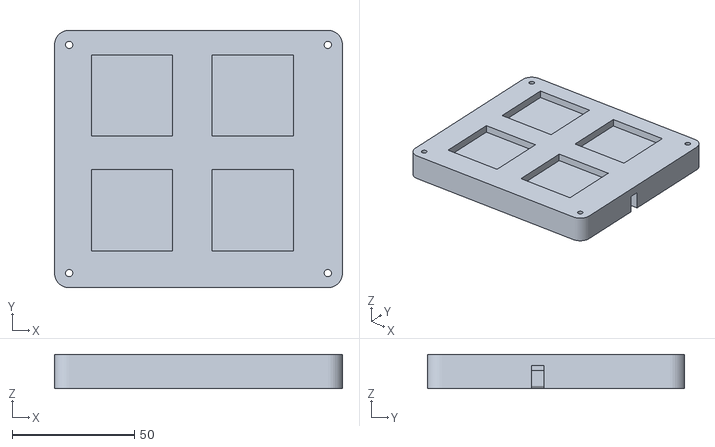
[picture p118: CAD file, 2026-09-28]
cad/Mounts/original/Jetson Orin Nano Mount Base.stl
118.0 x 105.5 x 14.0
