AtlasAutoware/carv1/cad/Mounts/out/fab/AtlasAutoware_Baseplate_v2_newcar.dxf

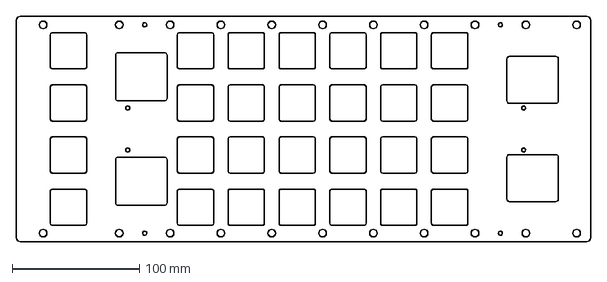
[picture p119: CAD file, 2026-09-28]
cad/Mounts/out/fab/AtlasAutoware_Baseplate_v2_newcar.dxf
452.0 x 177.5 mm
