AtlasAutoware/carv1/cad/Mounts/out/omni20_cradle.step

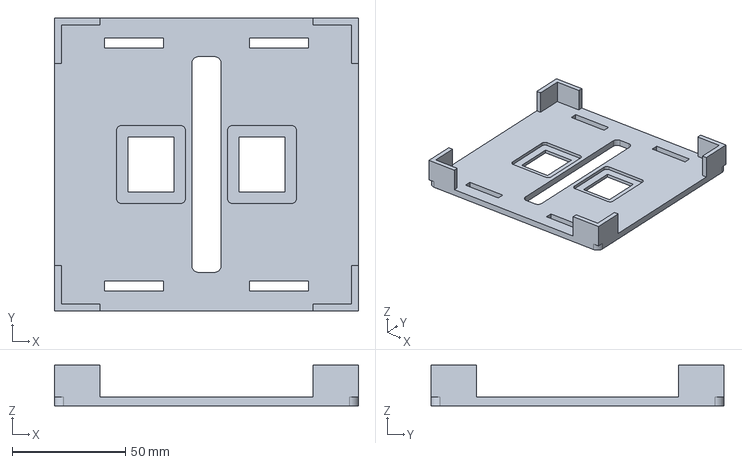
[picture p120: CAD file, 2026-09-28]
cad/Mounts/out/omni20_cradle.step
134.2 x 129.2 x 18.0 mm
