AtlasAutoware/carv1/cad/Templates/Clipless Mounting Piece.step

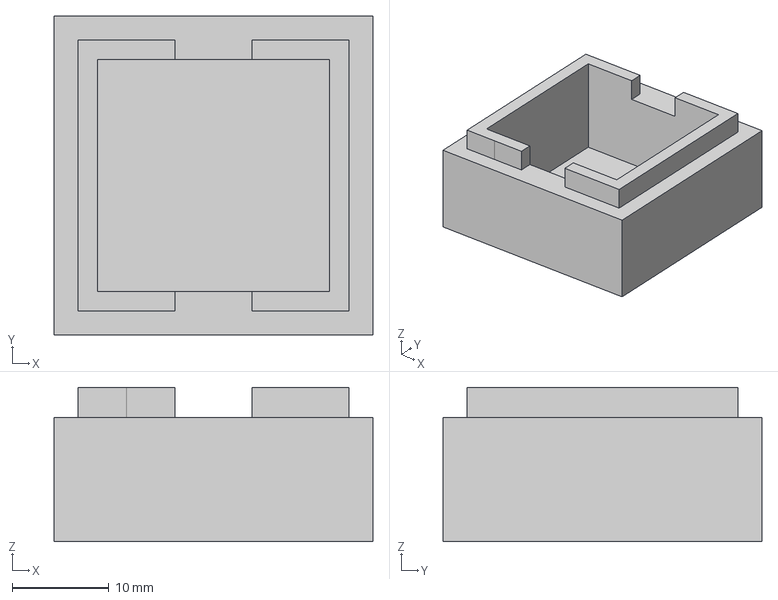
[picture p121: CAD file, 2026-09-28]
cad/Templates/Clipless Mounting Piece.step
33.0 x 33.0 x 16.0 mm
