AtlasAutoware/carv1/cad/Components/PCA9685 16-Channel Servo Driver - Generic.step

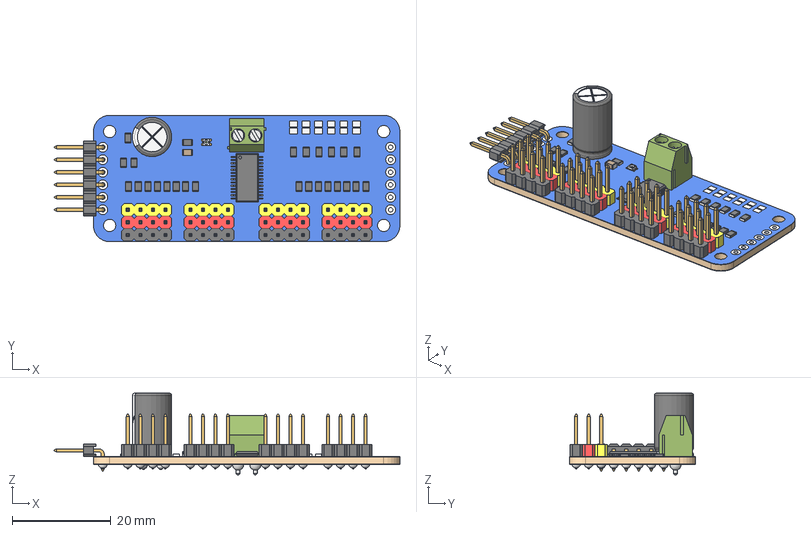
[picture p122: CAD file, 2026-09-28]
cad/Components/PCA9685 16-Channel Servo Driver - Generic.step
70.2 x 25.7 x 16.6 mm
