AtlasAutoware/carv1/cad/Mounts/original/PCA9685 Servo Driver Mount.stl

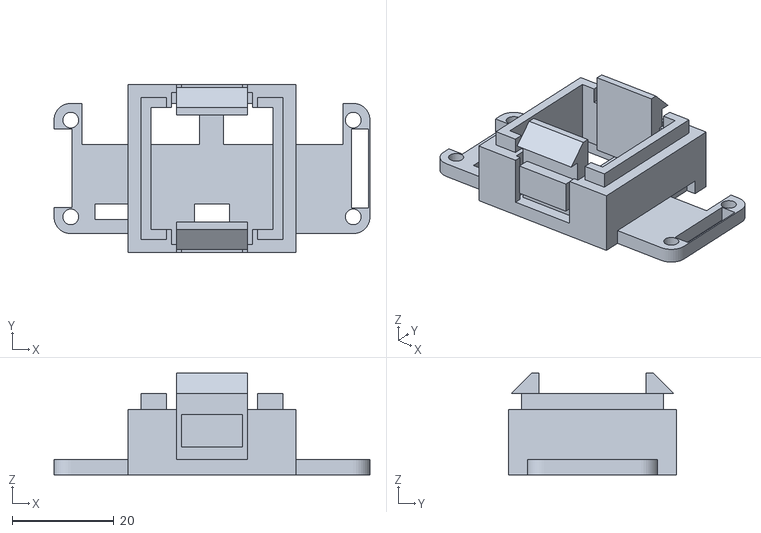
[picture p123: CAD file, 2026-09-28]
cad/Mounts/original/PCA9685 Servo Driver Mount.stl
62.2 x 33.0 x 20.0
