AtlasAutoware/carv1/cad/Mounts/out/fab/AtlasAutoware_Baseplate_v2_oldcar.dxf

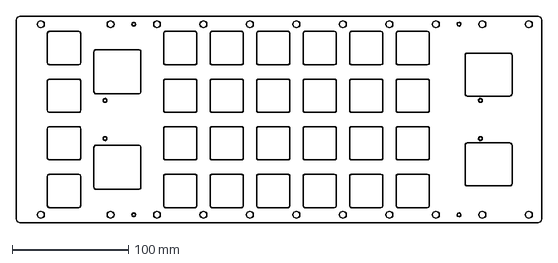
[picture p124: CAD file, 2026-09-28]
cad/Mounts/out/fab/AtlasAutoware_Baseplate_v2_oldcar.dxf
452.0 x 177.5 mm
