AtlasAutoware/carv1/cad/Templates/Baseplate.stl

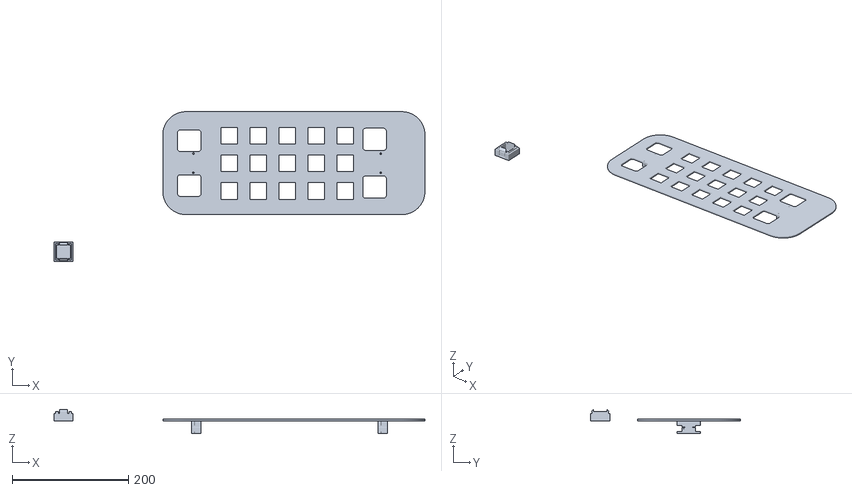
[picture p125: CAD file, 2026-09-28]
cad/Templates/Baseplate.stl
639.5 x 258.0 x 42.0
