AtlasAutoware/carv1/cad/Mounts/original/Embrava Blynclight Mount.stl

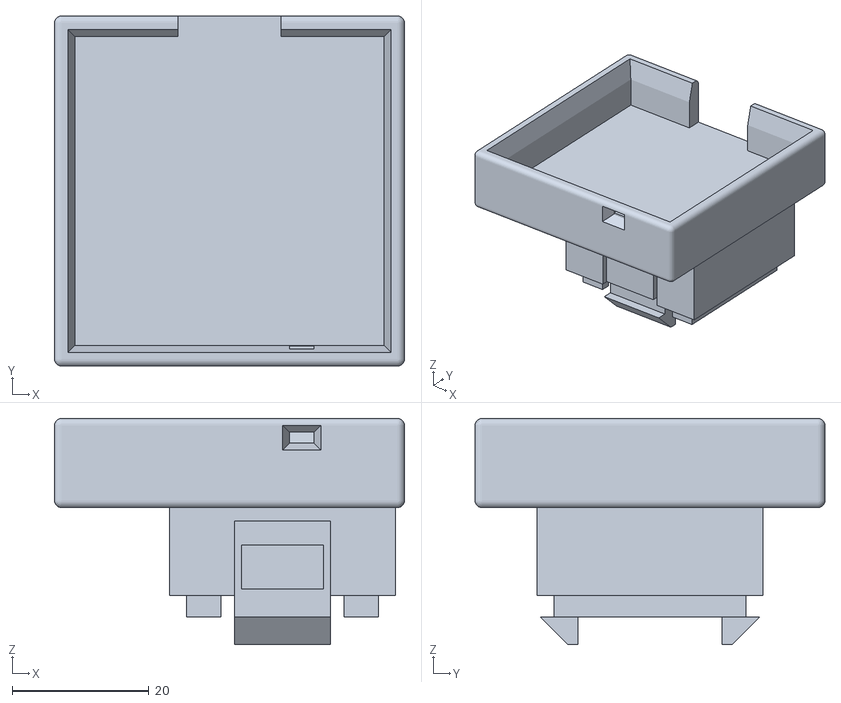
[picture p126: CAD file, 2026-09-28]
cad/Mounts/original/Embrava Blynclight Mount.stl
51.1 x 51.1 x 33.0
