AtlasAutoware/carv1/cad/Templates/Mounting Piece.step

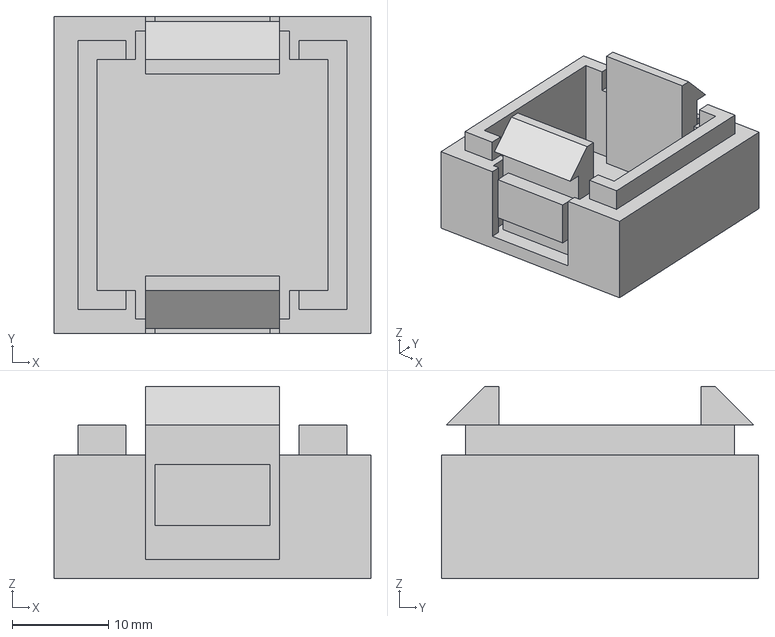
[picture p127: CAD file, 2026-09-28]
cad/Templates/Mounting Piece.step
33.0 x 33.0 x 20.0 mm
