AtlasAutoware/carv1/cad/Mounts/original/Jetson Orin Nano Mount Top.stl

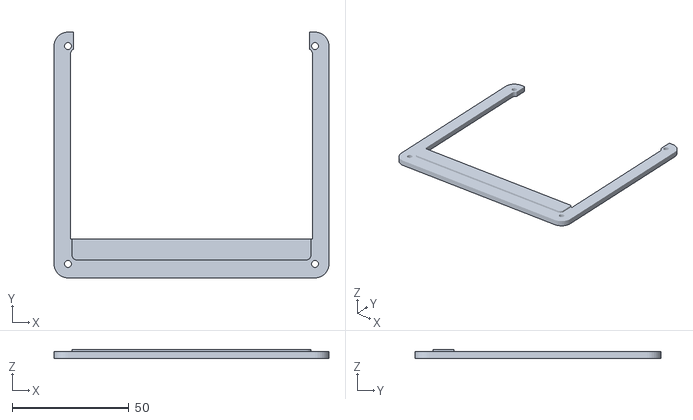
[picture p128: CAD file, 2026-09-28]
cad/Mounts/original/Jetson Orin Nano Mount Top.stl
118.0 x 105.5 x 4.00
