AtlasAutoware/carv1/cad/Mounts/out/jetson_orin_nano.step

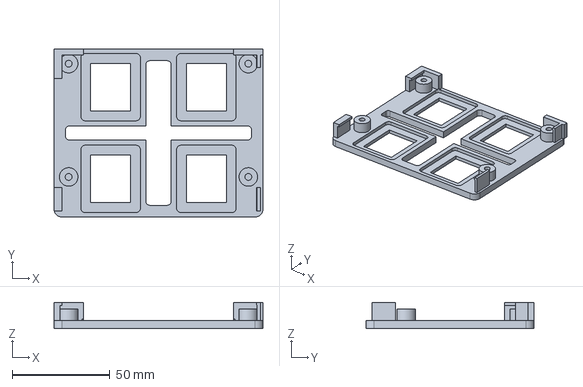
[picture p129: CAD file, 2026-09-28]
cad/Mounts/out/jetson_orin_nano.step
107.0 x 86.0 x 13.4 mm
