AtlasAutoware/carv1/cad/Mounts/original/RPLIDAR C1 Mount.stl

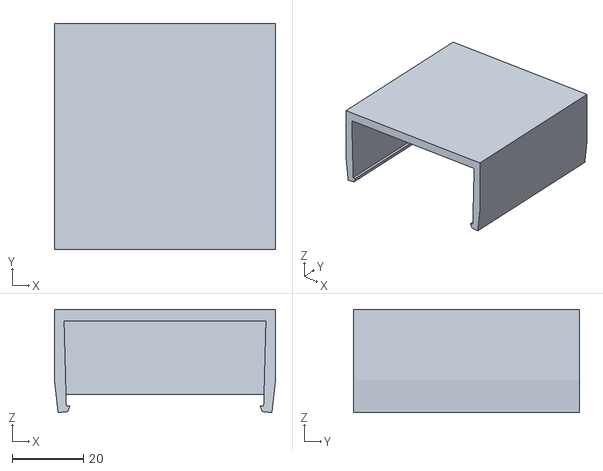
[picture p130: CAD file, 2026-09-28]
cad/Mounts/original/RPLIDAR C1 Mount.stl
62.0 x 63.5 x 29.0
