AtlasAutoware/carv1/cad/Mounts/out/vesc_tub_bracket.step

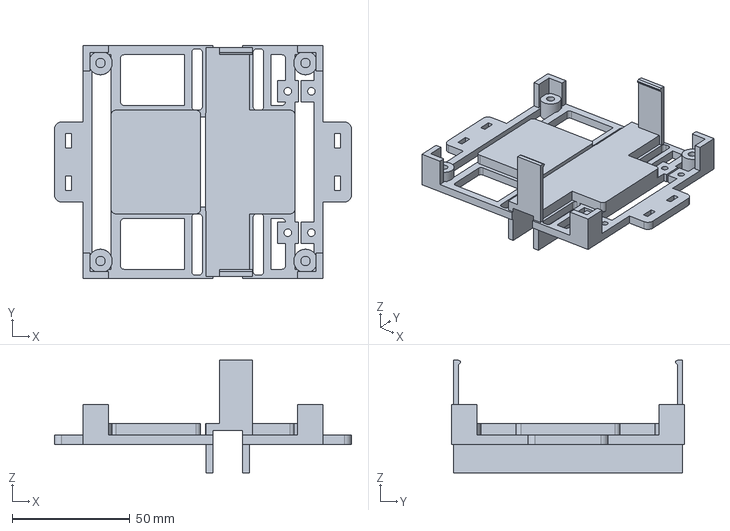
[picture p131: CAD file, 2026-09-28]
cad/Mounts/out/vesc_tub_bracket.step
126.0 x 99.0 x 47.8 mm
