AtlasAutoware/carv1/cad/Mounts/out/small_board_plate.step

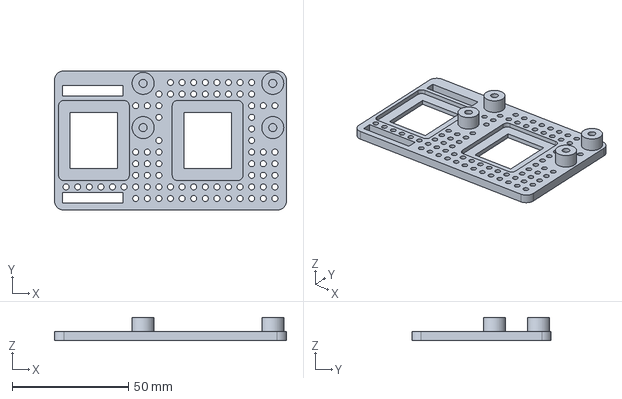
[picture p132: CAD file, 2026-09-28]
cad/Mounts/out/small_board_plate.step
100.0 x 60.0 x 10.0 mm
