AtlasAutoware/carv1/cad/Mounts/newcar/out/camera_mast_newcar.step

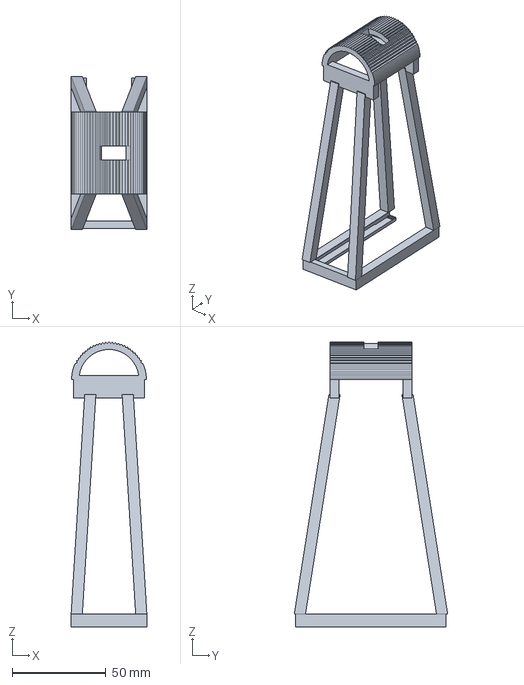
[picture p133: CAD file, 2026-09-28]
cad/Mounts/newcar/out/camera_mast_newcar.step
40.5 x 82.0 x 152.4 mm
