AtlasAutoware/carv1/cad/Mounts/out/camera_mast_v2.step

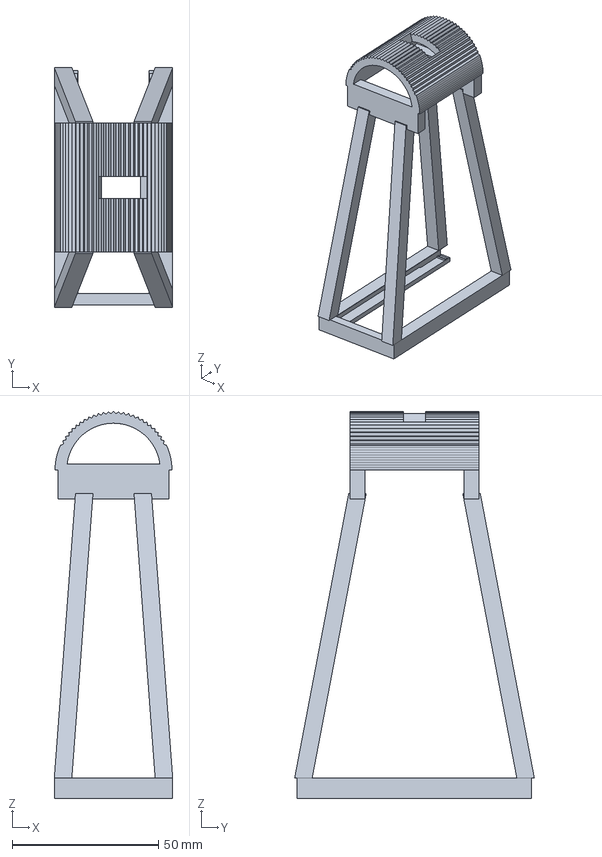
[picture p134: CAD file, 2026-09-28]
cad/Mounts/out/camera_mast_v2.step
40.5 x 82.0 x 132.4 mm
