AtlasAutoware/carv1/cad/Mounts/newcar/out/camera_mast_head_newcar.stl

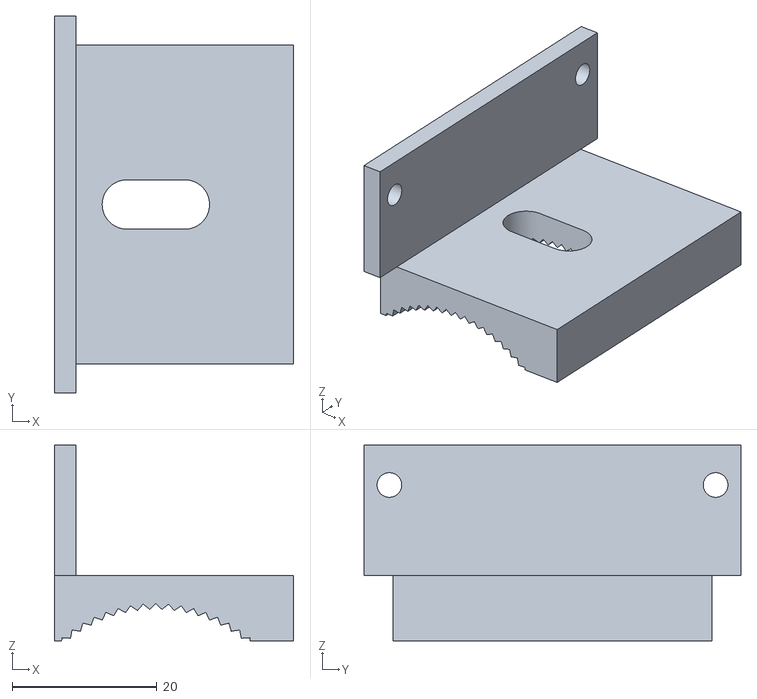
[picture p135: CAD file, 2026-09-28]
cad/Mounts/newcar/out/camera_mast_head_newcar.stl
33.0 x 52.0 x 27.0
