AtlasAutoware/carv1/cad/Mounts/out/baseplate_v2_rear_6mm.stl

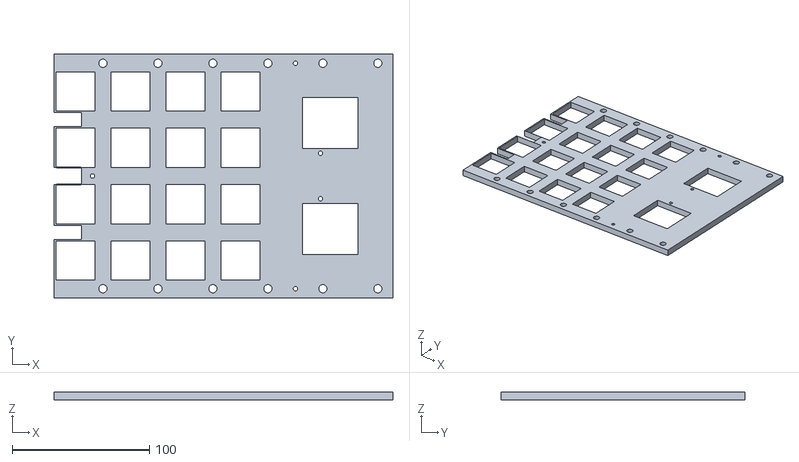
[picture p136: CAD file, 2026-09-28]
cad/Mounts/out/baseplate_v2_rear_6mm.stl
246.6 x 177.5 x 6.00
