AtlasAutoware/carv1/cad/Mounts/newcar/out/baseplate_v2_newcar.step

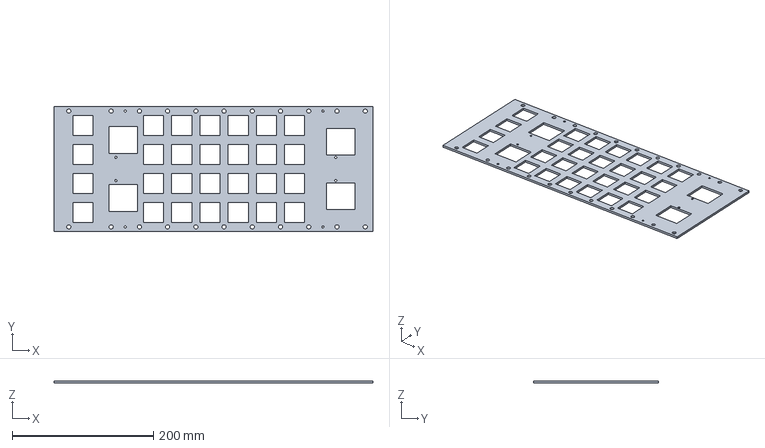
[picture p137: CAD file, 2026-09-28]
cad/Mounts/newcar/out/baseplate_v2_newcar.step
452.0 x 177.5 x 3.17 mm
