AtlasAutoware/carv1/cad/Mounts/out/cable_tidy_edge.step

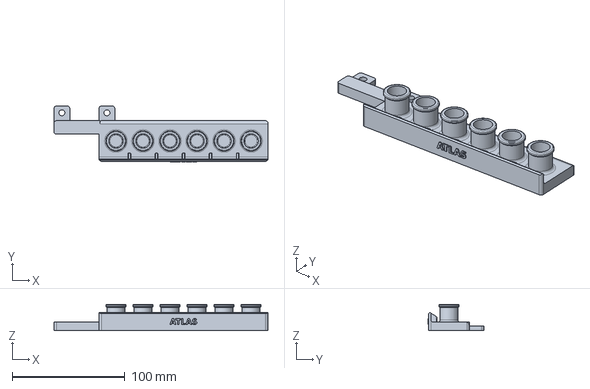
[picture p138: CAD file, 2026-09-28]
cad/Mounts/out/cable_tidy_edge.step
190.0 x 49.6 x 23.5 mm
