AtlasAutoware/carv1/cad/Mounts/newcar/out/tim561.step

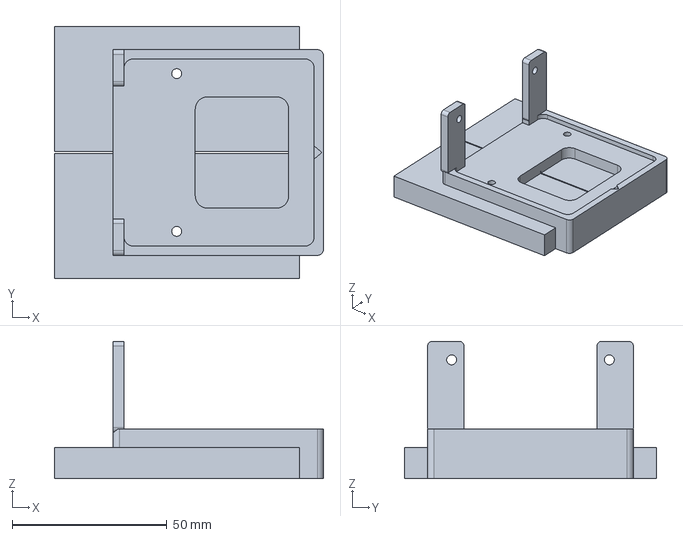
[picture p139: CAD file, 2026-09-28]
cad/Mounts/newcar/out/tim561.step
87.0 x 81.5 x 44.4 mm
