AtlasAutoware/carv1/cad/Mounts/newcar/out/vesc_fsesc67_p41.step

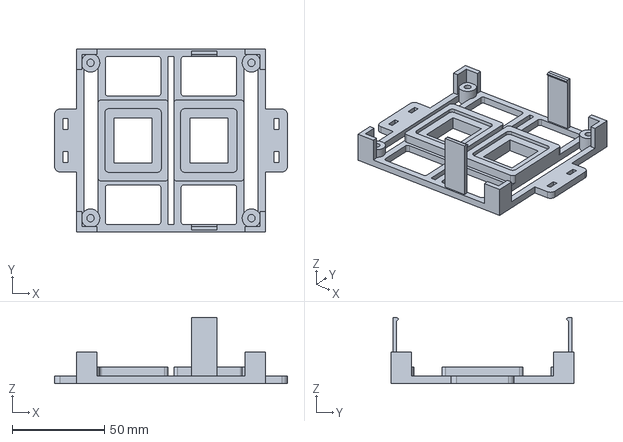
[picture p140: CAD file, 2026-09-28]
cad/Mounts/newcar/out/vesc_fsesc67_p41.step
126.0 x 99.0 x 35.8 mm
