AtlasAutoware/carv1/cad/Mounts/out/vesc_fsesc67_under.step

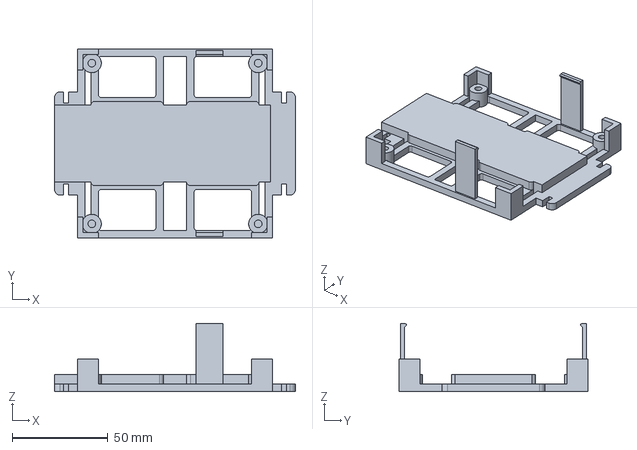
[picture p141: CAD file, 2026-09-28]
cad/Mounts/out/vesc_fsesc67_under.step
126.0 x 99.0 x 35.8 mm
