AtlasAutoware/carv1/cad/Mounts/out/rplidar_c1_v2.step

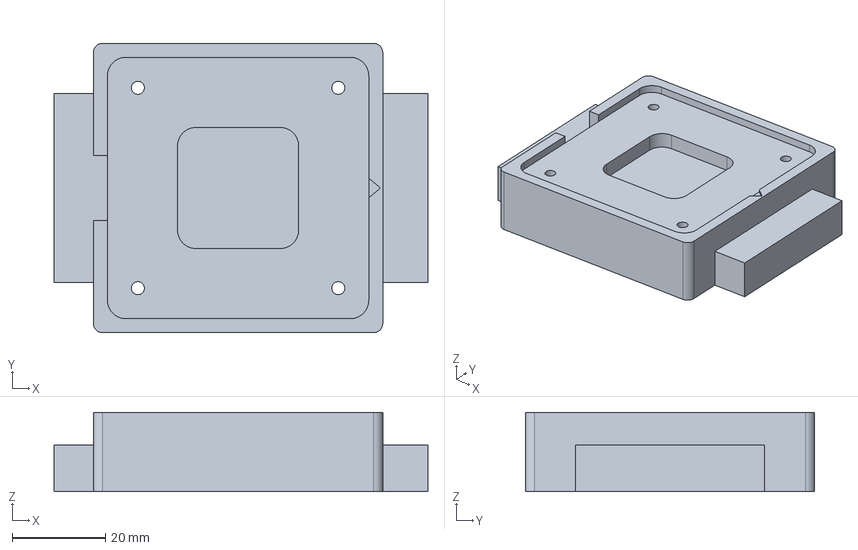
[picture p142: CAD file, 2026-09-28]
cad/Mounts/out/rplidar_c1_v2.step
80.2 x 62.1 x 17.0 mm
