AtlasAutoware/carv1/cad/Mounts/out/cable_tidy.step

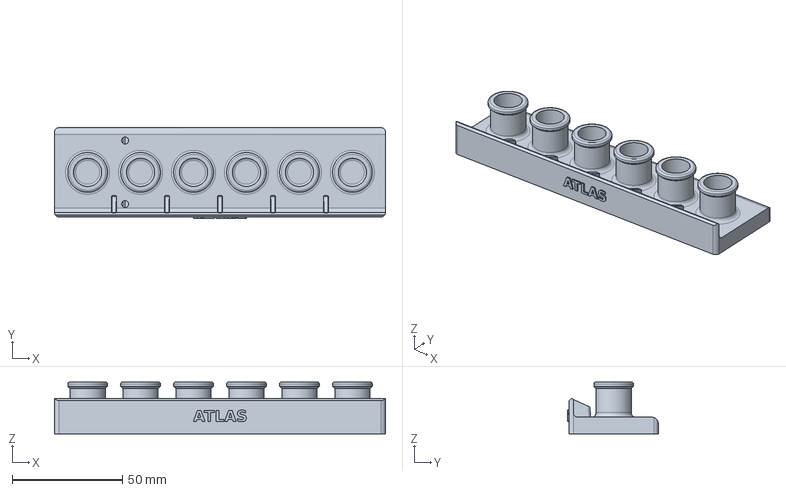
[picture p143: CAD file, 2026-09-28]
cad/Mounts/out/cable_tidy.step
150.0 x 41.1 x 23.5 mm
