AtlasAutoware/carv1/cad/Mounts/out/lipo_smc_9000_v2.step

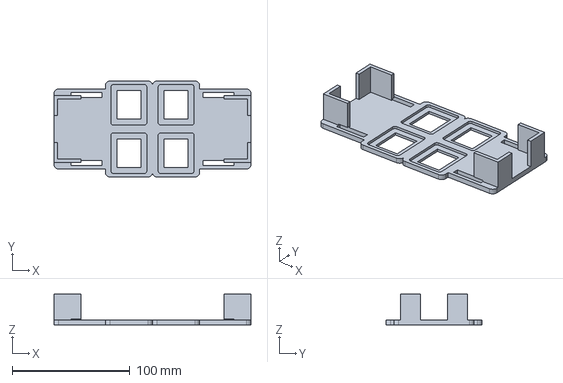
[picture p144: CAD file, 2026-09-28]
cad/Mounts/out/lipo_smc_9000_v2.step
167.0 x 81.5 x 26.0 mm
