AtlasAutoware/carv1/cad/Mounts/out/liteon_45w_brick.step

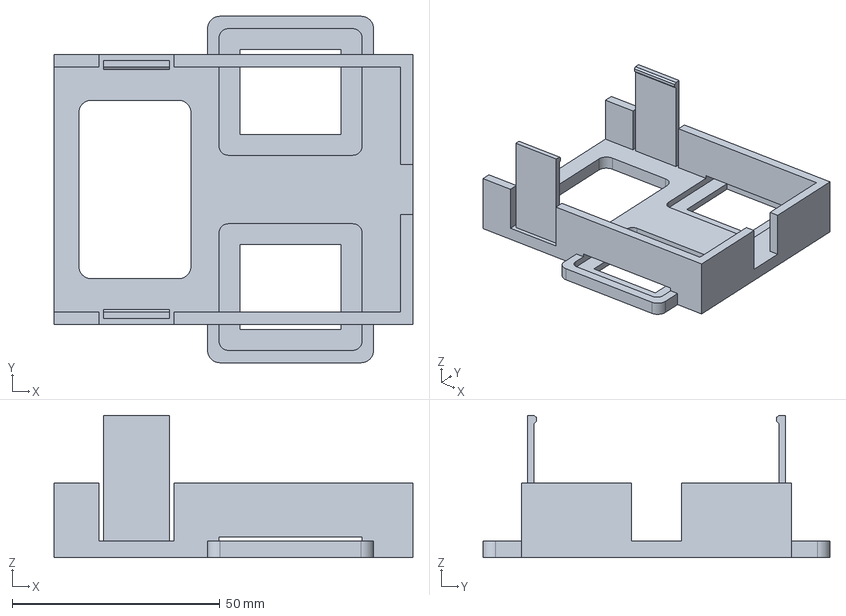
[picture p145: CAD file, 2026-09-28]
cad/Mounts/out/liteon_45w_brick.step
86.5 x 83.5 x 34.3 mm
