AtlasAutoware/carv1/cad/Mounts/out/baseplate_v2_front_6mm.stl

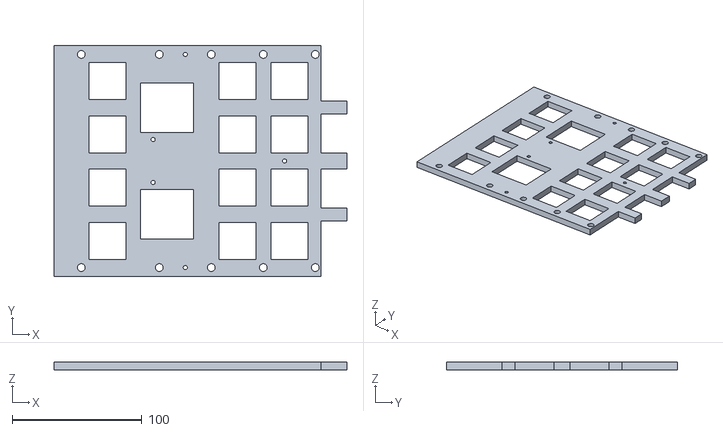
[picture p146: CAD file, 2026-09-28]
cad/Mounts/out/baseplate_v2_front_6mm.stl
225.4 x 177.5 x 6.00
