AtlasAutoware/carv1/cad/Mounts/out/baseplate_v2_front.step

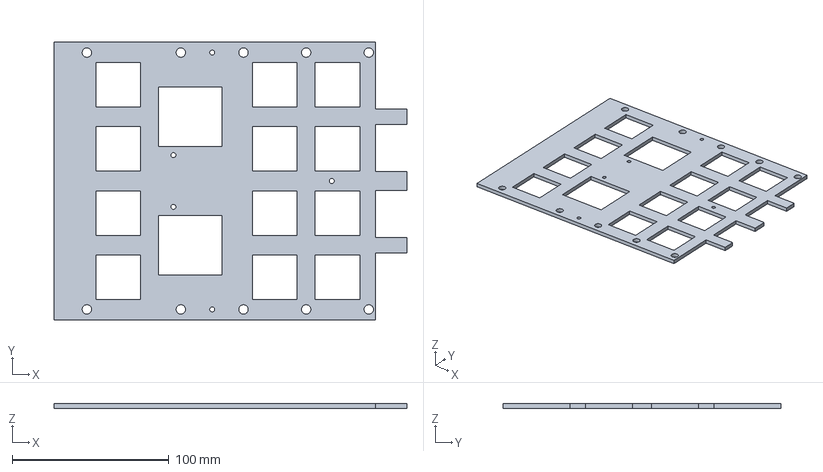
[picture p147: CAD file, 2026-09-28]
cad/Mounts/out/baseplate_v2_front.step
225.4 x 177.5 x 3.17 mm
