AtlasAutoware/carv1/cad/Mounts/out/clipless_foot.step

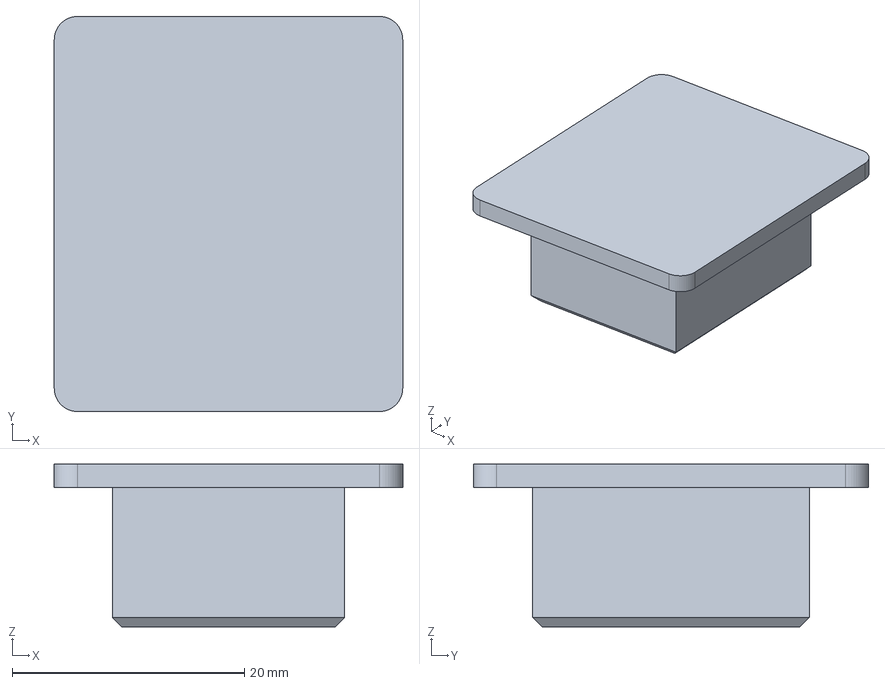
[picture p148: CAD file, 2026-09-28]
cad/Mounts/out/clipless_foot.step
30.0 x 34.0 x 14.0 mm
