AtlasAutoware/carv1/cad/Mounts/out/clipless_piece_x12.stl

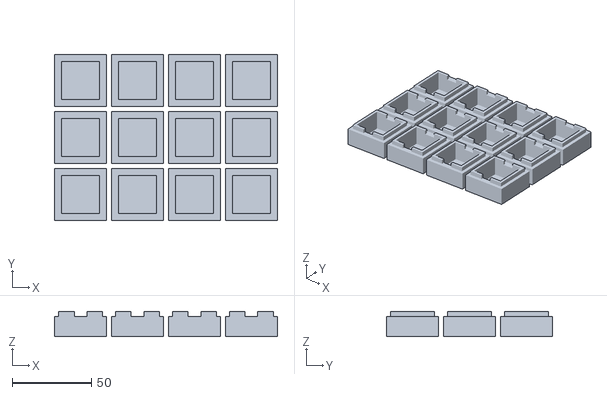
[picture p149: CAD file, 2026-09-28]
cad/Mounts/out/clipless_piece_x12.stl
141.0 x 105.0 x 16.0
