AtlasAutoware/carv1/cad/Mounts/out/omni20_cradle_v2.step

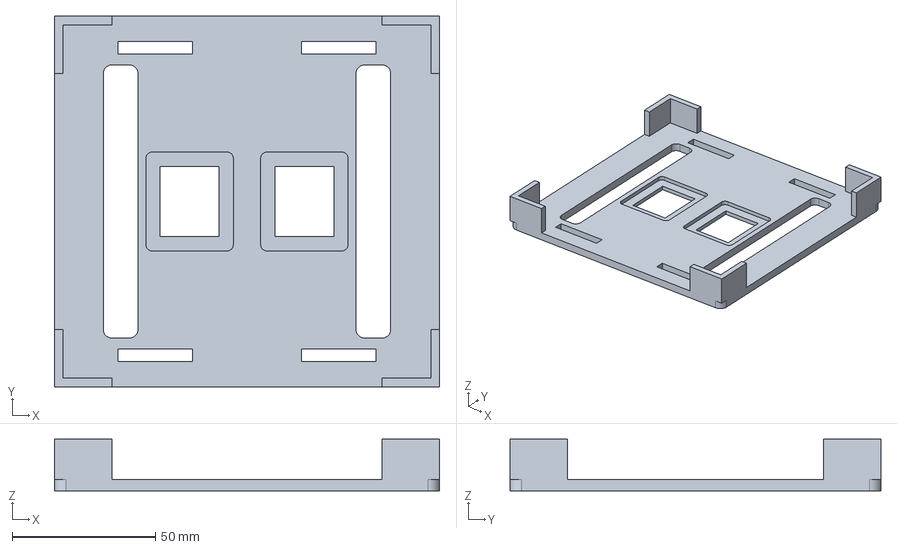
[picture p150: CAD file, 2026-09-28]
cad/Mounts/out/omni20_cradle_v2.step
134.2 x 129.2 x 18.0 mm
