AtlasAutoware/carv1/cad/Mounts/out/rplidar_c1.step

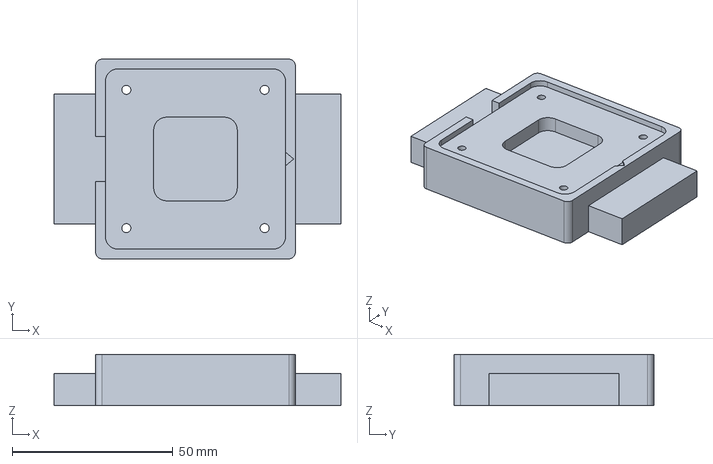
[picture p151: CAD file, 2026-09-28]
cad/Mounts/out/rplidar_c1.step
89.2 x 62.1 x 16.0 mm
