AtlasAutoware/carv1/cad/Mounts/out/liteon_45w_brick_under.step

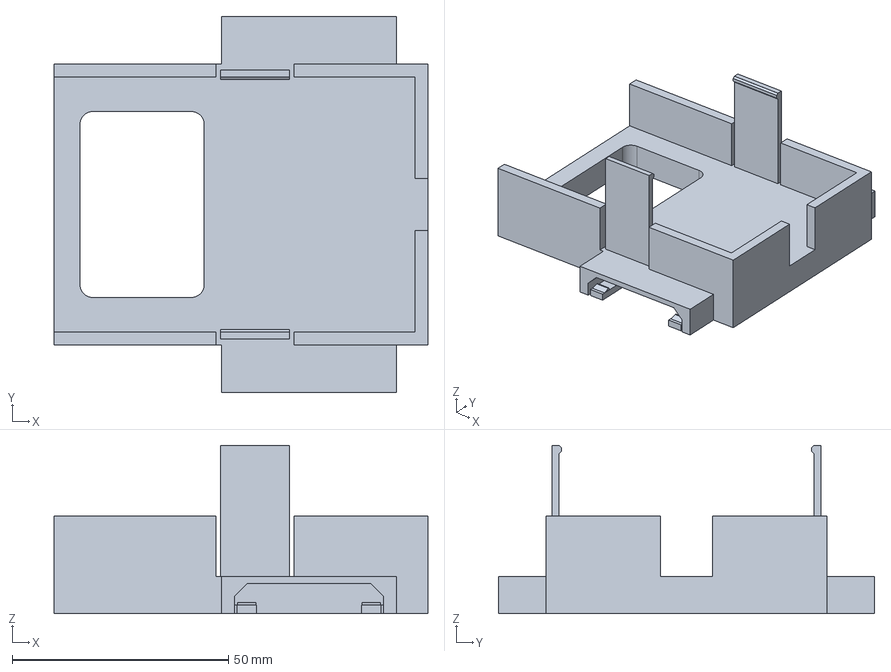
[picture p152: CAD file, 2026-09-28]
cad/Mounts/out/liteon_45w_brick_under.step
86.5 x 87.0 x 38.9 mm
