AtlasAutoware/carv1/cad/Mounts/out/small_board_plate_under.step

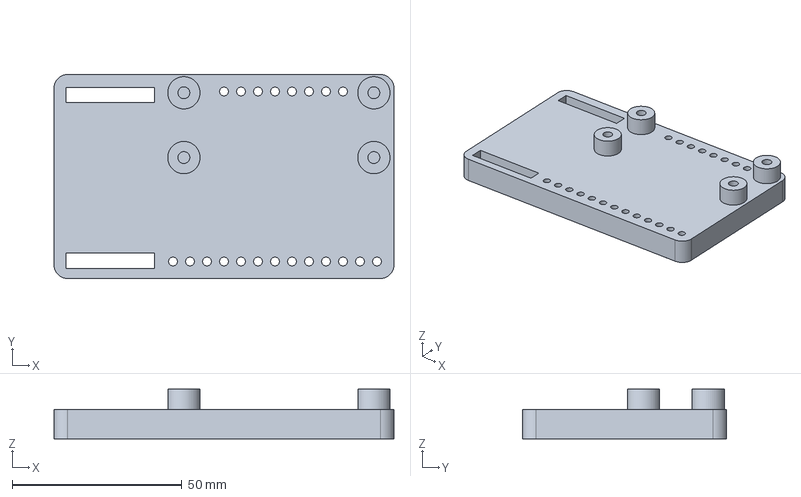
[picture p153: CAD file, 2026-09-28]
cad/Mounts/out/small_board_plate_under.step
100.0 x 60.0 x 14.6 mm
