AtlasAutoware/carv1/cad/Mounts/out/baseplate_v2_rear.step

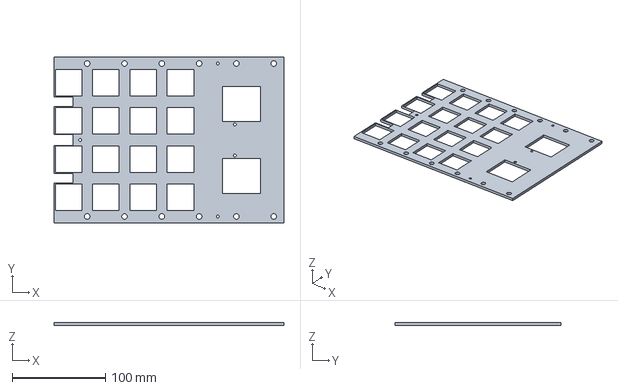
[picture p154: CAD file, 2026-09-28]
cad/Mounts/out/baseplate_v2_rear.step
246.6 x 177.5 x 3.17 mm
