AtlasAutoware/carv1/cad/Mounts/out/jetson_orin_nano_under.step

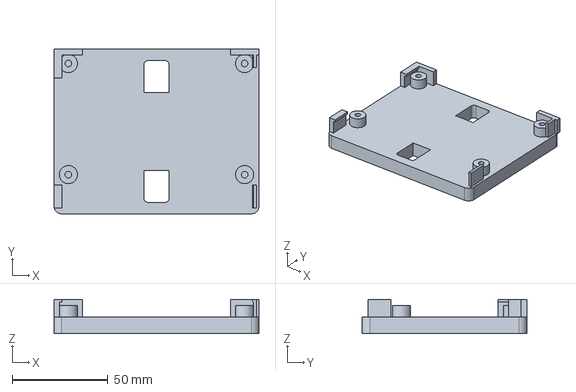
[picture p155: CAD file, 2026-09-28]
cad/Mounts/out/jetson_orin_nano_under.step
107.0 x 86.0 x 18.0 mm
