AtlasAutoware/carv1/cad/Mounts/out/camera_mast.step

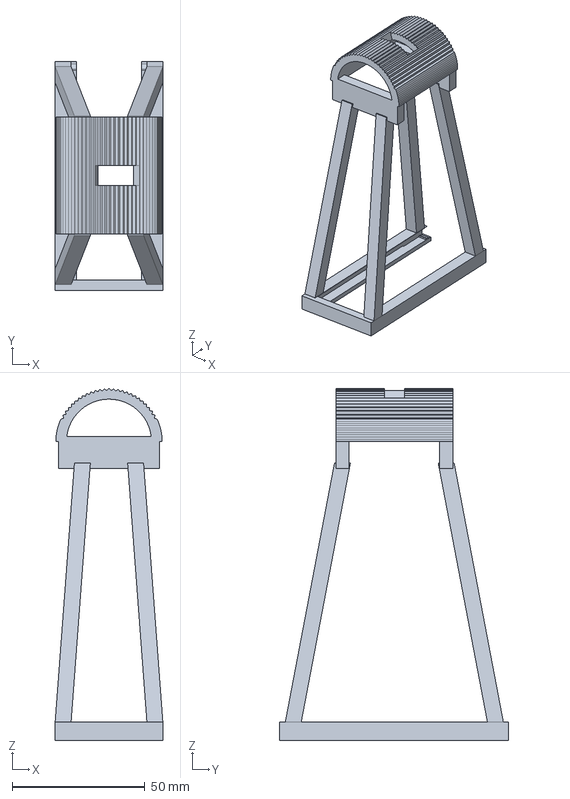
[picture p156: CAD file, 2026-09-28]
cad/Mounts/out/camera_mast.step
40.5 x 86.2 x 132.4 mm
