AtlasAutoware/carv1/cad/Mounts/out/liteon_45w_brick_v2.step

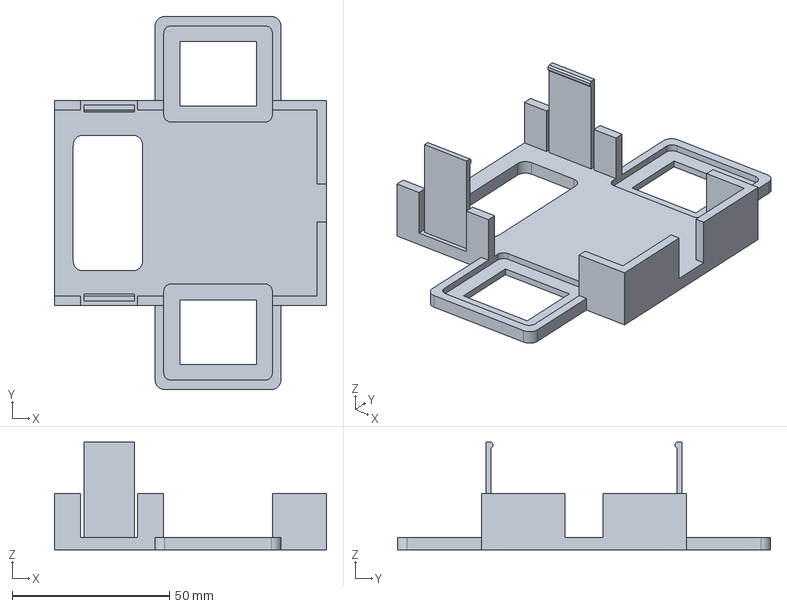
[picture p157: CAD file, 2026-09-28]
cad/Mounts/out/liteon_45w_brick_v2.step
86.5 x 118.5 x 34.3 mm
