AtlasAutoware/carv1/cad/Mounts/out/power_board_mount.step

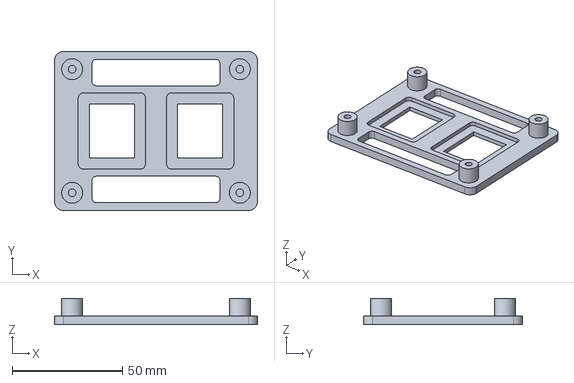
[picture p158: CAD file, 2026-09-28]
cad/Mounts/out/power_board_mount.step
92.0 x 72.0 x 12.0 mm
