AtlasAutoware/carv1/cad/Mounts/out/baseplate_v2_test_coupon.stl

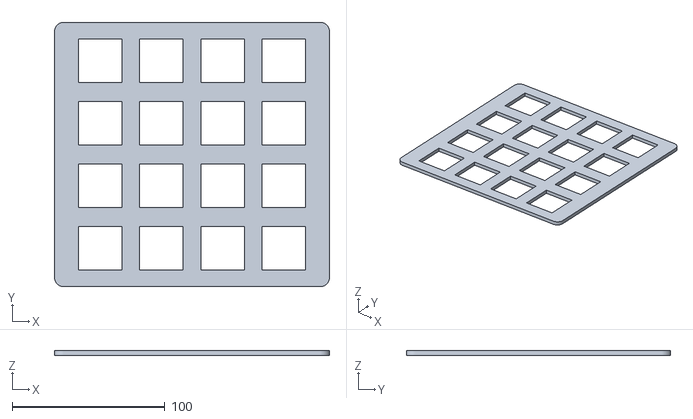
[picture p159: CAD file, 2026-09-28]
cad/Mounts/out/baseplate_v2_test_coupon.stl
180.0 x 173.0 x 3.17
