AtlasAutoware/carv1/cad/Mounts/out/cable_tidy_100.step

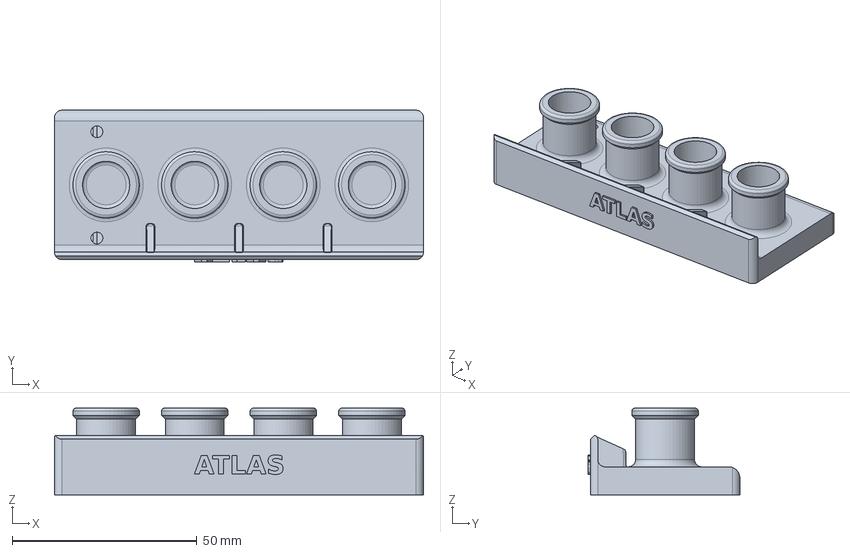
[picture p160: CAD file, 2026-09-28]
cad/Mounts/out/cable_tidy_100.step
100.0 x 41.1 x 23.5 mm
