AtlasAutoware/carv1/cad/Mounts/out/lipo_smc_9000.step

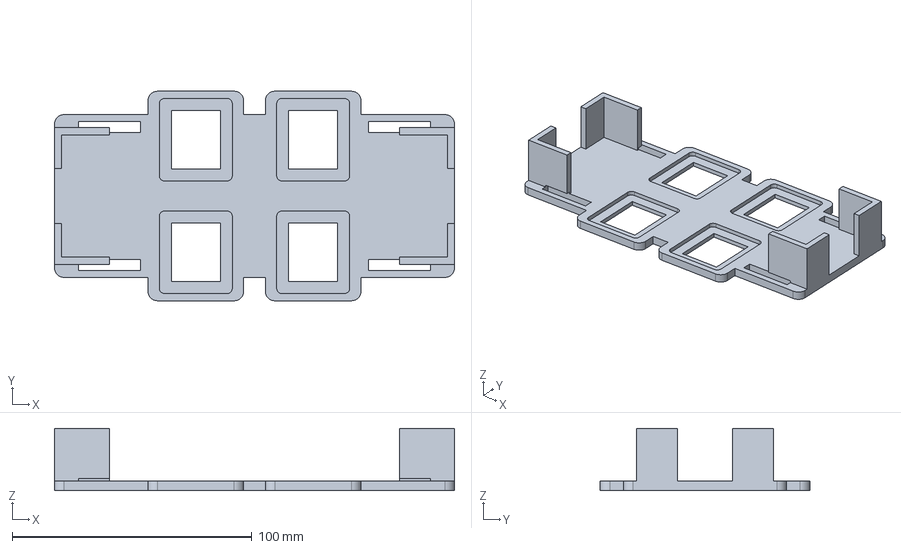
[picture p161: CAD file, 2026-09-28]
cad/Mounts/out/lipo_smc_9000.step
167.0 x 87.5 x 26.0 mm
