AtlasAutoware/carv1/(list of files, cad)

Other CAD files:
cad/Mounts/newcar/out/newcar_layout_above_assembly.step
cad/Mounts/newcar/out/newcar_layout_above_vescsaddle_assembly.step
cad/Mounts/newcar/out/newcar_layout_assembly.step
cad/Mounts/newcar/out/newcar_layout_blade100_assembly.step
cad/Mounts/out/board_layout_v2_mastB4C4_assembly.step
cad/Mounts/out/board_layout_v2_assembly.step
cad/Mounts/out/board_layout_v2_posts_assembly.step
cad/Mounts/out/small_board_plate_v2_assembly.step
cad/Mounts/out/vesc_fsesc67_under_assembly.step
cad/Mounts/out/board_layout_v2_mastB3C3_assembly.step
cad/Mounts/out/omni20_assembly_v2.step
cad/Mounts/out/vesc_fsesc67_assembly.step
cad/Mounts/out/board_layout_v2_vesc_assembly.step
cad/Mounts/out/clipless_piece.stl
cad/Mounts/out/vesc_fsesc67_v2.step
cad/Mounts/out/vesc_fsesc67.step
cad/Mounts/out/camera_mast_head.step
cad/Mounts/out/camera_mast_v2_head.step
cad/Mounts/out/baseplate_v2.step
cad/Mounts/out/vesc_tub_bracket_posts_L100.step
cad/Mounts/out/small_board_plate_v2.step
cad/Mounts/out/vesc_tub_bracket_posts.step
cad/Mounts/newcar/out/baseplate_v2_newcar.dxf
cad/Mounts/newcar/out/baseplate_v2_newcar.stl
cad/Mounts/newcar/out/battery_bank_underslung.stl
cad/Mounts/newcar/out/camera_mast_newcar.stl
cad/Mounts/newcar/out/tim561.stl
cad/Mounts/newcar/out/vesc_fsesc67_p41.stl
cad/Mounts/out/baseplate_v2.dxf
cad/Mounts/out/baseplate_v2.stl
cad/Mounts/out/baseplate_v2_front.stl
cad/Mounts/out/baseplate_v2_rear.stl
cad/Mounts/out/cable_tidy.stl
cad/Mounts/out/cable_tidy_100.stl
cad/Mounts/out/cable_tidy_edge.stl
cad/Mounts/out/camera_mast.stl
cad/Mounts/out/camera_mast_head.stl
cad/Mounts/out/camera_mast_v2.stl
cad/Mounts/out/camera_mast_v2_head.stl
cad/Mounts/out/clipless_foot.stl
cad/Mounts/out/jetson_orin_nano.stl
cad/Mounts/out/jetson_orin_nano_under.stl
cad/Mounts/out/lipo_smc_9000.stl
cad/Mounts/out/lipo_smc_9000_v2.stl
cad/Mounts/out/liteon_45w_brick.stl
cad/Mounts/out/liteon_45w_brick_under.stl
cad/Mounts/out/liteon_45w_brick_v2.stl
cad/Mounts/out/omni20_cradle.stl
cad/Mounts/out/omni20_cradle_v2.stl
cad/Mounts/out/power_board_mount.stl
cad/Mounts/out/rplidar_c1.stl
cad/Mounts/out/rplidar_c1_v2.stl
cad/Mounts/out/small_board_plate.stl
cad/Mounts/out/small_board_plate_under.stl
cad/Mounts/out/small_board_plate_v2.stl
cad/Mounts/out/vesc_fsesc67.stl
cad/Mounts/out/vesc_fsesc67_under.stl
cad/Mounts/out/vesc_fsesc67_v2.stl
cad/Mounts/out/vesc_tub_bracket.stl
cad/Mounts/out/vesc_tub_bracket_posts.stl
cad/Mounts/out/vesc_tub_bracket_posts_L100.stl
cad/Templates/Clipless Mounting Piece.stl
cad/Templates/Mounting Piece.stl
