AtlasAutoware/carv1/cad/Mounts/out/assembly_v2_3d.html

# Old car on Baseplate v2

isotopsidefrontunder

Grid: 40 mm along the car, 41 across. Front is +x (right in the side view).

hover a part

drag: orbit · right-drag / shift-drag: pan · wheel: zoom
