AtlasAutoware/carv1/cad/Mounts/newcar/out/battery_bank_underslung_assembly_lines.png

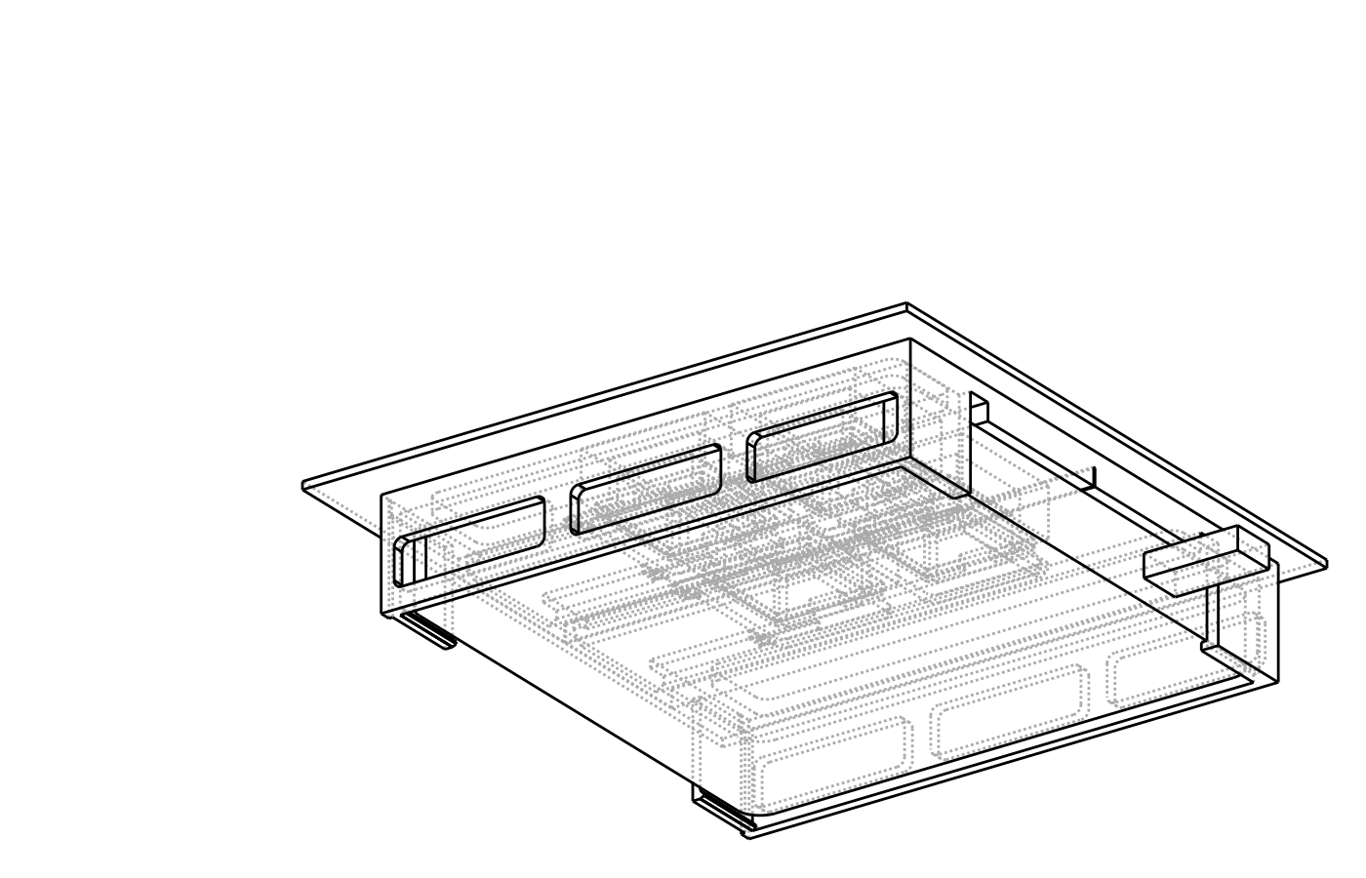
cad/Mounts/newcar/out/battery_bank_underslung_assembly_lines.png
