AtlasAutoware/carv1/cad/Mounts/newcar/out/tim561_assembly.png

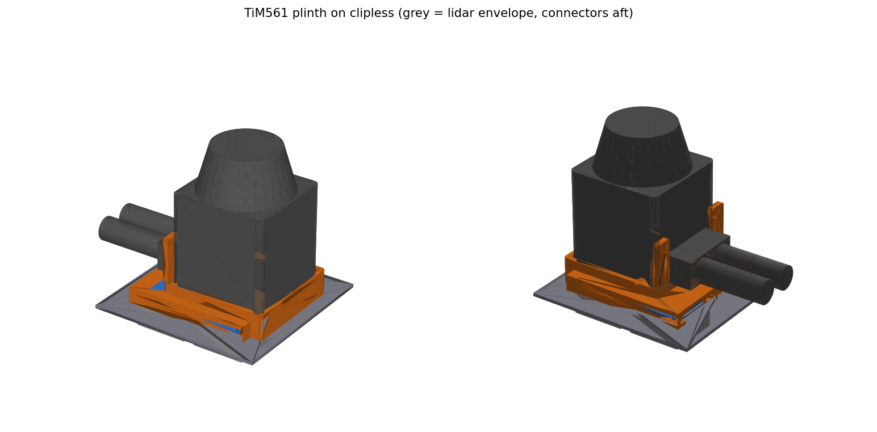
cad/Mounts/newcar/out/tim561_assembly.png
