AtlasAutoware/carv1/cad/Mounts/newcar/out/tim561_assembly_lines.png

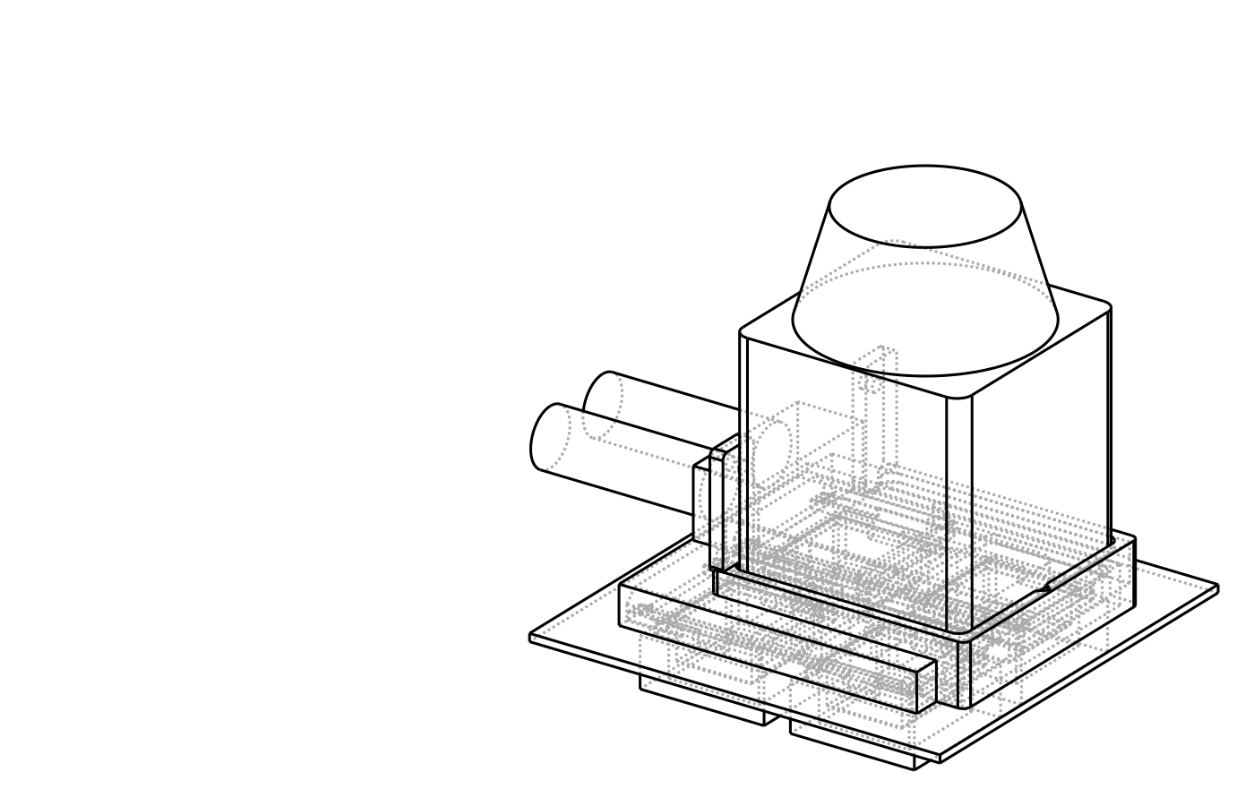
cad/Mounts/newcar/out/tim561_assembly_lines.png
