AtlasAutoware/carv1/cad/Mounts/out/_contact_assemblies.png

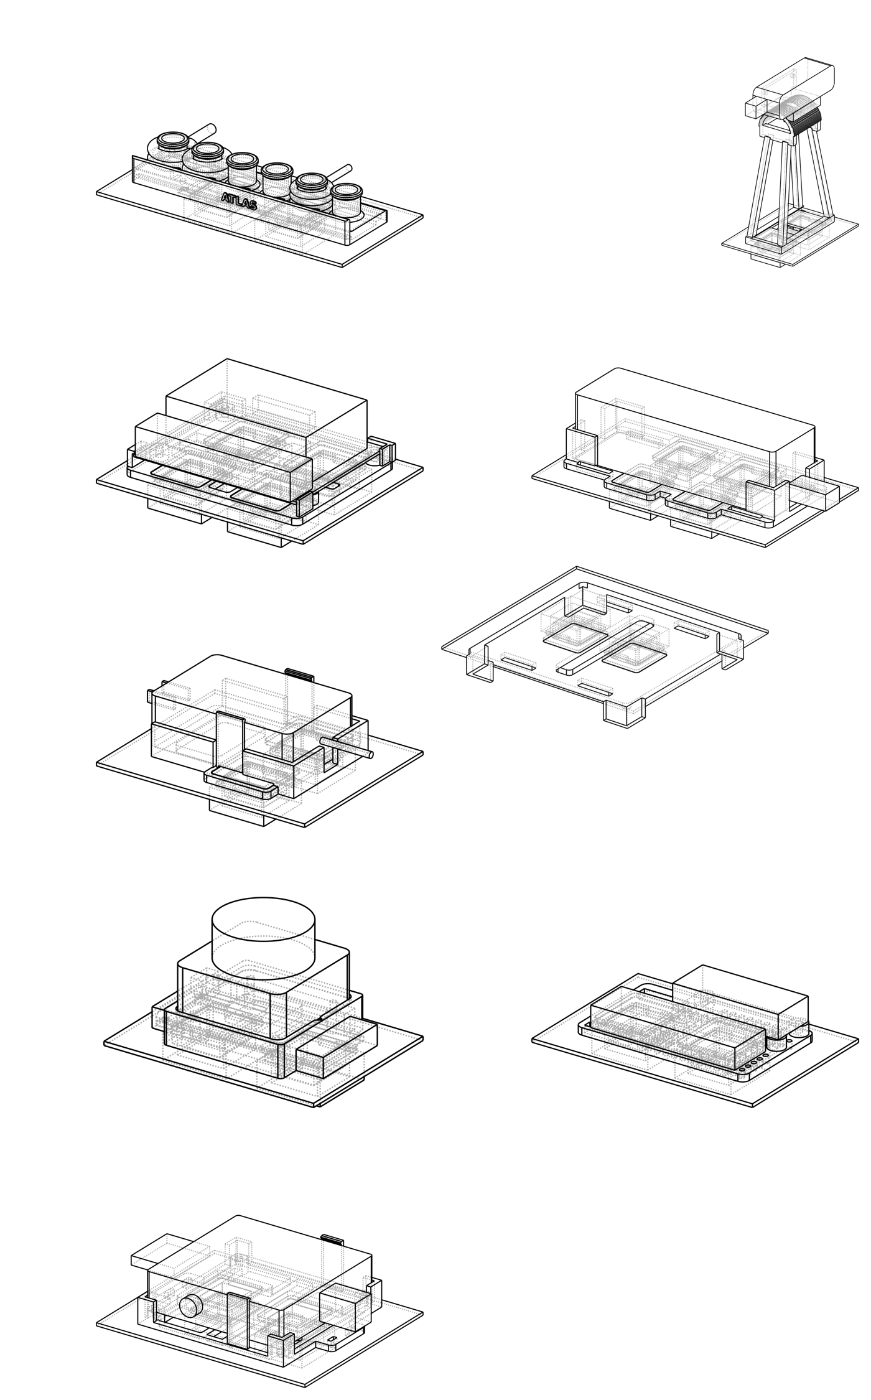
cad/Mounts/out/_contact_assemblies.png
