AtlasAutoware/carv1/cad/Mounts/out/assembly_v2_3d_preview.png

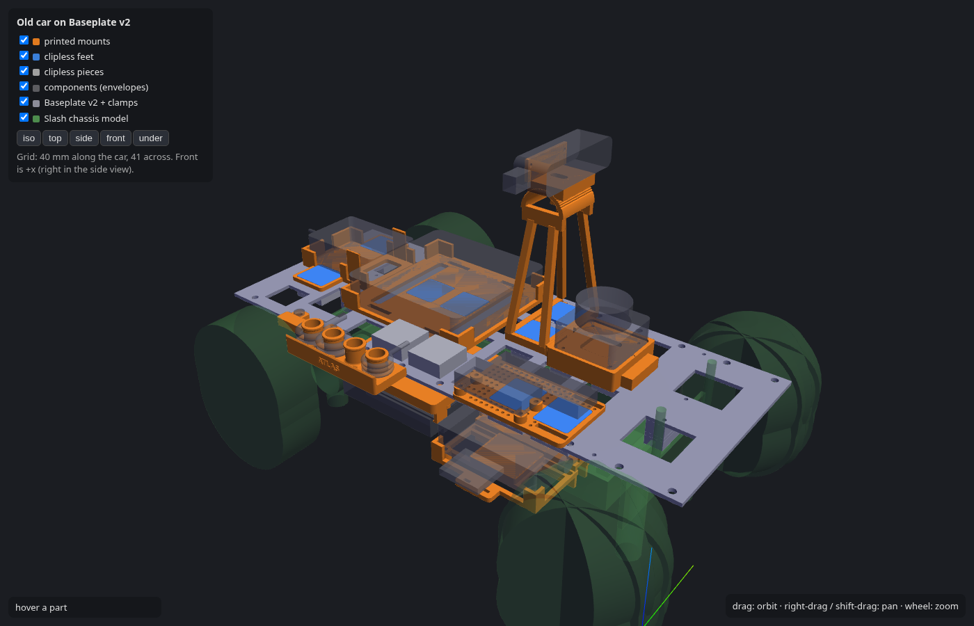
cad/Mounts/out/assembly_v2_3d_preview.png
