AtlasAutoware/carv1/cad/Mounts/out/cable_tidy_100_assembly.png

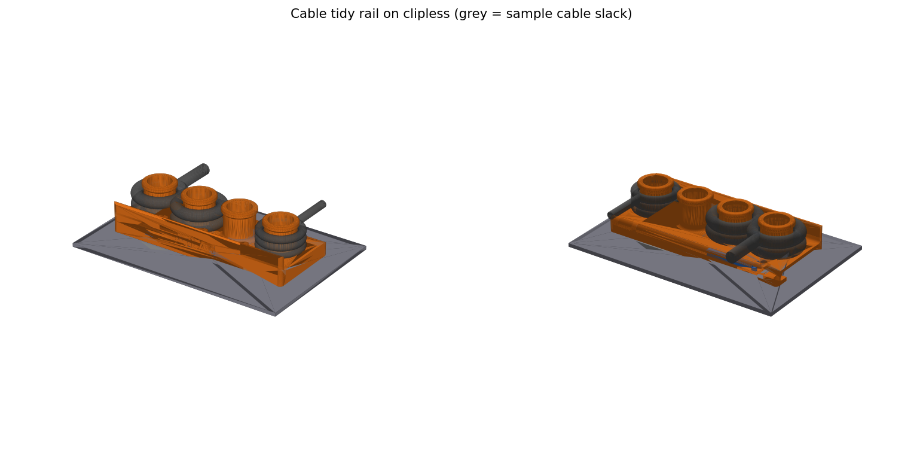
cad/Mounts/out/cable_tidy_100_assembly.png
