AtlasAutoware/carv1/cad/Mounts/out/cable_tidy_assembly.png

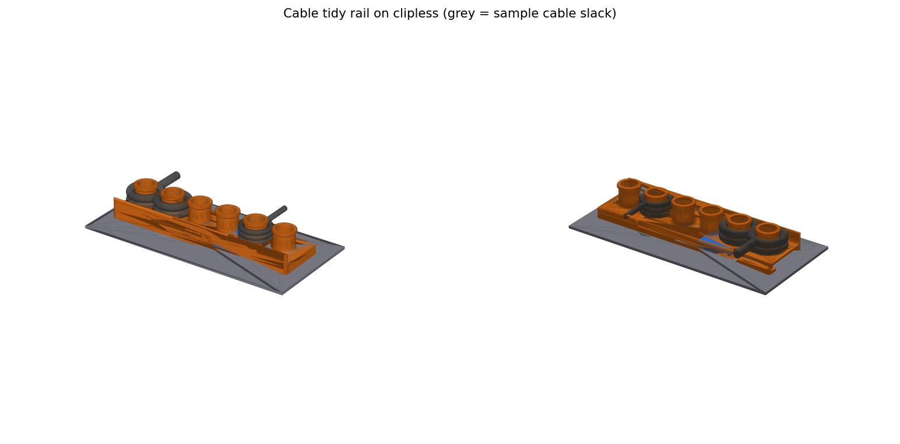
cad/Mounts/out/cable_tidy_assembly.png
