AtlasAutoware/carv1/cad/Mounts/out/cable_tidy_edge_assembly_lines.png

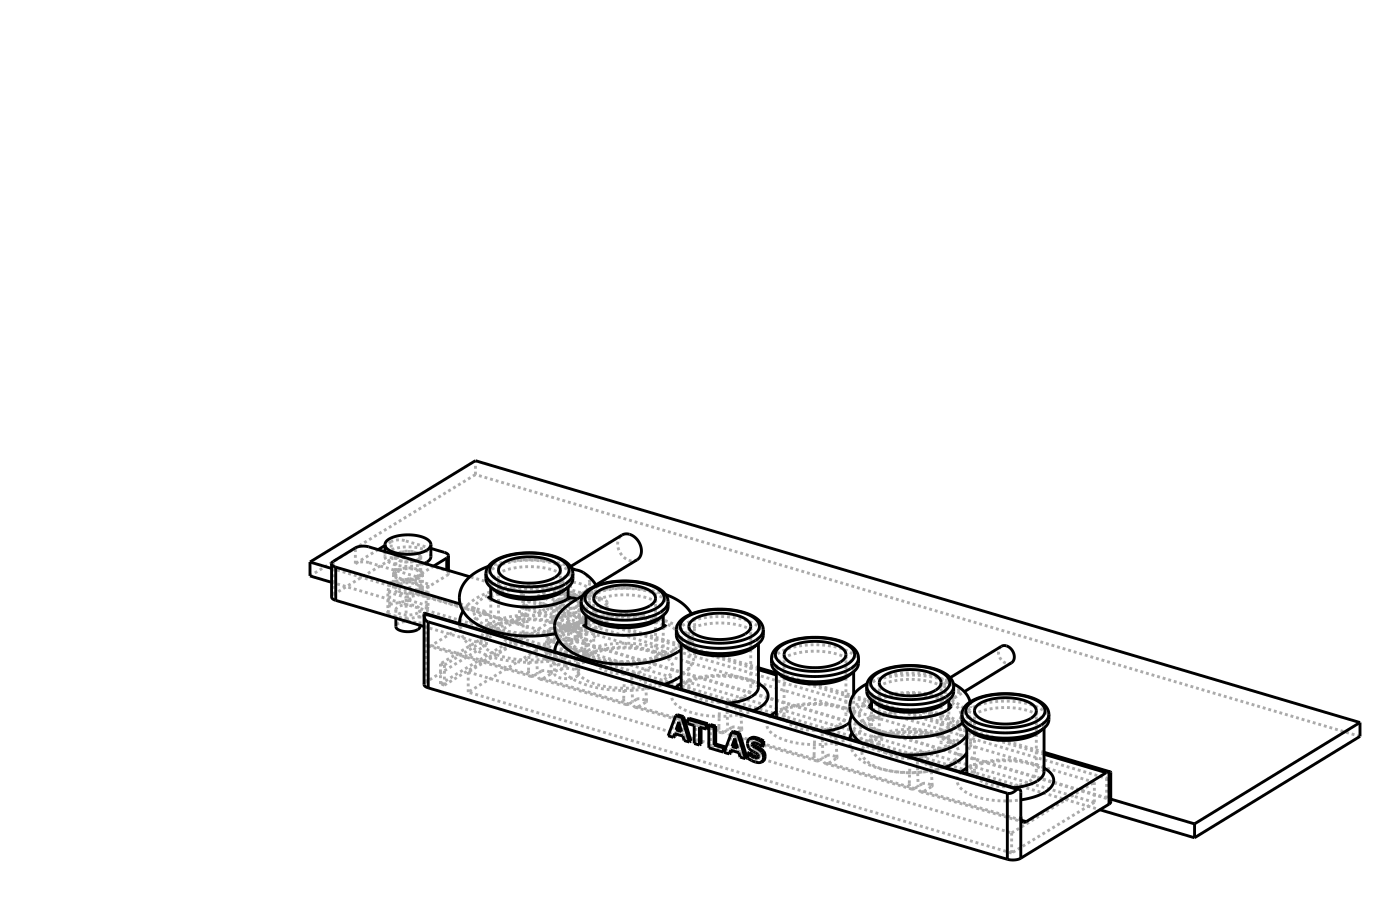
cad/Mounts/out/cable_tidy_edge_assembly_lines.png
