AtlasAutoware/carv1/cad/Mounts/out/lipo_smc_9000_assembly_lines.png

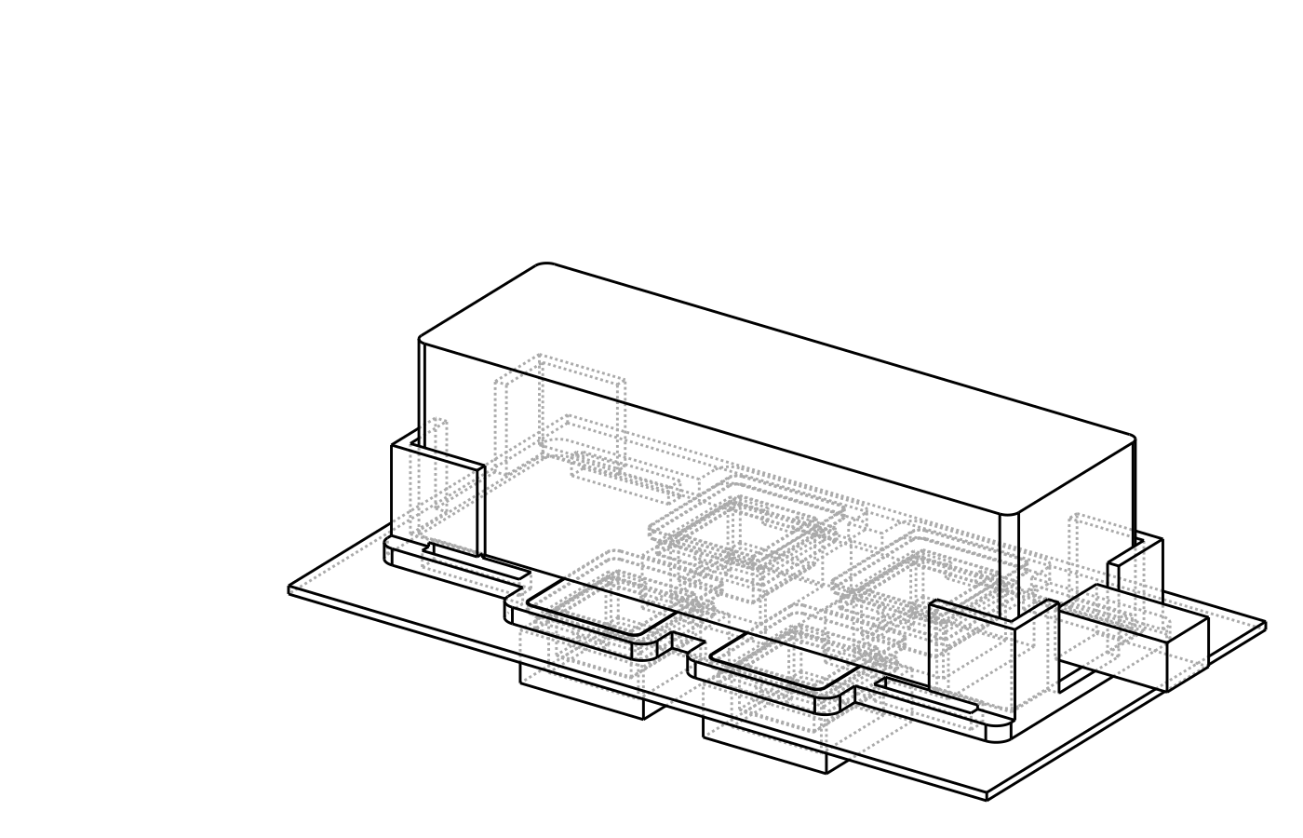
cad/Mounts/out/lipo_smc_9000_assembly_lines.png
