AtlasAutoware/carv1/cad/Mounts/out/liteon_fit_step2.png

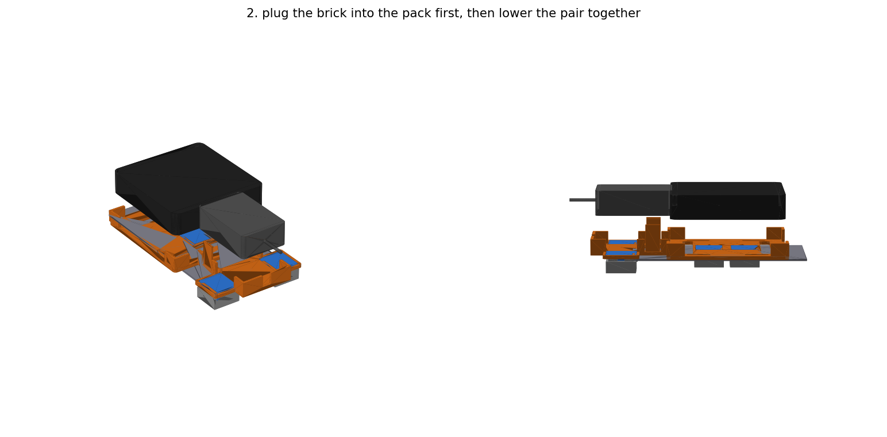
cad/Mounts/out/liteon_fit_step2.png
