AtlasAutoware/carv1/cad/Mounts/out/liteon_fit_steps.png

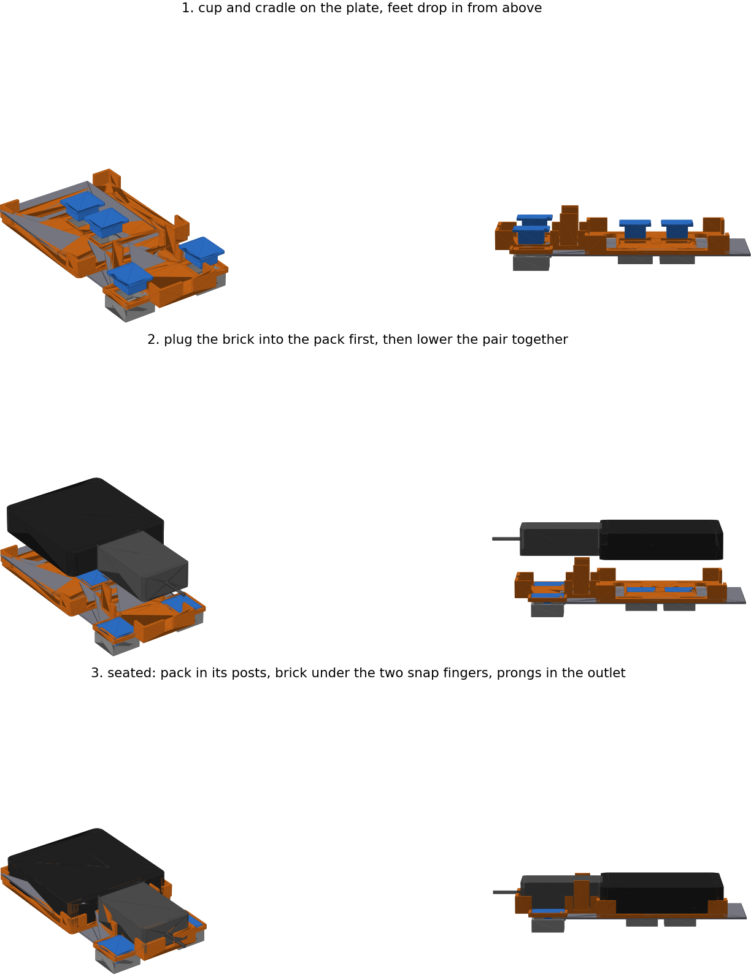
cad/Mounts/out/liteon_fit_steps.png
