AtlasAutoware/carv1/cad/Mounts/out/omni20_assembly.png

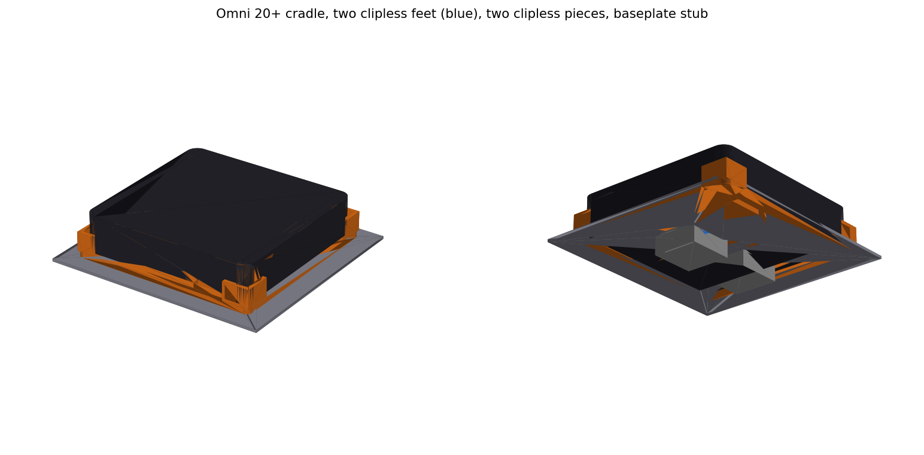
cad/Mounts/out/omni20_assembly.png
