AtlasAutoware/carv1/cad/Mounts/out/omni20_assembly_lines.png

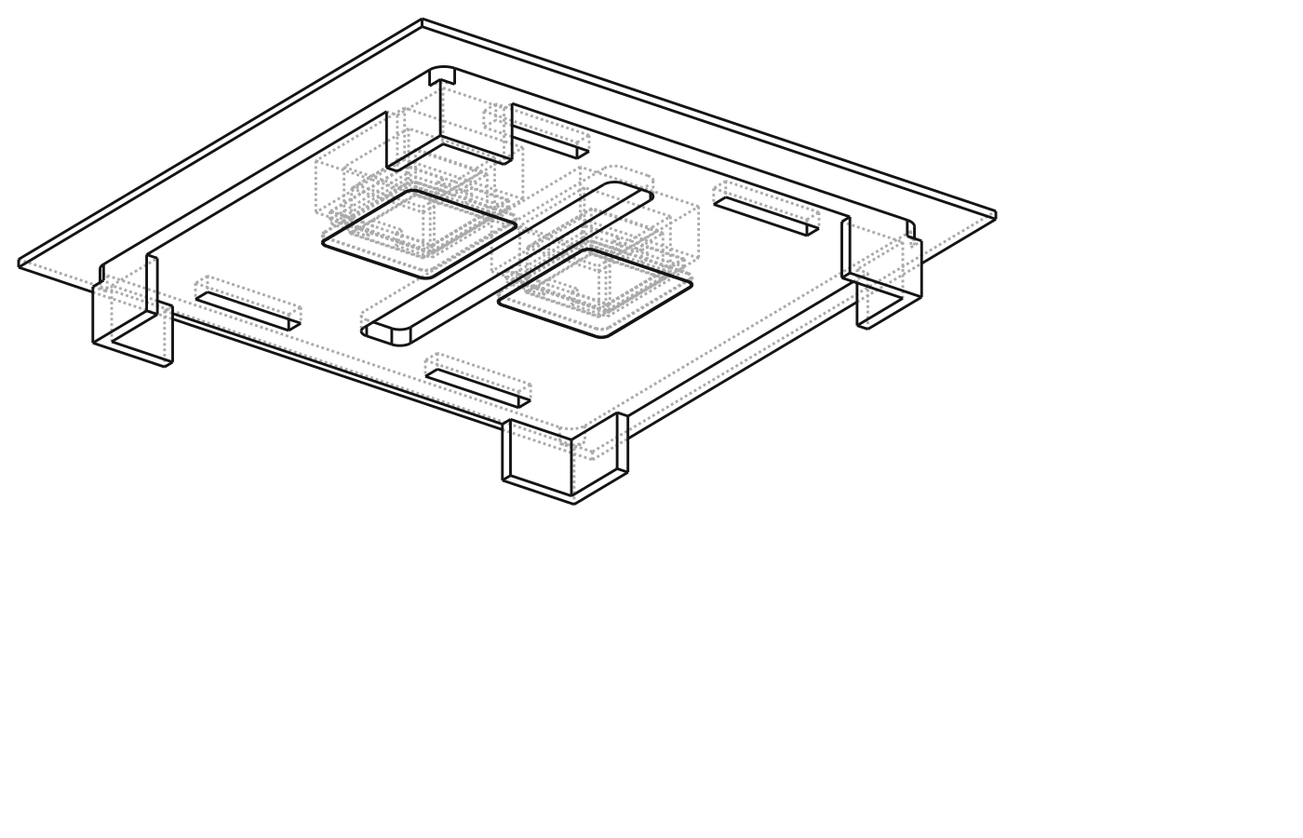
cad/Mounts/out/omni20_assembly_lines.png
