AtlasAutoware/carv1/cad/Mounts/out/power_board_mount_assembly_lines.png

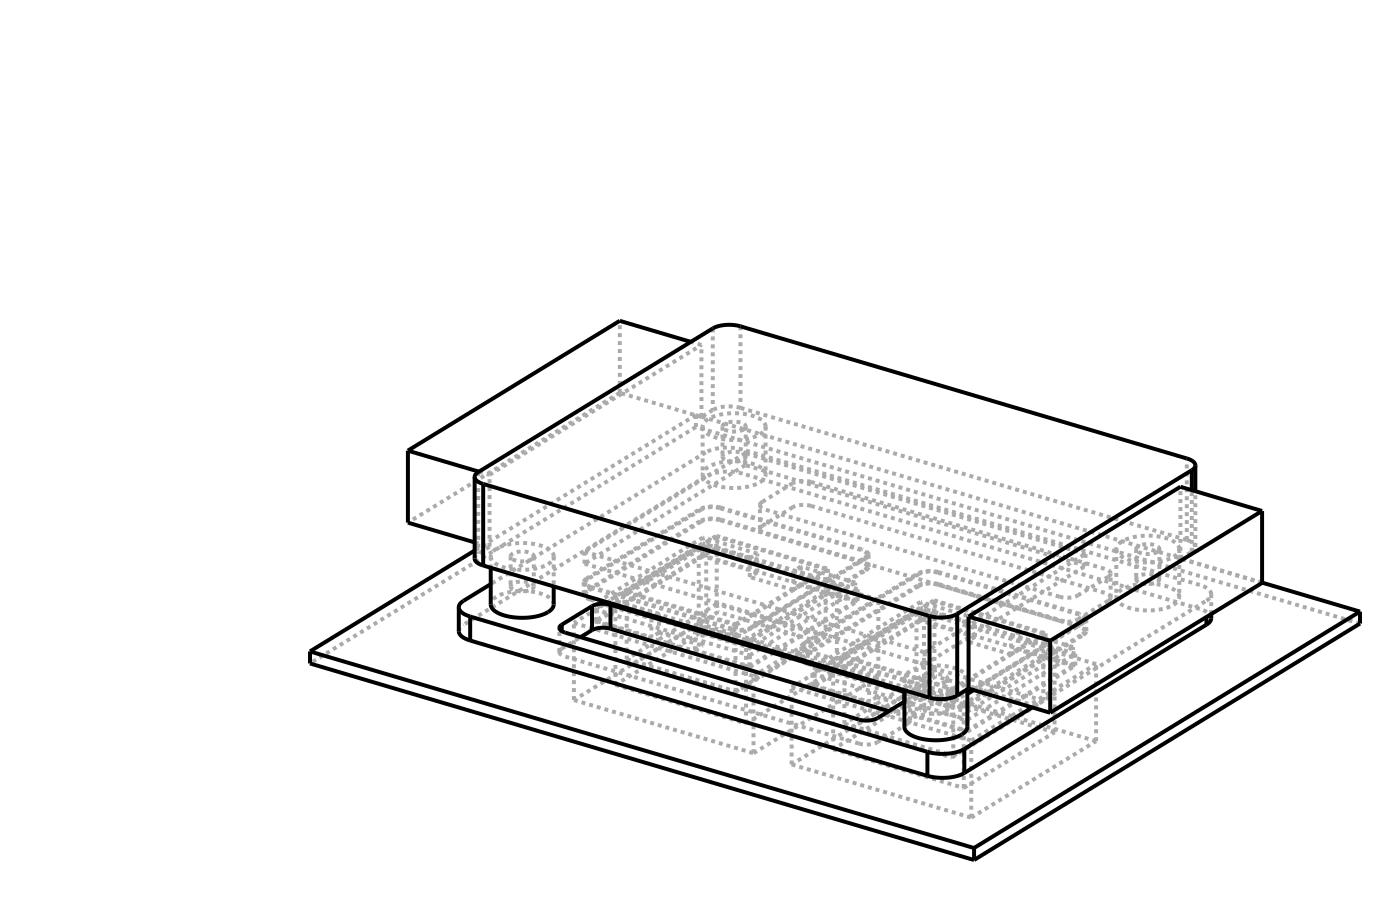
cad/Mounts/out/power_board_mount_assembly_lines.png
