AtlasAutoware/carv1/cad/Mounts/out/rplidar_c1_assembly.png

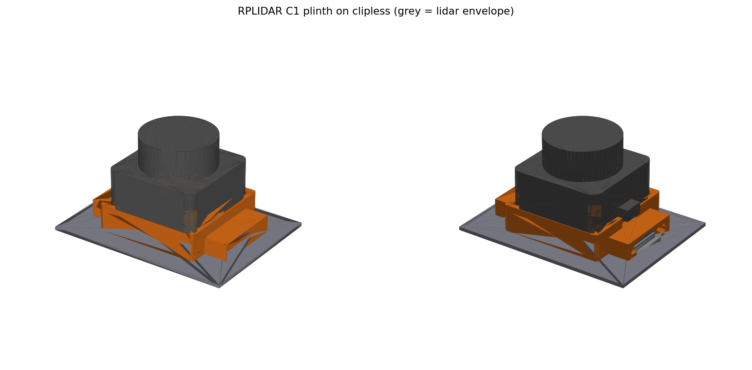
cad/Mounts/out/rplidar_c1_assembly.png
