AtlasAutoware/carv1/cad/Mounts/out/rplidar_c1_assembly_lines.png

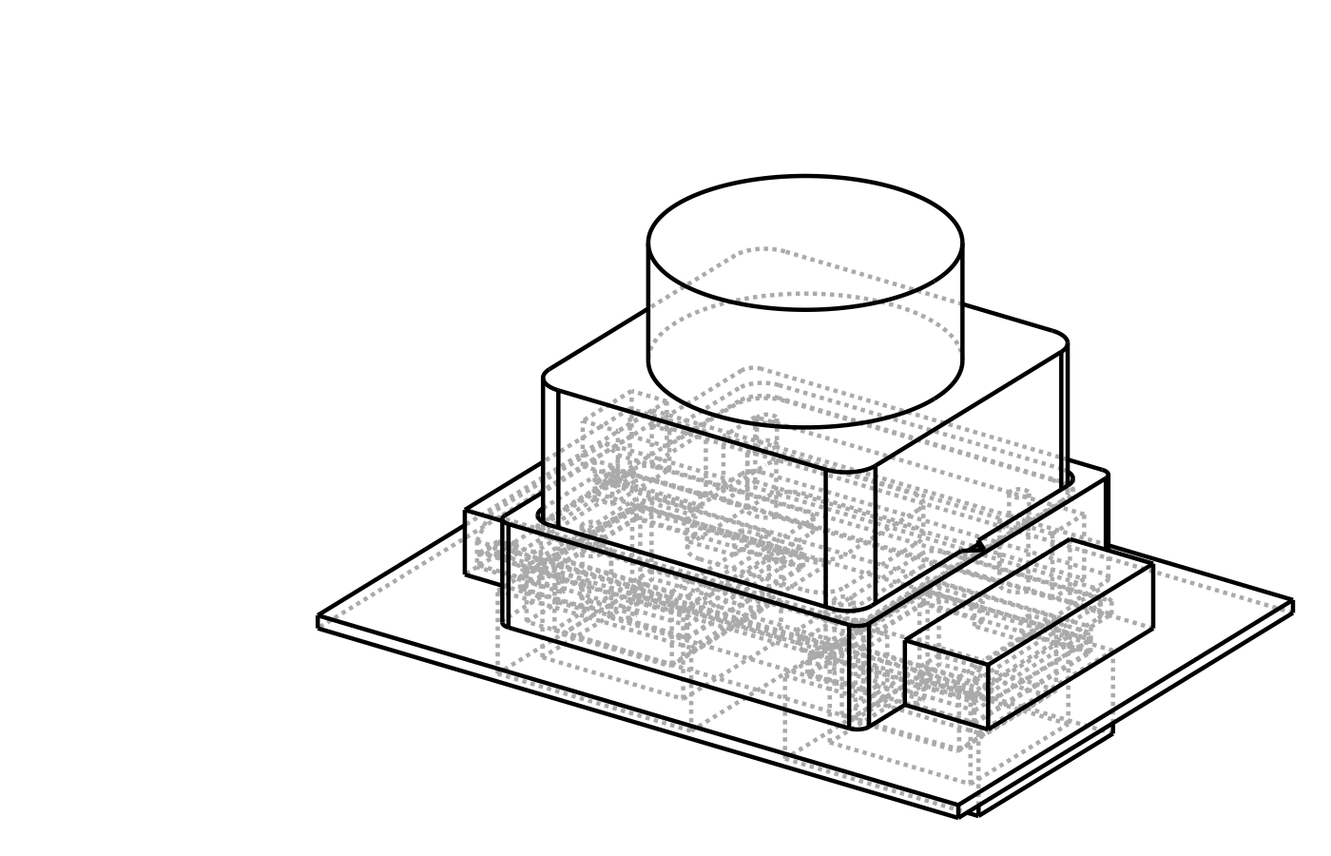
cad/Mounts/out/rplidar_c1_assembly_lines.png
