AtlasAutoware/carv1/cad/Mounts/out/rplidar_c1_v2_assembly_lines.png

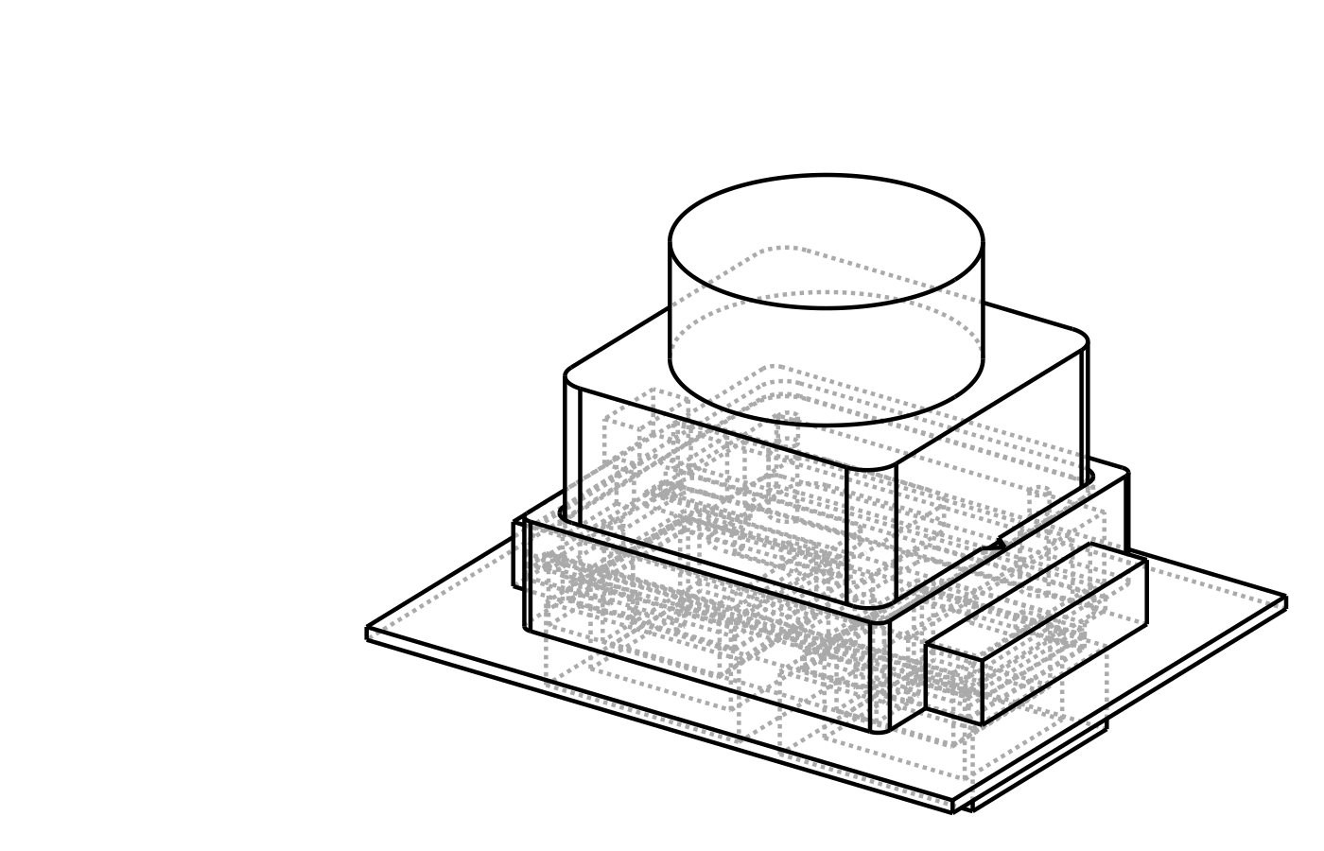
cad/Mounts/out/rplidar_c1_v2_assembly_lines.png
