AtlasAutoware/carv1/cad/Mounts/out/small_board_plate_assembly.png

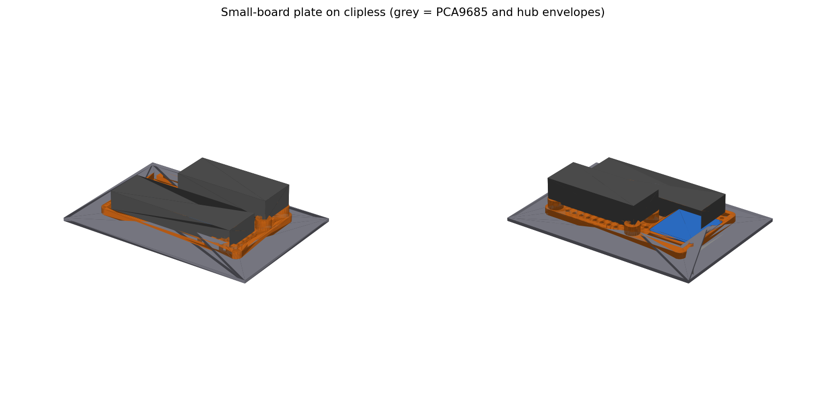
cad/Mounts/out/small_board_plate_assembly.png
