AtlasAutoware/carv1/cad/Mounts/out/small_board_plate_under_assembly_lines.png

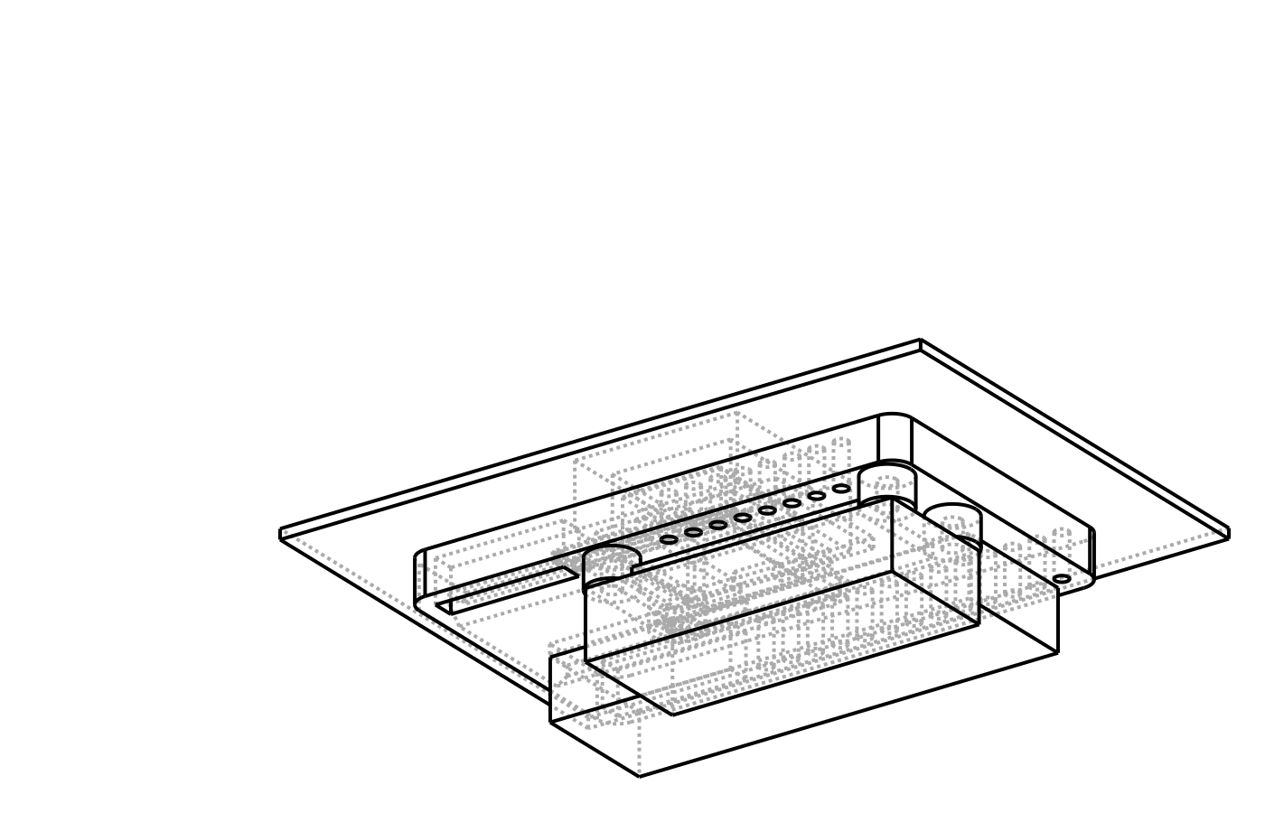
cad/Mounts/out/small_board_plate_under_assembly_lines.png
