AtlasAutoware/carv1/cad/Mounts/out/vesc_tub_bracket_assembly.png

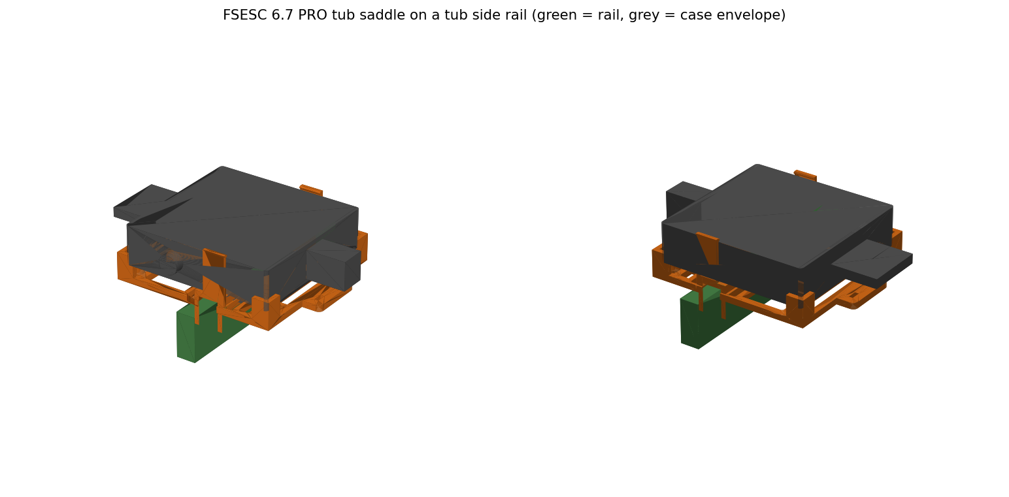
cad/Mounts/out/vesc_tub_bracket_assembly.png
