AtlasAutoware/carv1/cad/Mounts/out/vesc_tub_bracket_assembly_lines.png

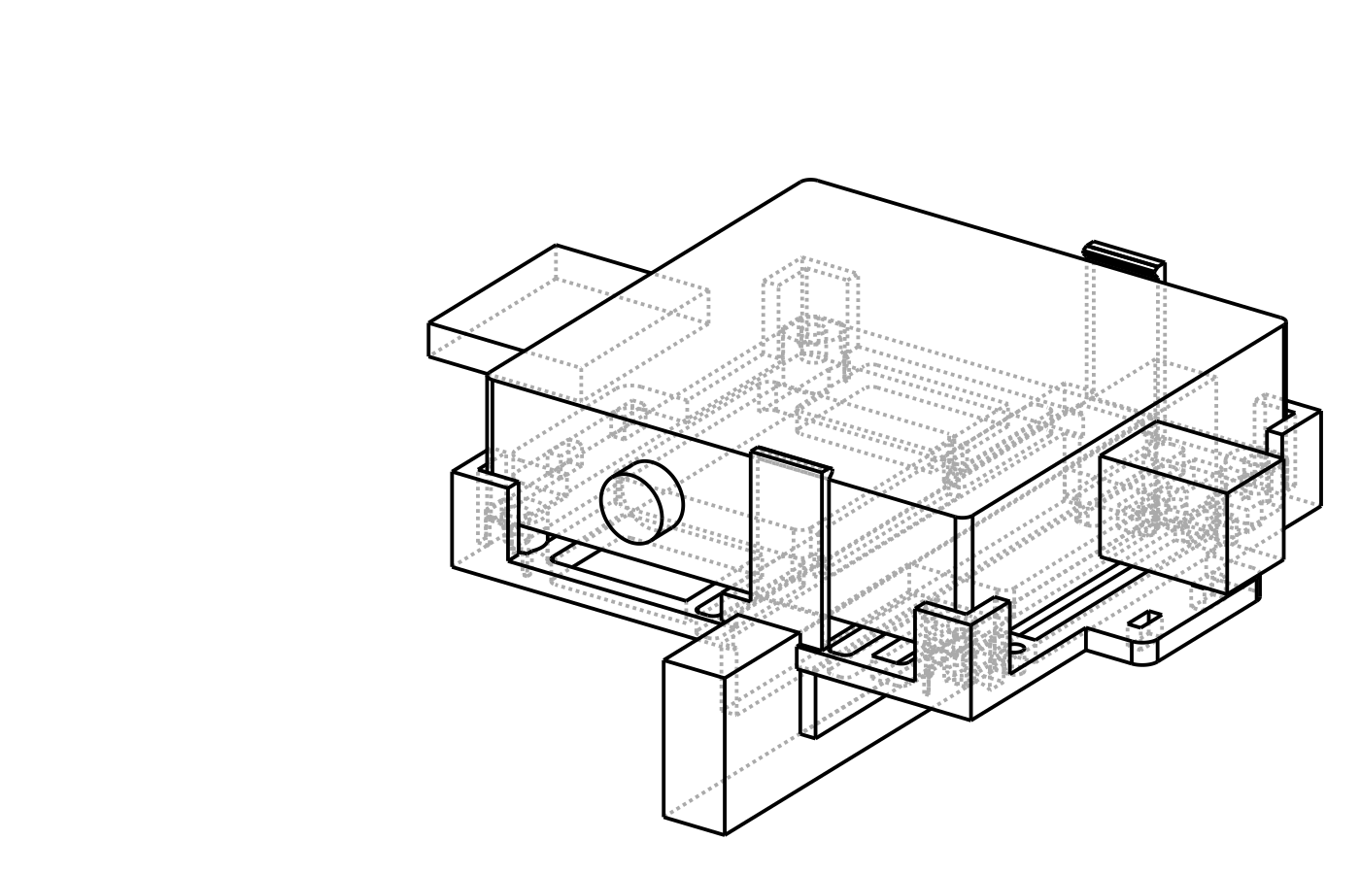
cad/Mounts/out/vesc_tub_bracket_assembly_lines.png
