AtlasAutoware/carv1/cad/Mounts/out/vesc_tub_bracket_posts_assembly_lines.png

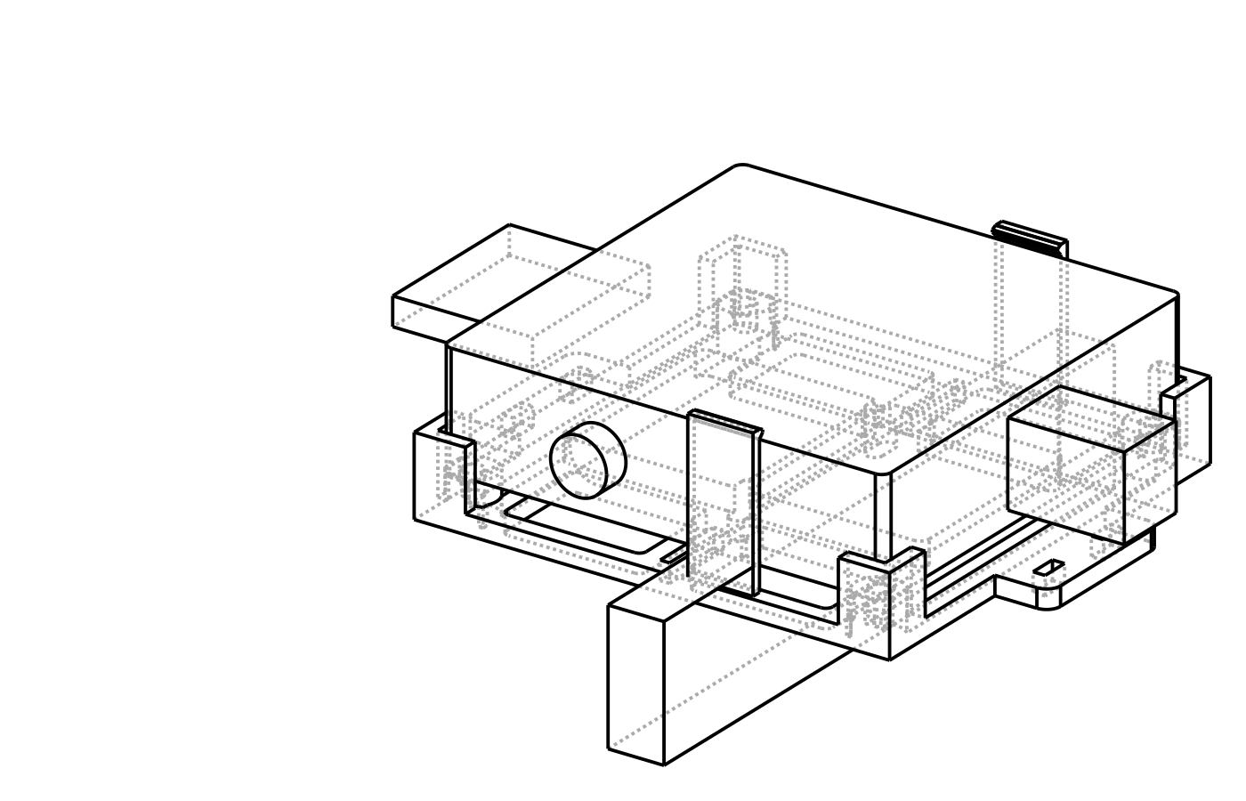
cad/Mounts/out/vesc_tub_bracket_posts_assembly_lines.png
