AtlasAutoware/carv1/cad/Mounts/out/_c1_debug.png

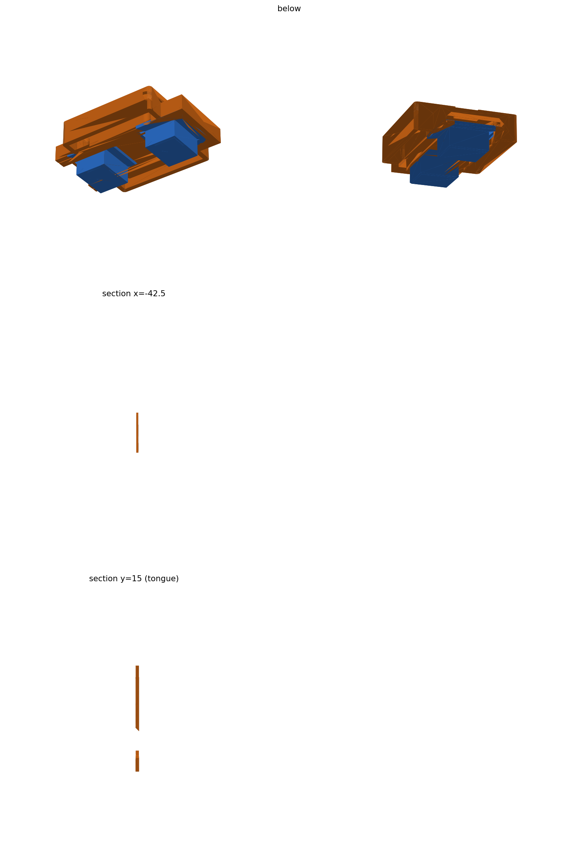
cad/Mounts/out/_c1_debug.png
