AtlasAutoware/carv1/cad/Electronics/out/AtlasPower4S/AtlasPower4S_schematic.pdf

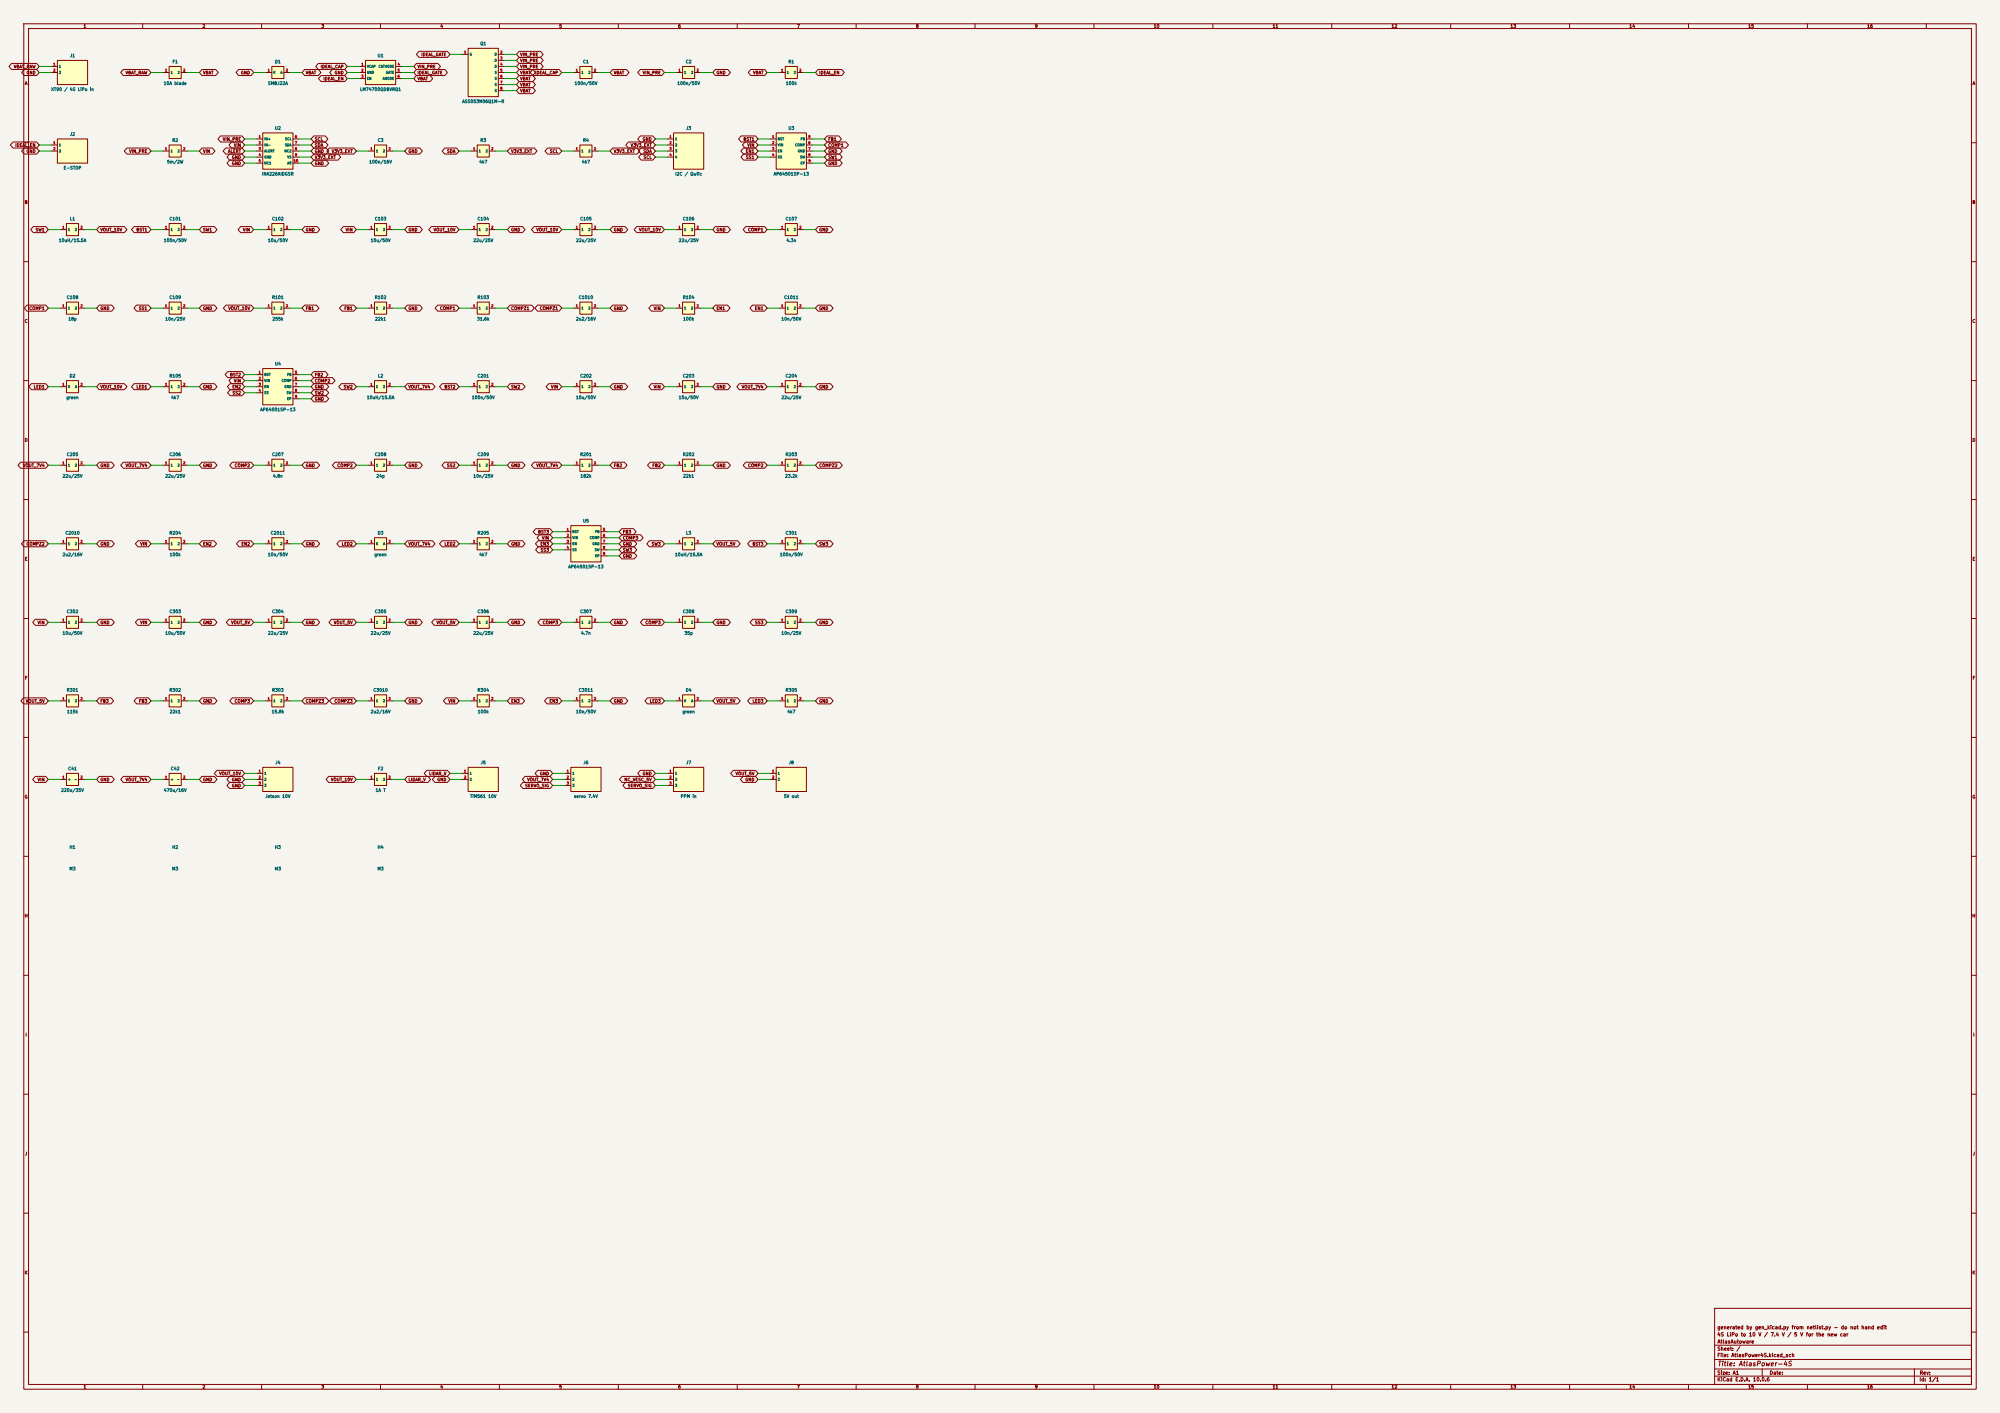
[picture p195: page 1]

4S LiPo to 10 V / 7.4 V / 5 V for the new car generated by gen_kicad.py from netlist.py - do not hand edit

Size: A1 | Rev:
KiCad E.D.A. 10.0.6 | Id: 1/1
