AtlasAutoware/carv1/cad/Mounts/out/fab/AtlasAutoware_Baseplate_v2_newcar.pdf

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

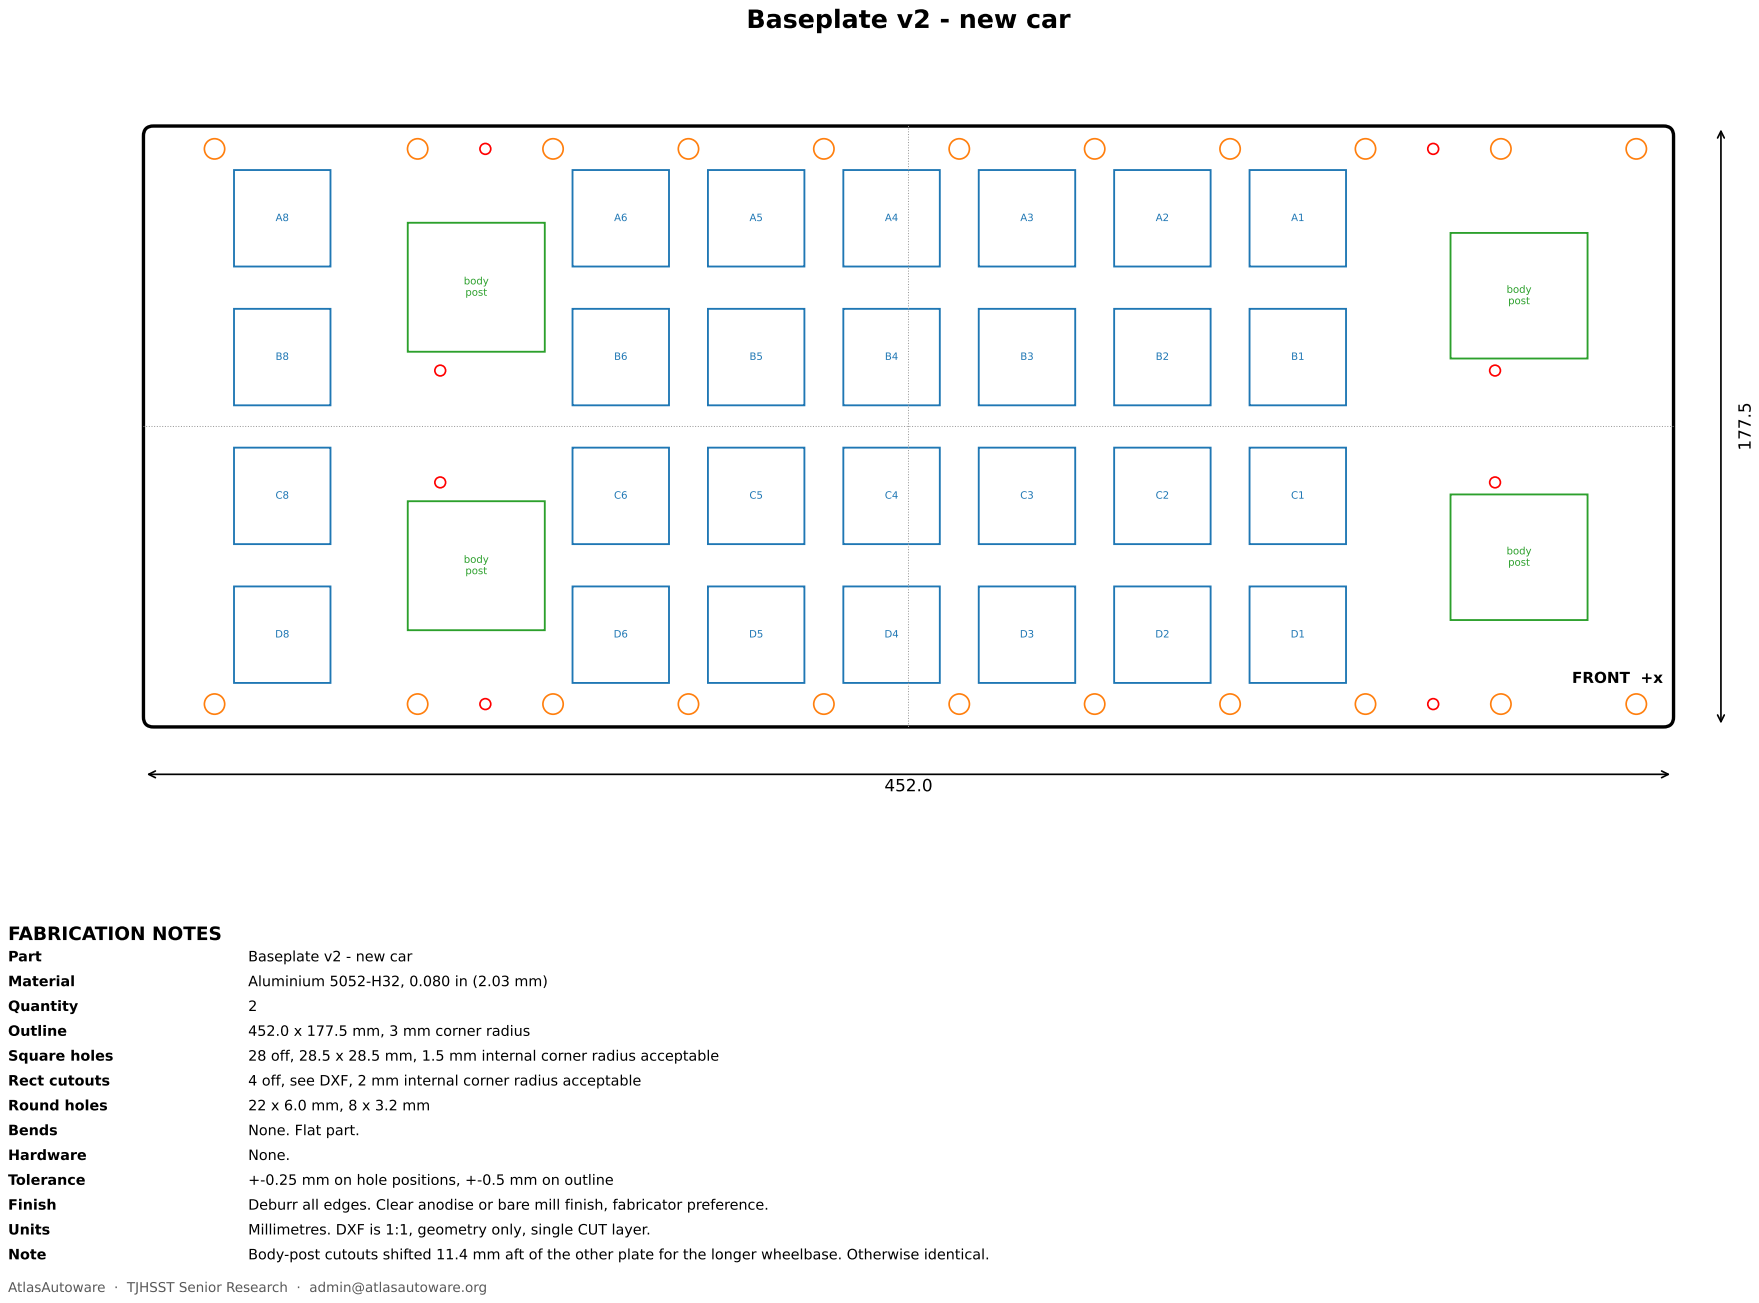
[picture p196: page 1]
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
