AtlasAutoware/carv1/cad/Mounts/out/fab/AtlasAutoware_Baseplate_v2_oldcar.pdf

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

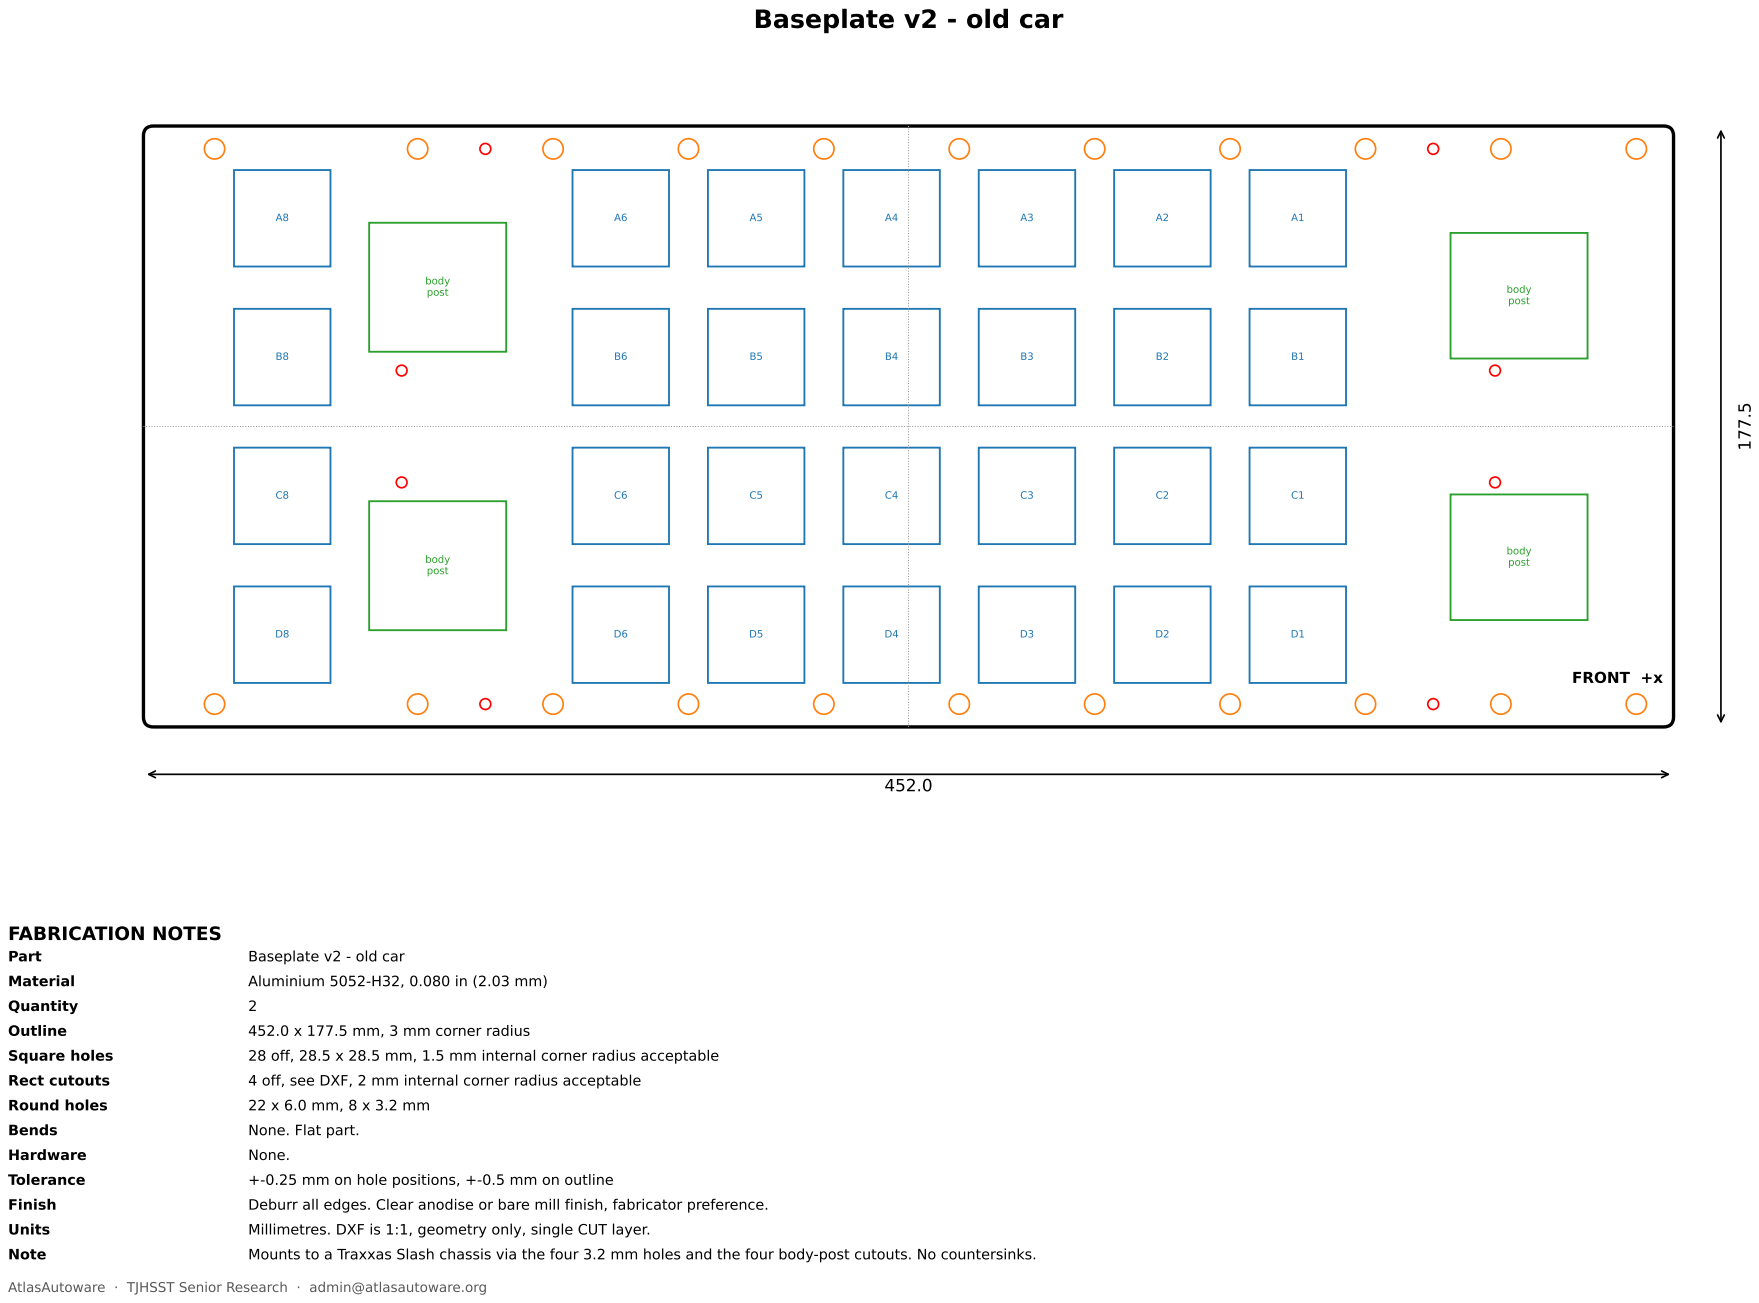
[picture p197: page 1]
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
