AtlasAutoware/carv1/cad/Electronics/out/AtlasPower4S/AtlasPower4S.kicad_pcb

## KiCad design cad/Electronics/out/AtlasPower4S/AtlasPower4S.kicad_pcb (2026-09-28)

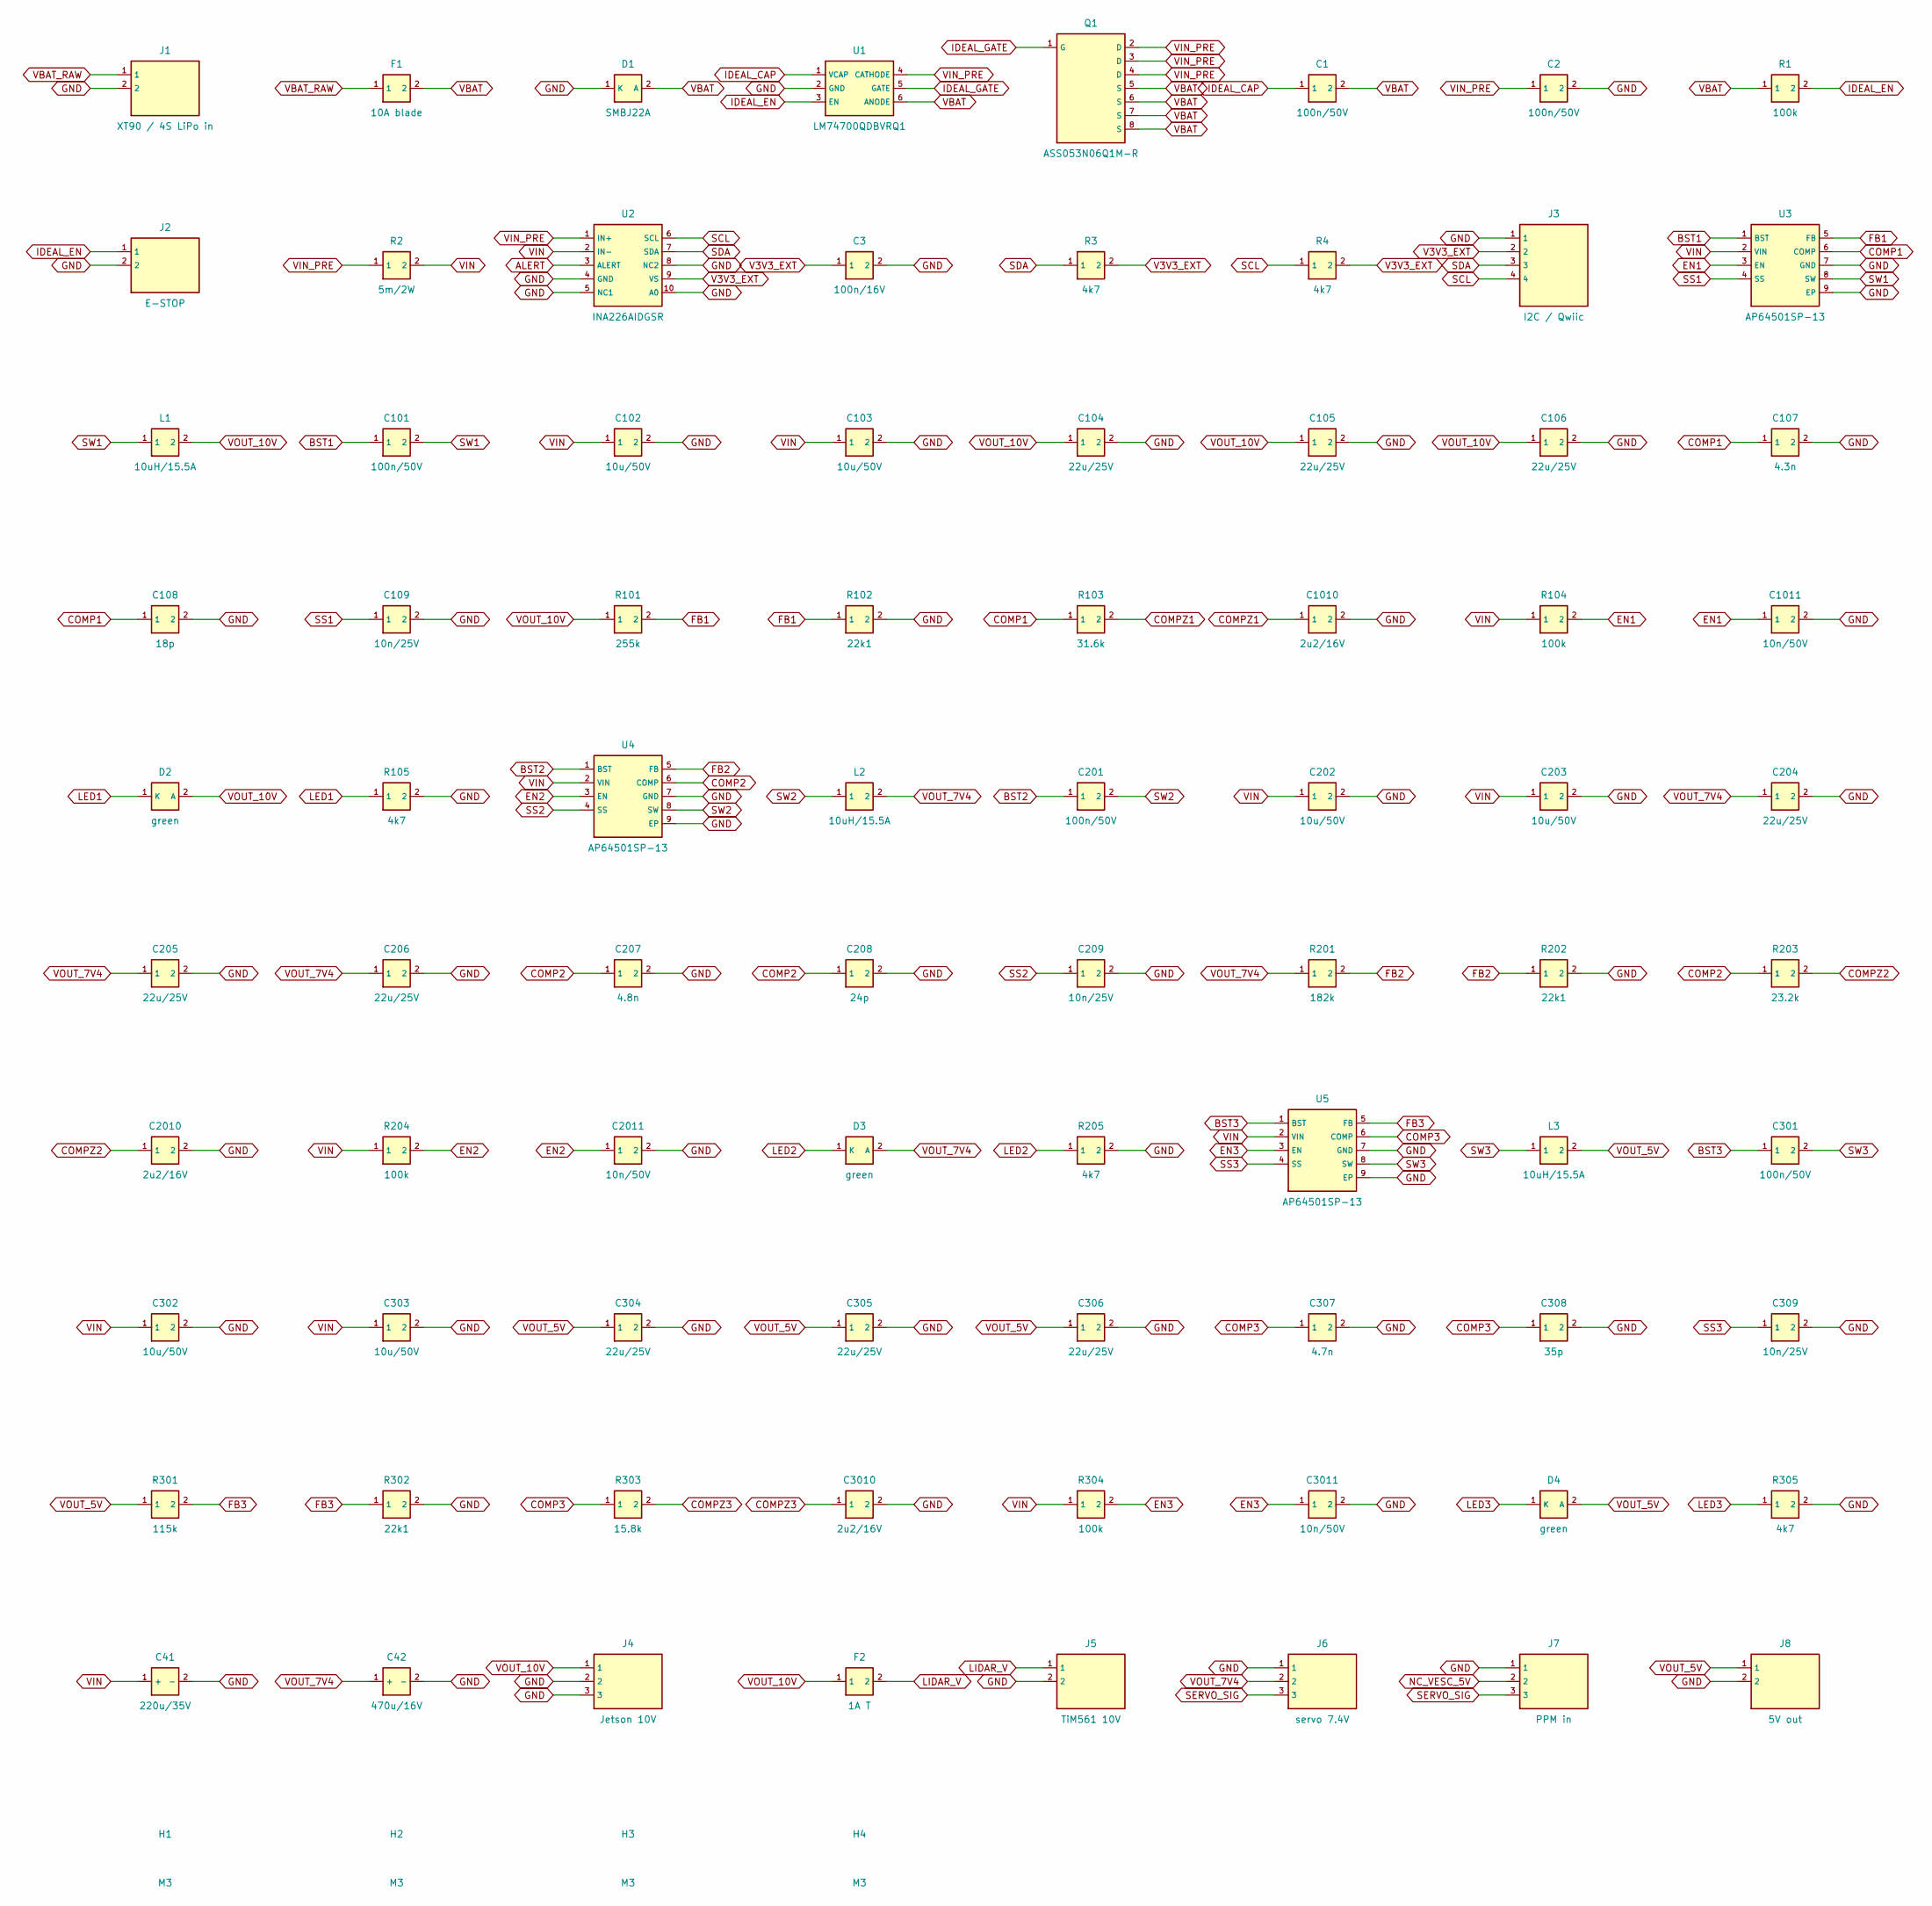
[picture p198: schematic AtlasPower4S.kicad_sch, AtlasPower-4S]

Parts:
C1, C2, C101, C201, C301: 100n/50V; C_0805_2012Metric
C3: 100n/16V; C_0805_2012Metric
C41: 220u/35V; CP_Elec_10x10.5
C42: 470u/16V; CP_Elec_10x10.5
C102, C103, C202, C203, C302, C303: 10u/50V; C_1210_3225Metric
C104, C105, C106, C204, C205, C206, C304, C305, C306: 22u/25V; C_1210_3225Metric
C107: 4.3n; C_0805_2012Metric
C108: 18p; C_0805_2012Metric
C109, C209, C309: 10n/25V; C_0805_2012Metric
C207: 4.8n; C_0805_2012Metric
C208: 24p; C_0805_2012Metric
C307: 4.7n; C_0805_2012Metric
C308: 35p; C_0805_2012Metric
C1010, C2010, C3010: 2u2/16V; C_0805_2012Metric
C1011, C2011, C3011: 10n/50V; C_0805_2012Metric
D1: SMBJ22A; D_SMB; LCSC C13964
D2, D3, D4: green; LED_0805_2012Metric
F1: 10A blade; Fuse_Blade_ATO_directSolder
F2: 1A T; Fuseholder_Clip-5x20mm_Keystone_3512P_Inline_P23.62x7.27mm_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
H1, H2, H3, H4: M3; MountingHole_3.2mm_M3
J1: XT90 / 4S LiPo in; TerminalBlock_Phoenix_MKDS-3-2-5.08_1x02_P5.08mm_Horizontal
J2: E-STOP; PinHeader_1x02_P2.54mm_Vertical
J3: I2C / Qwiic; JST_SH_SM04B-SRSS-TB_1x04-1MP_P1.00mm_Horizontal
J4: Jetson 10V; BarrelJack_Horizontal
J5: TiM561 10V; TerminalBlock_Phoenix_MKDS-1,5-2-5.08_1x02_P5.08mm_Horizont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
J6: servo 7.4V; PinHeader_1x03_P2.54mm_Vertical
J7: PPM in; PinHeader_1x03_P2.54mm_Vertical
J8: 5V out; TerminalBlock_Phoenix_MKDS-1,5-2-5.08_1x02_P5.08mm_Horizont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
L1, L2, L3: 10uH/15.5A; L_Bourns_SRP1265A; MPN SRP1265A-100M; LCSC C840531
Q1: ASS053N06Q1M-R; PowerPAK_SO-8_Single; MPN ASS053N06Q1M-R; LCSC C53896939
R1, R104, R204, R304: 100k; R_0805_2012Metric
R2: 5m/2W; R_2512_6332Metric; LCSC C2962780
R3, R4, R105, R205, R305: 4k7; R_0805_2012Metric
R101: 255k; R_0805_2012Metric
R102, R202, R302: 22k1; R_0805_2012Metric
R103: 31.6k; R_0805_2012Metric
R201: 182k; R_0805_2012Metric
R203: 23.2k; R_0805_2012Metric
R301: 115k; R_0805_2012Metric
R303: 15.8k; R_0805_2012Metric
U1: LM74700QDBVRQ1; SOT-23-6; MPN LM74700QDBVRQ1; LCSC C2941042
U2: INA226AIDGSR; MSOP-10-1EP_3x3mm_P0.5mm_EP1.68x1.88mm; MPN INA226AIDGSR; LCSC C49851
U3, U4, U5: AP64501SP-13; SOIC-8-1EP_3.9x4.9mm_P1.27mm_EP2.29x3mm; MPN AP64501SP-13; LCSC C2071517

Connections:
ALERT: U2.3 (ALERT)
BST1: C101.1, U3.1 (BST)
BST2: C201.1, U4.1 (BST)
BST3: C301.1, U5.1 (BST)
COMP1: C107.1, C108.1, R103.1, U3.6 (COMP)
COMP2: C207.1, C208.1, R203.1, U4.6 (COMP)
COMP3: C307.1, C308.1, R303.1, U5.6 (COMP)
COMPZ1: C1010.1, R103.2
COMPZ2: C2010.1, R203.2
COMPZ3: C3010.1, R303.2
EN1: C1011.1, R104.2, U3.3 (EN)
EN2: C2011.1, R204.2, U4.3 (EN)
EN3: C3011.1, R304.2, U5.3 (EN)
FB1: R101.2, R102.1, U3.5 (FB)
FB2: R201.2, R202.1, U4.5 (FB)
FB3: R301.2, R302.1, U5.5 (FB)
GND: C2.2, C3.2, C41.2 (-), C42.2 (-), C102.2, C103.2, C104.2, C105.2, C106.2, C107.2, C108.2, C109.2, C202.2, C203.2, C204.2, C205.2, C206.2, C207.2, C208.2, C209.2, C302.2, C303.2, C304.2, C305.2, C306.2, C307.2, C308.2, C309.2, C1010.2, C1011.2, C2010.2, C2011.2, C3010.2, C3011.2, D1.1 (K), J1.2, J2.2, J3.1, J4.2, J4.3, J5.2, J6.1, J7.1, J8.2, R102.2, R105.2, R202.2, R205.2, R302.2, R305.2, U1.2 (GND), U2.4 (GND), U2.5 (NC1), U2.8 (NC2), U2.10 (A0), U2.11, U3.7 (GND), U3.9 (EP), U4.7 (GND), U4.9 (EP), U5.7 (GND), U5.9 (EP)
IDEAL_CAP: C1.1, U1.1 (VCAP)
IDEAL_EN: J2.1, R1.2, U1.3 (EN)
IDEAL_GATE: Q1.1 (G), U1.5 (GATE)
LED1: D2.1 (K), R105.1
LED2: D3.1 (K), R205.1
LED3: D4.1 (K), R305.1
LIDAR_V: F2.2, J5.1
NC_VESC_5V: J7.2
SCL: J3.4, R4.1, U2.6 (SCL)
SDA: J3.3, R3.1, U2.7 (SDA)
SERVO_SIG: J6.3, J7.3
SS1: C109.1, U3.4 (SS)
SS2: C209.1, U4.4 (SS)
SS3: C309.1, U5.4 (SS)
SW1: C101.2, L1.1, U3.8 (SW)
SW2: C201.2, L2.1, U4.8 (SW)
SW3: C301.2, L3.1, U5.8 (SW)
V3V3_EXT: C3.1, J3.2, R3.2, R4.2, U2.9 (VS)
VBAT: C1.2, D1.2 (A), F1.2, Q1.5 (S), Q1.6 (S), Q1.7 (S), Q1.8 (S), R1.1, U1.6 (ANODE)
VBAT_RAW: F1.1, J1.1
VIN: C41.1 (+), C102.1, C103.1, C202.1, C203.1, C302.1, C303.1, R2.2, R104.1, R204.1, R304.1, U2.2 (IN-), U3.2 (VIN), U4.2 (VIN), U5.2 (VIN)
VIN_PRE: C2.1, Q1.2 (D), Q1.3 (D), Q1.4 (D), R2.1, U1.4 (CATHODE), U2.1 (IN+)
VOUT_5V: C304.1, C305.1, C306.1, D4.2 (A), J8.1, L3.2, R301.1
VOUT_7V4: C42.1 (+), C204.1, C205.1, C206.1, D3.2 (A), J6.2, L2.2, R201.1
VOUT_10V: C104.1, C105.1, C106.1, D2.2 (A), F2.1, J4.1, L1.2, R101.1

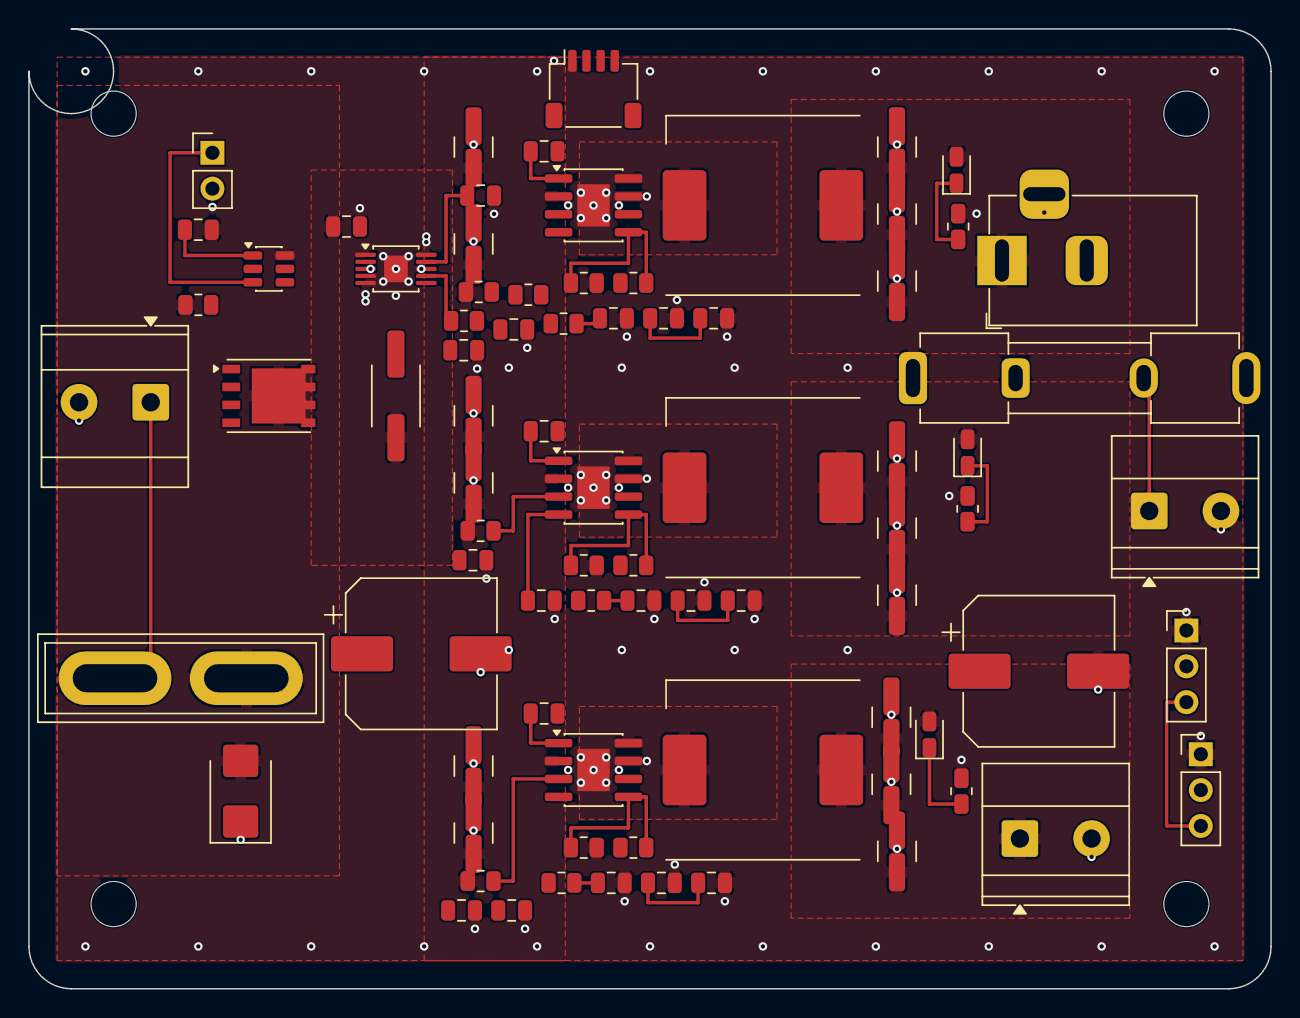
[picture p199: board AtlasPower4S.kicad_pcb from above]

Board: 4 copper layers, 88.0 x 68.0 mm, 84 parts (0 on the bottom side), 40 nets.
