AtlasAutoware/carv1/(commit log)

2026-09-28 README: describe carv1 as the combined software + CAD repo
2026-09-30 Workstation run: load the demos in pieces, stop instead of crash-looping when training fails
    The extended route-hint run (2400 episodes, ~55 GB once loaded) ran the 62 GB
    workstation out of memory: load_shards() holds every shard and then
    concatenates. train_policy.py now streams the shards once into an on-disk
    cache (data/_cache/<sig>/): camera frames in one memory-mapped uint8 file, the
    small arrays as .npy. Same rows, order, stop-frame filter and train/val split;
    batches are read two ahead by a background thread. Shared by all seeds.
    When training failed, run_route.sh still evaluated the missing student.onnx and
    sim_rollout.py's pool respawned crashing workers forever (CPU pegged, 3.6 GB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
2026-10-05 camera_perception: subscribe to the camera with sensor-data QoS
    The OAK-D (and Orbbec) drivers publish images best-effort; the detector asked for a
    reliable subscription, which DDS treats as incompatible, so it never received a frame
    ("offering incompatible QoS ... RELIABILITY" in the log). Found during the T12 bench run.
    Claude-Session: https://claude.ai/code/session_01XLWJVeNBfFtTnguYaznLXY
2026-10-05 Car link on two TP-Link T3Us: driver install, hotspot on the T3U, docs
    - install_t3u_driver.sh: NVIDIA's kernel has no rtw88; build lwfinger/rtw88 for the T3U,
    firmware uncompressed, USB 2 mode, US Wi-Fi rules at boot.
    - carnet.sh: the hotspot runs on the T3U when it is plugged in (2.4 GHz ch 6, 20 MHz,
    WPA3-SAE + PMF, CCMP), hotspot5 for 5 GHz ch 149, onboard-card fallback on ch 149
    (ch 36 is No-IR when the onboard card boots without a country), station modes on the
    onboard card so the car can join a router while hosting AtlasCar.
    - REMOTE.md / RUNBOOK.md: the T3U pair, the laptop profile (BSSID lock stops the
    background scans that stalled the link ~100 ms every few seconds), benc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
2026-10-05 Pilot page video from the OAK-D's own encoder, decoded in the browser; Wi-Fi priority
    - oakd_camera: video_kbps > 0 adds the camera's hardware H.264 (or H.265) encoder on
    /oakd/video (CompressedImage, one Annex-B access unit per message): baseline profile,
    CBR, keyframe every 15 frames, ISP scaled to 640x360 so it matches /oakd/rgb. The Jetson
    only forwards bytes. Logs capture-to-host latency and the bitrate every 10 s.
    - web_pilot: GET /vstream sends the frames length-prefixed; a viewer that falls more than
    6 frames behind skips to the newest keyframe (latency first). The page decodes with
    WebCodecs onto a canvas and falls back to MJPEG when the camera is not encoding or the
    bro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
2026-10-05 Docs and a tunnel helper for the on-camera video path
    - REMOTE.md: how the H.264 path works, why the page needs localhost for WebCodecs, the
    Wi-Fi priority marking, the measured numbers, and why wfb-ng is not used on rtw88.
    - RUNBOOK.md: pilot video note; the USB -71 errors after a power cut and the fix.
    - tools/pilot_tunnel.sh: opens the pilot page at http://localhost:8081/ over SSH
    (IPQoS=ef so the driving commands are not in the background queue).
    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
2026-10-05 unicron: shard the extended route-hint run and make it survive SIGKILL
    ml/shard_run.py runs the ws_route_extended.sh recipe (2400 expert demos, 50 epochs,
    5 seeds, selection on task seed 3000) as 83 restartable shards: 48 collect shards,
    3 merges, the data cache, 5 seeds trained in parallel on separate GPUs, 25 evals and
    the selection. Every output is written to a temp file and renamed; a killed shard
    restarts and resumes; each running shard holds a lock, so shards left running by a
    killed orchestrator are adopted, never started twice. The orchestrator is a systemd
    user service (Restart=on-failure) plus a 2-minute timer, kept in /run/user because
    the CSL home is Kerberos NFS. ml/unicron/kill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
2026-10-05 Unattended steering and odometry calibration; apply the 10/5 results
    tools/auto_calibrate.py drives a short scripted sequence in a hallway (arcs and
    straights at the slowest erpm speed, ~1 m/s) and measures:
    - steering: yaw rate from the OAK-D gyro, projected on the gravity axis (the
    camera's IMU is mounted on its side, so its z axis is not vertical), gives the
    real steering angle per segment; a line through (servo, angle) gives the
    servo offset and gain for vesc.yaml.
    - odometry sign and scale: /odom while rolling forward, against the motion the
    lidar measures by aligning scans taken at rest before and after each segment.
    - a gyro-vs-lidar rotation check.
    It checks every segment's p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
    [vesc.yaml]
2026-10-05 rplidar: undo the front-to-back mirrored /scan in the driver
    /scan from rplidar_ros came out mirrored front to back: in a hallway, a wall
    2.3 m behind the car showed up 2.3 m ahead while the side walls stayed on
    their sides (angle t in the scan was really 180 - t). In rplidar_node.cpp,
    inverted reverses the sample order (t -> -t) and flip_x_axis shifts it by half
    a turn (t -> t + 180); together a sample at t lands at 180 - t, which undoes
    the mirror. Set both in bringup_launch.py.
    Checked on the car while it was driven around (tools: lidar_live_check, scans
    0.5 s apart aligned with ICP): the lidar's rotation agreed in sign with the
    gyro in 11 of 11 turning intervals (e.g. +30.1 deg gyro, +2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
    [auto_calibrate.py, lidar_live_check.py]
2026-10-05 RUNBOOK: calibrated values, the unattended calibration, lidar orientation
    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
2026-10-05 Car conditions in the sim; policy_bridge fixes for the real car
    The route-hint models were trained and scored in a sim that differs from car 1:
    the laser sits 0.27 m and the camera 0.30 m ahead of the rear axle (the sim had
    both at the axle), ackermann_to_vesc runs erpm mode (nothing between 0 and
    0.78 m/s, /drive 1.0 = 1.03 m/s), the motor lags (60 ms, ~2 m/s^2 ramp, from the
    10/5 auto_calibrate logs), the right lock is 0.25 rad until the servo horn is
    re-centred, the C1 drops ~19% of its bins, the hint comes from a noisy, lagged
    SLAM pose, and a collision is any part of the body.
    - ml/car_model.py + sim_rollout --car <preset> [--car-set k=v]: all of the
    above, in eval and collect (DAgge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
2026-10-05 auto_calibrate: --target for runs above 1 m/s (fast plan); tested on a simulated car
    /drive speed is not the wheel speed in erpm mode (0.3 -> 0.80 m/s), so --target
    takes the speed at the wheels and converts it with vesc.yaml's mapping. Above
    ~1 m/s the run switches to a fast plan sized from the 10/5 logs (60 ms dead
    time, ~2 m/s^2 ramp, braking assumed 1.5 m/s^2 for margins): longer segments
    so the car reaches cruise, steering angles chosen so each arc turns the car
    only ~9 and ~15 degrees, the path check plans with the modelled distance plus
    20% and a speed-sized roll-out, the front e-stop distance grows with speed
    (1.15 m at 1.3 m/s, 1.37 m at 1.5) and looks down a +-12 deg cone, and no
    t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
2026-10-05 auto_calibrate: speed-sized plan and margins for anything faster than the stock 0.8 m/s
    The fast plan now starts at 0.85 m/s, not 1.05: at 1.0 m/s the stock 0.6 m
    front e-stop would leave ~0.07 m short of the bumper once the 60 ms dead time
    and ~1.6 m/s^2 braking are counted. The stock run (--speed 0.3) is unchanged.
    Simulated-car test: the IMU now tilts the gyro with gravity as the real OAK-D
    does, and the fast plan is checked at 0.9, 1.1, 1.3 and 1.5 m/s (no contact,
    centre within 0.0001, gain within 0.5%).
    Claude-Session: https://claude.ai/code/session_01L1t4A3MHHvwdPYwjmFhxci
    [auto_calibrate.py]
